GSimas/EEL7801/site/images/paloma1.jpg

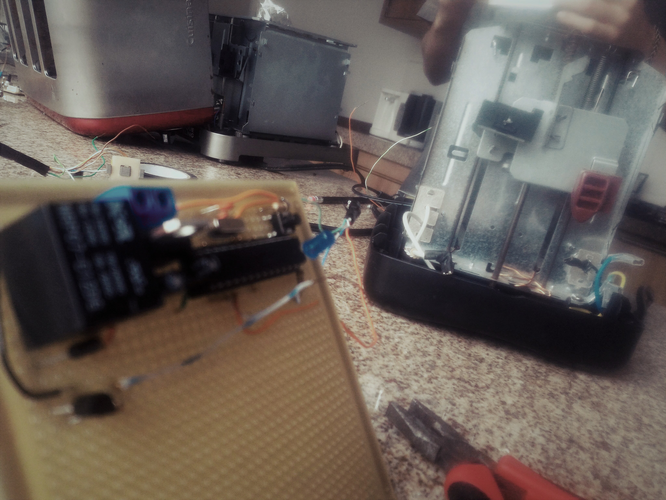
site/images/paloma1.jpg
