GSimas/EEL7801/site/images/code-min.jpg

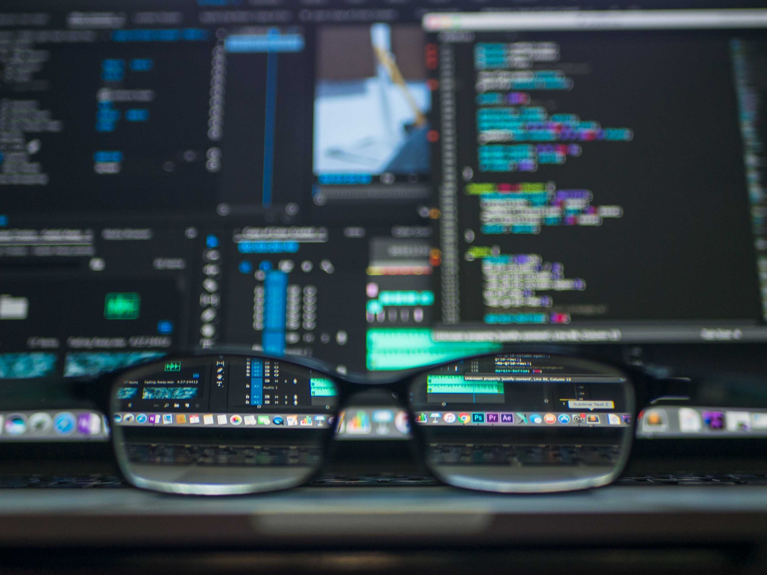
site/images/code-min.jpg
