GSimas/EEL7801/README.md

## ***EEL7801 - Projeto em Eletrônica Nível I***

> “The first thing you have to look at is **why**
you want to design something. Without
that you cannot have success. Then
you work out the **how** and then the
**what**...” - **Camille Kokozaki**

**Website do Repositório:** [EEL7801](https://gsimas.github.io/EEL7801/)

**Curso**: [Engenharia Eletrônica](http://cagr.sistemas.ufsc.br/relatorios/curriculoCurso?curso=235) - Universidade Federal de Santa Catarina ([UFSC](ufsc.br)), Florianópolis, SC, Brasil

**Ementa**: Desenvolver habilidades de trabalho em equipe e de auto-aprendizagem a partir da solução de
problemas encontrados na sociedade, cujas soluções passem pela aplicação de métodos e técnicas da engenharia
eletrônica.

**Horas-Aula:** 54

**Nome do Projeto**: P.A.L.O.M.A. (Projeto de Aquecedor Local Operado por Microcontrolador ATMEGA)

**Integrantes do Grupo**:

- [André Martins Pio de Mattos](https://github.com/andrempmattos)
- [Gustavo Simas da Silva](https://github.com/GSimas)
- Ygor Gaspar Pereira

**Dependências**

- Python (3 ou superior)
- Jupyter Notebook
- Arduino (arquivos .ino)

**Lista de Tarefas**

- [x] Bibliotecas e código de apresentação
- [x] Componentes básicos (Arduino, relé, switch de contato, placa fenolite, ...)
- [x] Decidir/Construir/Adaptar estrutura
- [x] Verificar e testar resistência (desmontar e consertar torradeira)
- [x] Componentes adicionais (resistores, transistores, capacitores, ...)
- [x] Arrumar emenda de resistência
- [x] Verificar e consertar problema de contato com malha de terra
- [x] Analisar sistema para controle (~~desligamento de transformador~~, relé)
- [x] Ajustes em código (sistema de controle, segurança)
- [x] **Primeiro Protótipo (05/10)**
- [x] Aquisição de materiais adicionais (fita kapton, placa de mica, jumpers, dobradiça)
- [x] Confecção em PCB / Placa padrão com ilhas
- [x] Troca de placa de mica danificada
- [x] Troca de componentes danificados (ATMEGA, 7805, LED)
- [x] Ajustes na placa da torradeira (relé, botão cancela bobina, separação controle/aquecimento)
- [x] Integração fonte celular (9V / 12V) + PCB desenvolvida + placa torradeira
- [x] Pintar Tampa, posicionar switch
- [x] Inserção do Display LCD na estrutura da torradeira
- [x] Posicionamento do 1º sensor de temperatura
- [x] Consertar Formulário de Contato do site
- [x] **Segundo Protótipo (09/11)**
- [ ] Posicionamento do 2º sensor de temperatura
- [ ] Reunião Conaq/Professor sobre Pasteurização
- [ ] Fixar alavanca para não atingir placa frontal
- [x] Ajustar resistores para contraste do Display
- [x] Aplicar fita Kapton em partes restantes para isolamento
- [x] Modificações código (funções não-recursivas, timer, calibração, escada invertida)
- [x] Elaborar Curvas de Aquecimento
- [x] Adaptações e testes finais (validação)
- [x] **Terceiro Protótipo/Versão Definitiva (23/11)**
- [x] Documentação (Tutorial - usuário e desenvolvedor)
- [x] Finalização do site
- [x] **Apresentação Final (23/11 ou 30/11)**
- [ ] Aperfeiçoamentos pós-semestre

Referências:

- [Prof. Fernando Rangel de Sousa](http://rangel.paginas.ufsc.br/)
- [Empresa Júnior CONAQ](http://conaq.com.br/)
- [Minhas Engenhocas](https://minhasengenhocas.wordpress.com/)
- [Prof. Aldo von Wangenheim](http://www.inf.ufsc.br/~aldo.vw/)

UFSC CTC
