GSimas/EEL7801/Apresentacoes/Cronograma Projeto Eletronica I.png

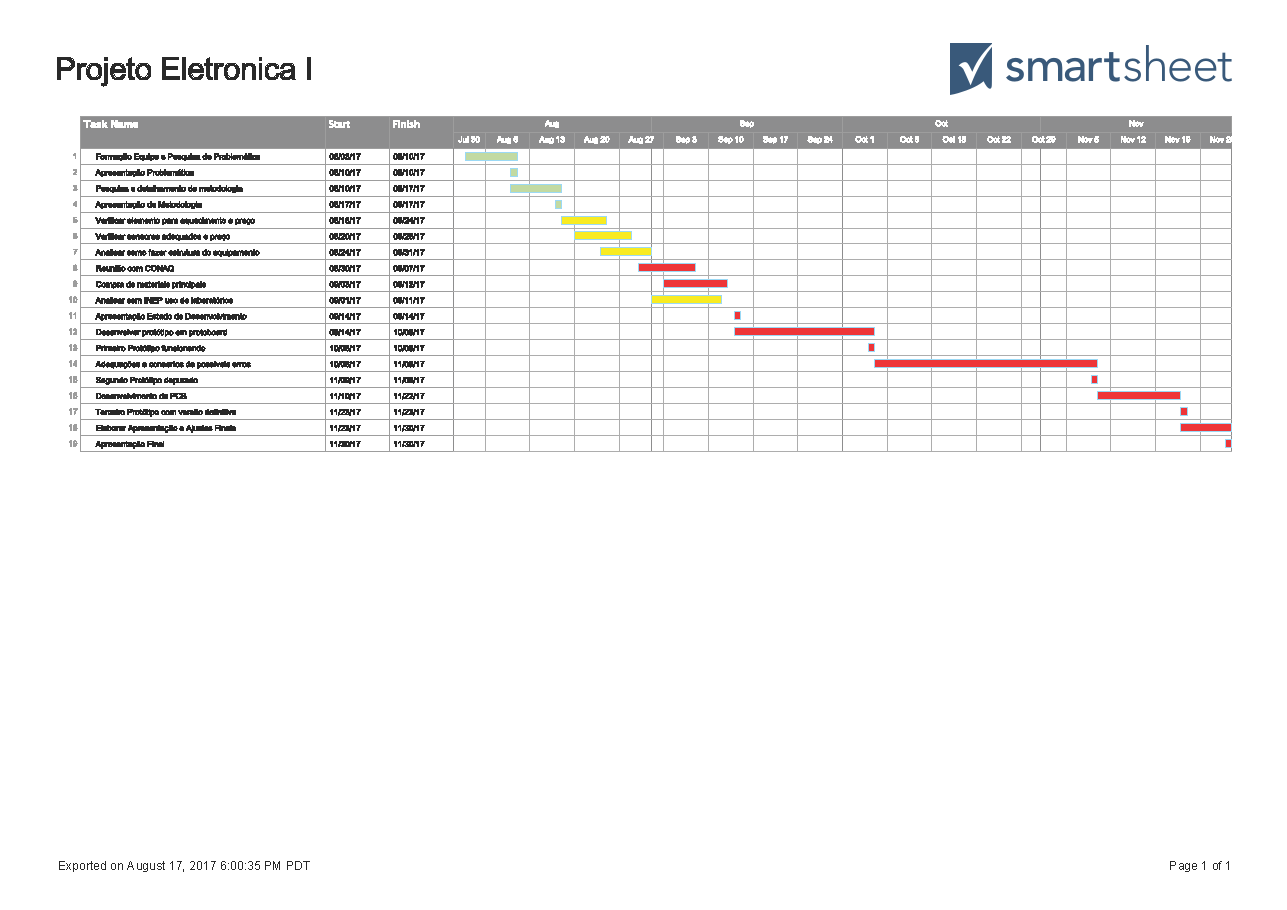
Apresentacoes/Cronograma Projeto Eletronica I.png
