GSimas/EEL7801/Imagens/IMG-20171001-WA0016.jpg

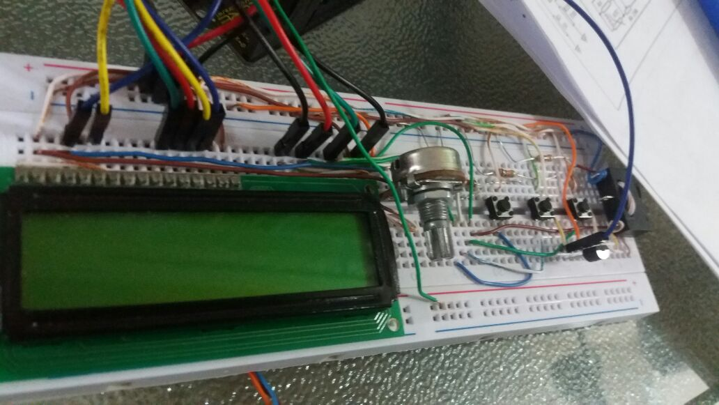
Imagens/IMG-20171001-WA0016.jpg
