GSimas/EEL7801/Imagens/IMG-20171001-WA0017.jpg

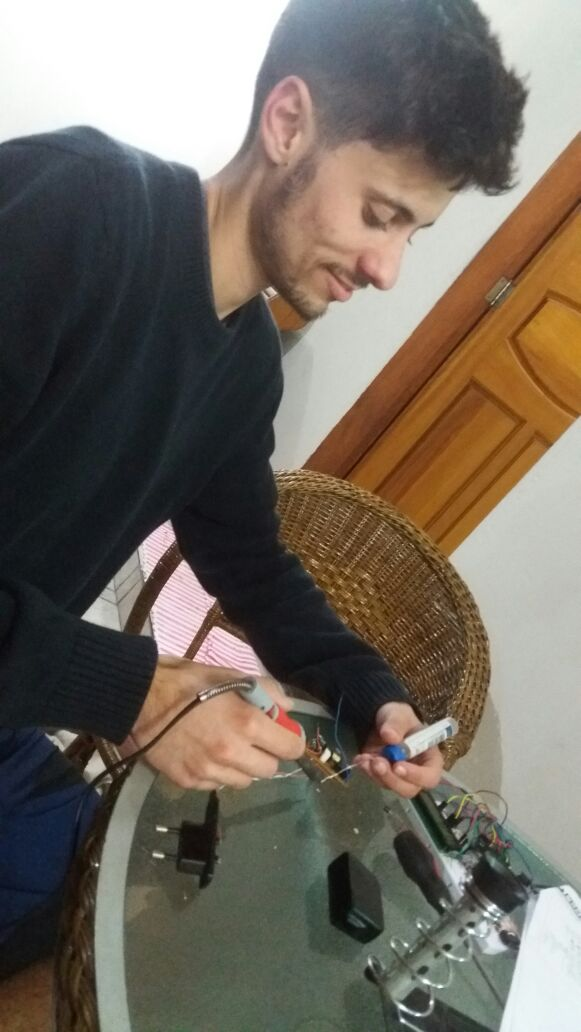
Imagens/IMG-20171001-WA0017.jpg
