GSimas/EEL7801/Imagens/IMG-20171001-WA0020.jpg

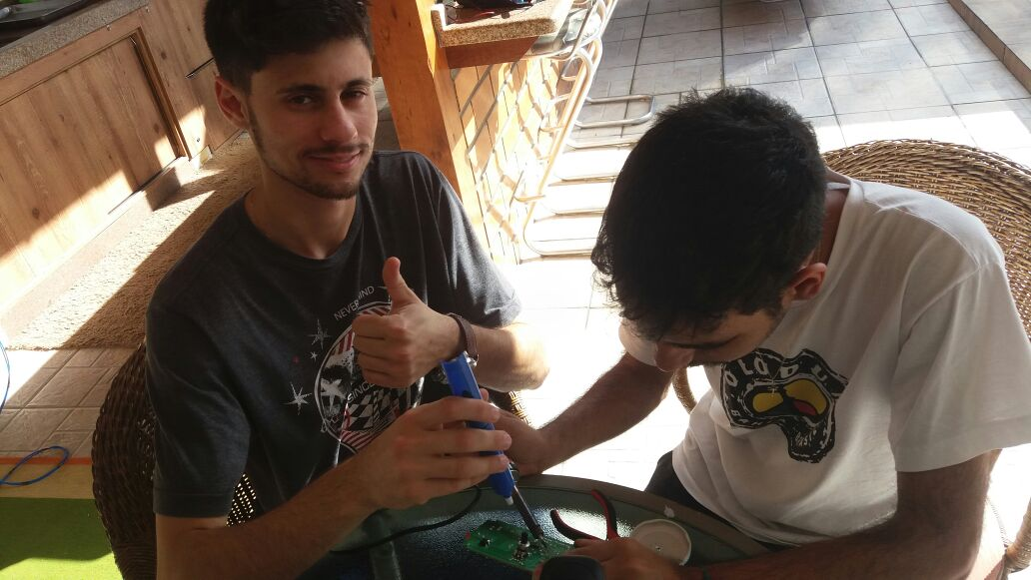
Imagens/IMG-20171001-WA0020.jpg
