GSimas/EEL7801/Imagens/IMG-20171001-WA0021.jpg

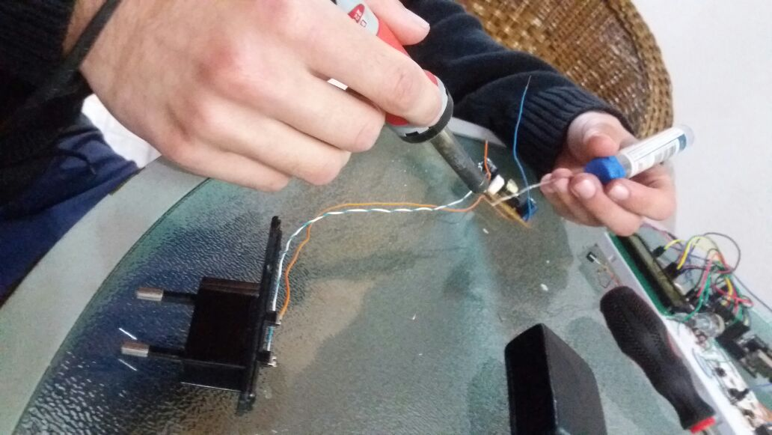
Imagens/IMG-20171001-WA0021.jpg
