GSimas/EEL7801/Imagens/IMG-20171001-WA0023.jpg

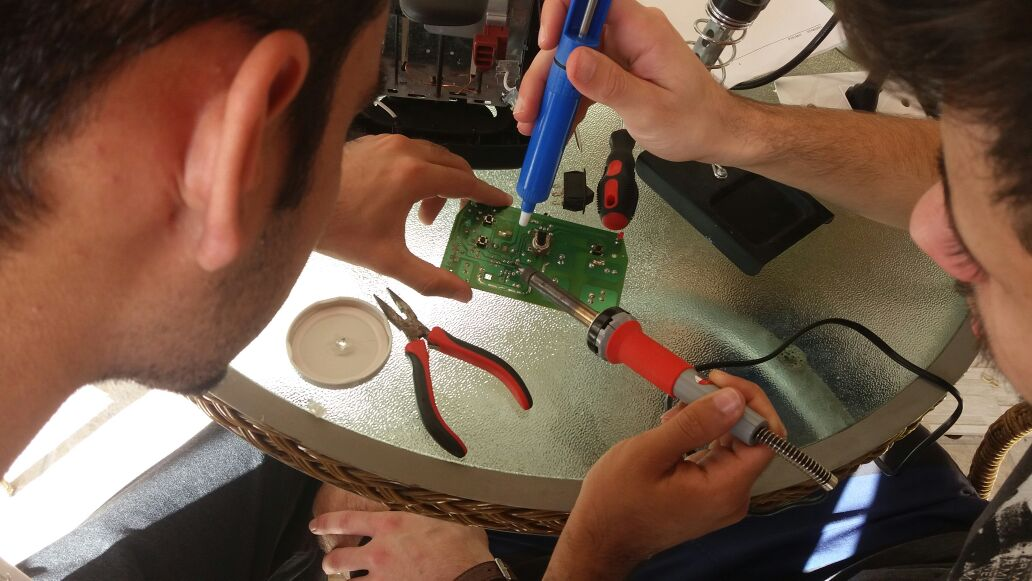
Imagens/IMG-20171001-WA0023.jpg
