GSimas/EEL7801/Imagens/IMG-20171105-WA0004.jpg

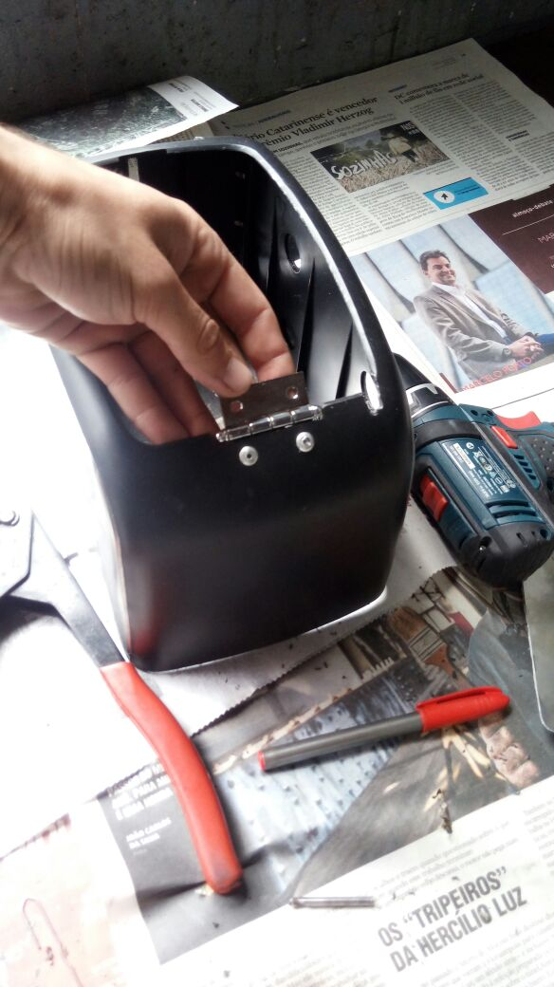
Imagens/IMG-20171105-WA0004.jpg
