GSimas/EEL7801/Imagens/IMG-20171105-WA0009.jpg

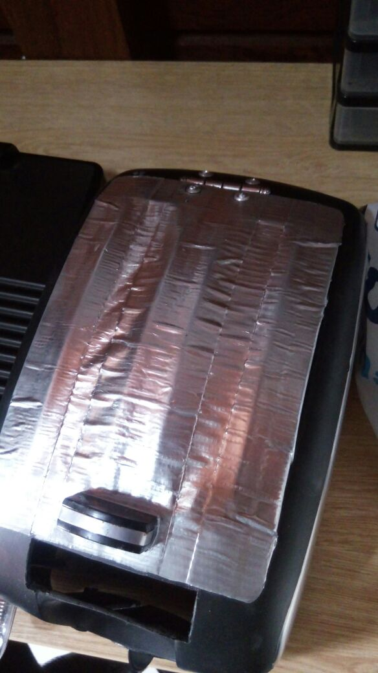
Imagens/IMG-20171105-WA0009.jpg
