GSimas/EEL7801/Imagens/P_20170908_141743.jpg

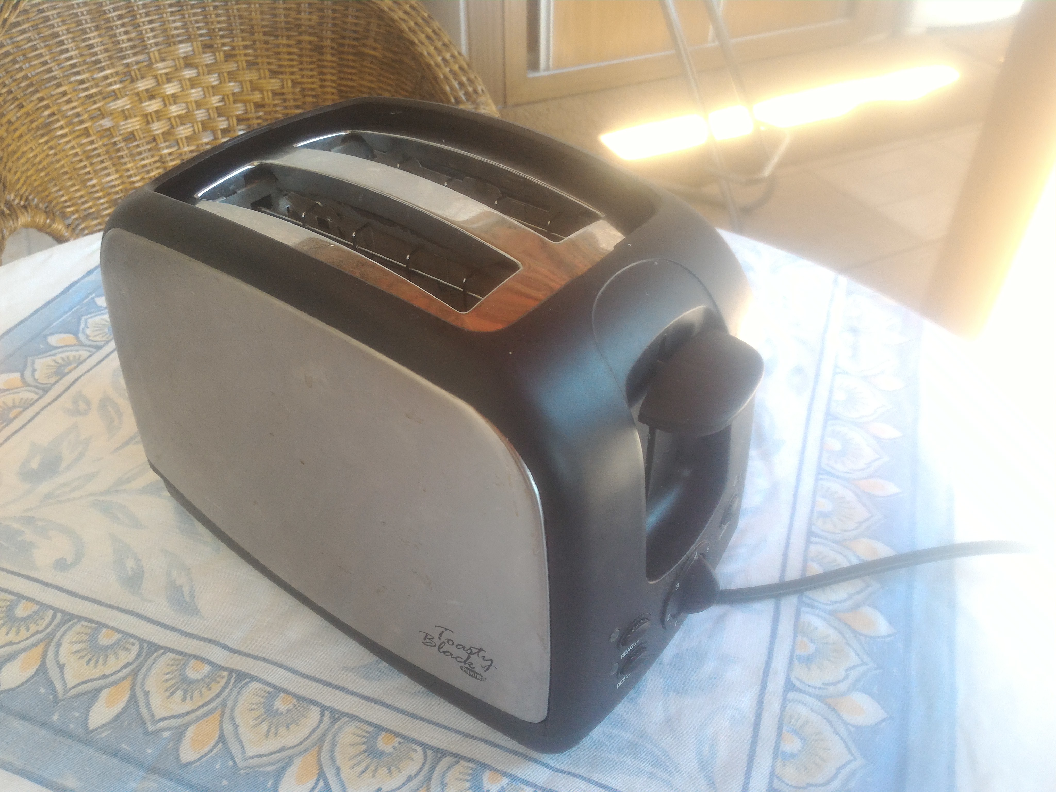
Imagens/P_20170908_141743.jpg
