GSimas/EEL7801/Imagens/P_20170908_141812.jpg

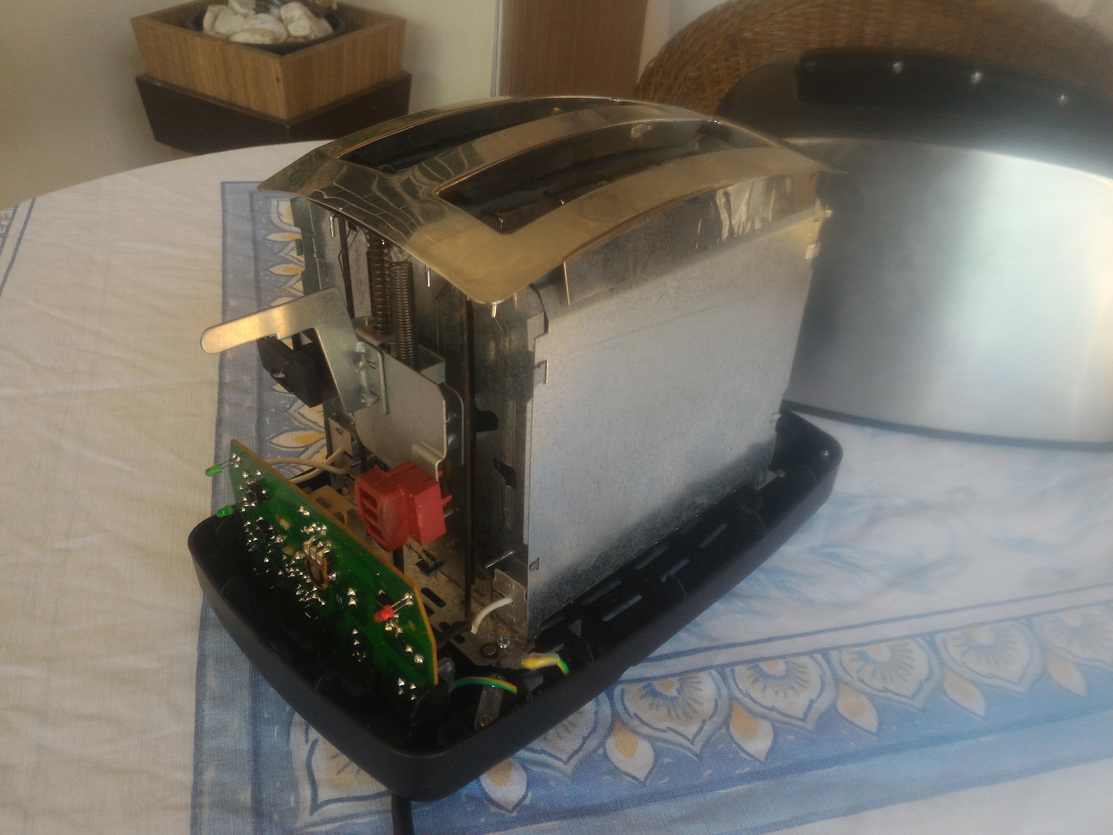
Imagens/P_20170908_141812.jpg
