GSimas/EEL7801/Imagens/P_20170908_174322.jpg

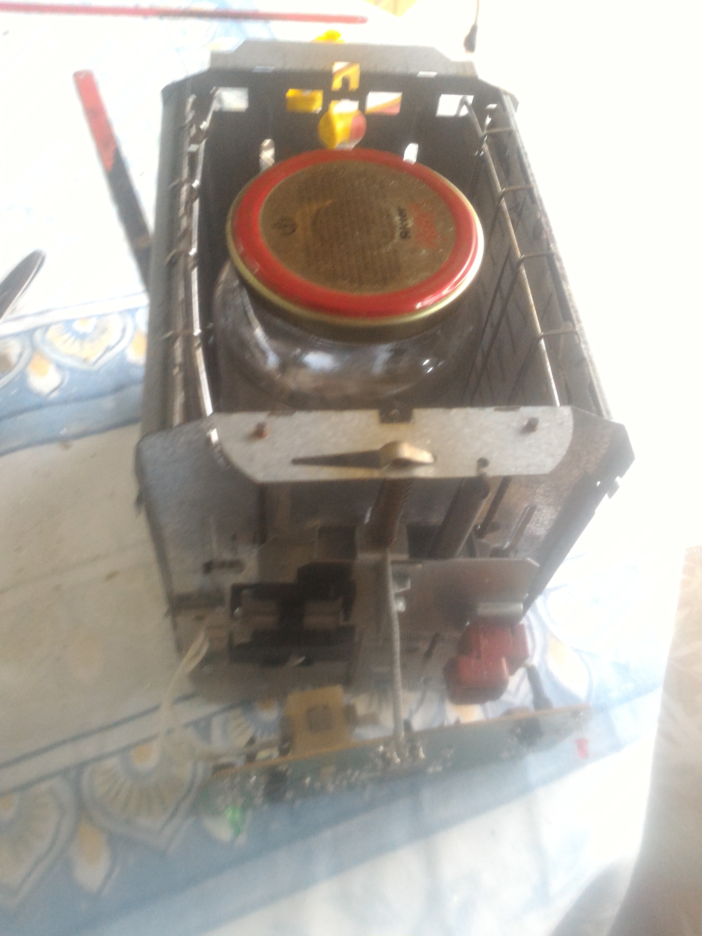
Imagens/P_20170908_174322.jpg
