GSimas/EEL7801/Imagens/P_20170908_174330.jpg

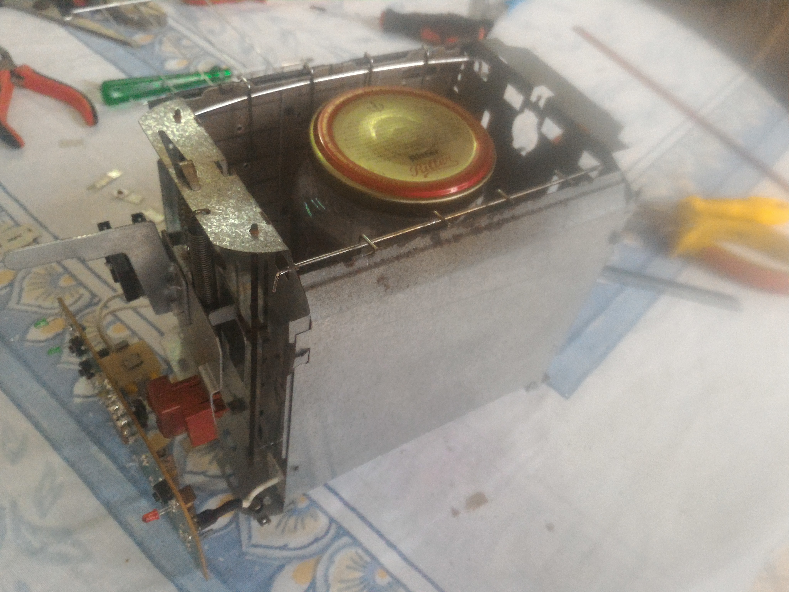
Imagens/P_20170908_174330.jpg
