GSimas/EEL7801/Imagens/P_20170908_184352.jpg

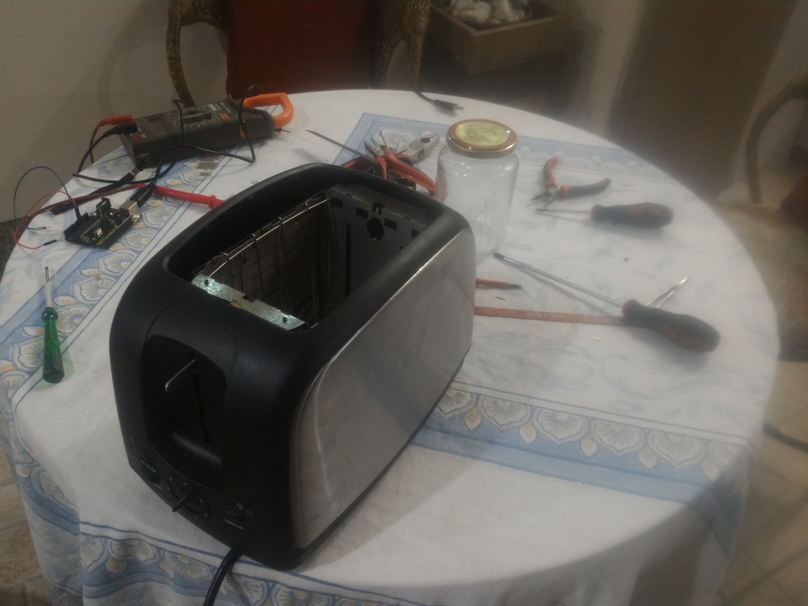
Imagens/P_20170908_184352.jpg
