GSimas/EEL7801/Imagens/P_20170908_184403.jpg

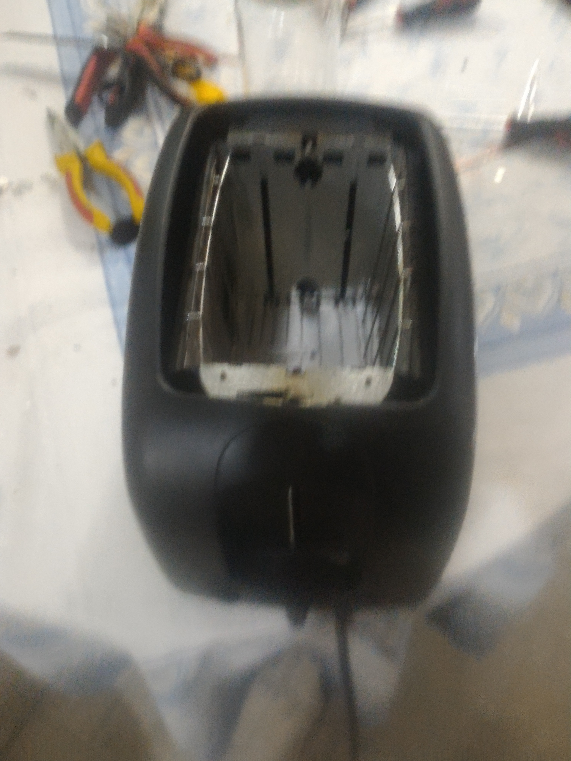
Imagens/P_20170908_184403.jpg
