GSimas/EEL7801/Imagens/P_20170908_184408.jpg

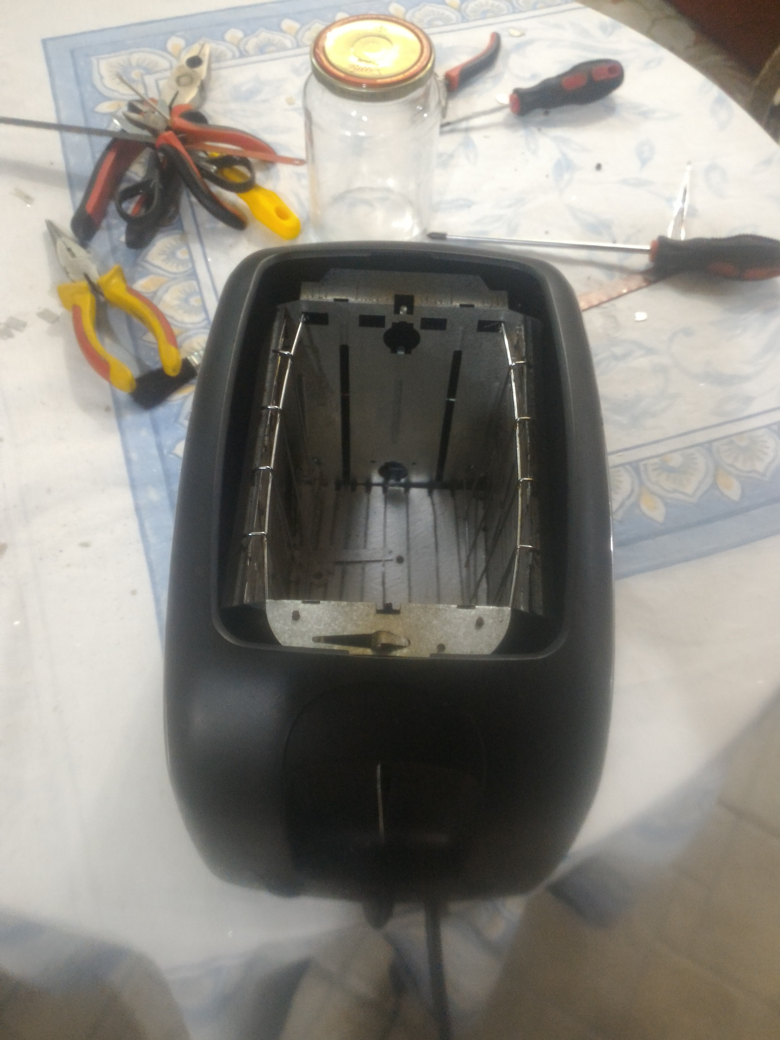
Imagens/P_20170908_184408.jpg
