GSimas/EEL7801/Imagens/P_20170908_184419.jpg

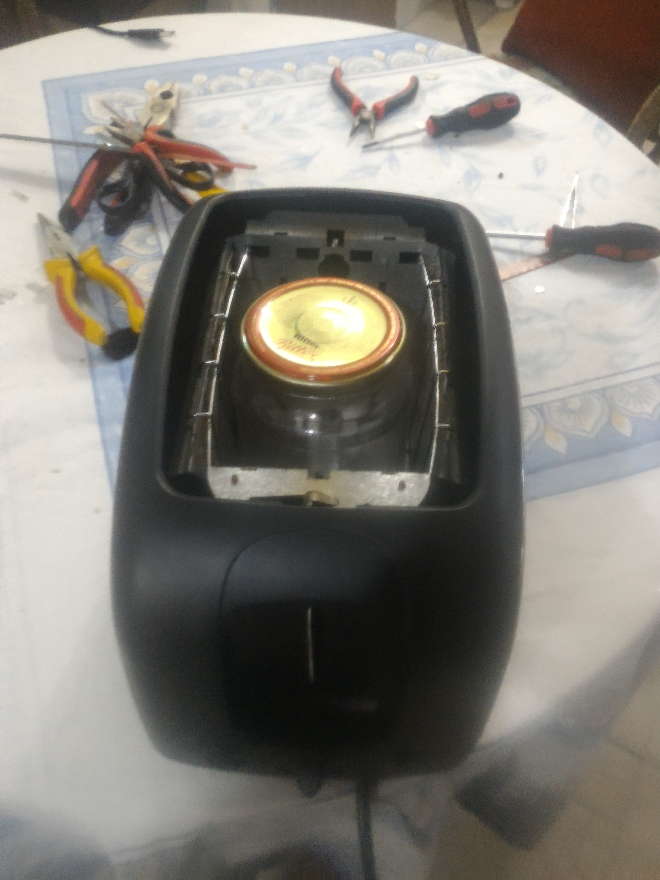
Imagens/P_20170908_184419.jpg
