GSimas/EEL7801/Imagens/P_20170914_170200.jpg

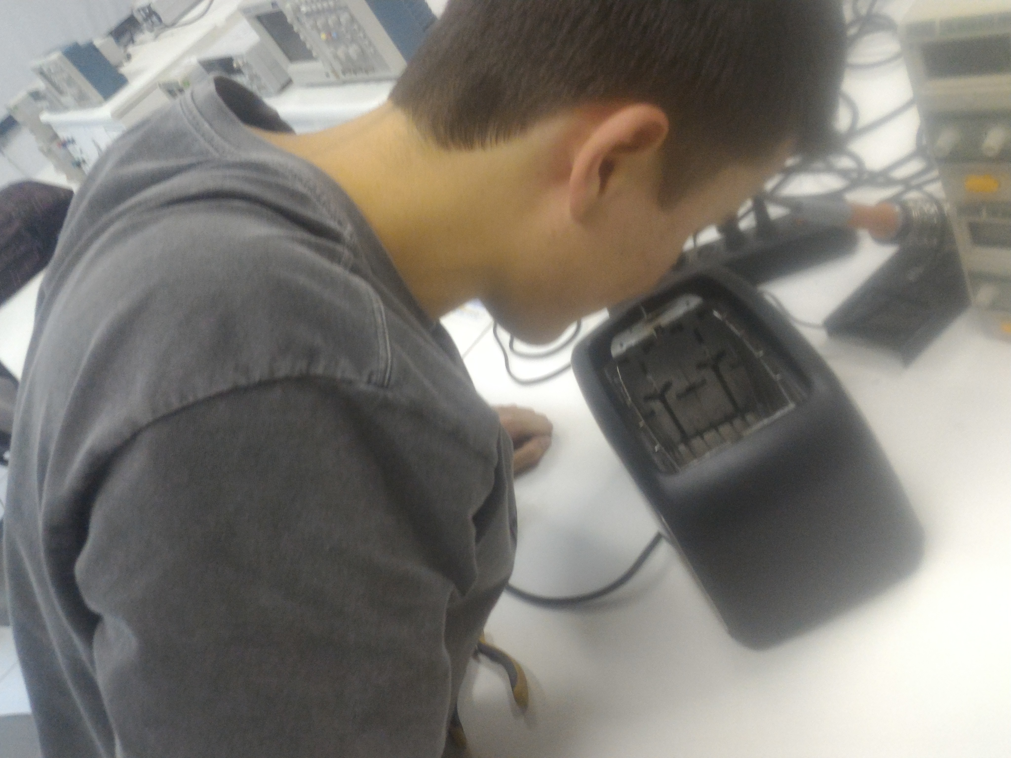
Imagens/P_20170914_170200.jpg
