GSimas/EEL7801/Imagens/P_20170914_170221.jpg

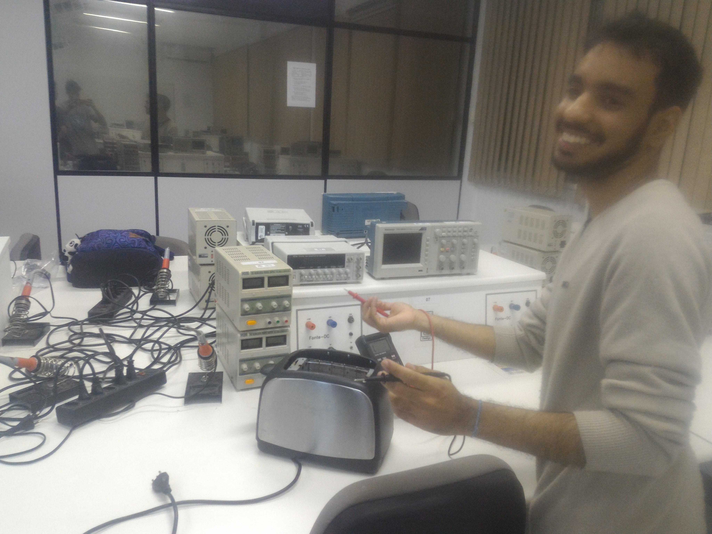
Imagens/P_20170914_170221.jpg
