GSimas/EEL7801/Imagens/P_20170914_170230.jpg

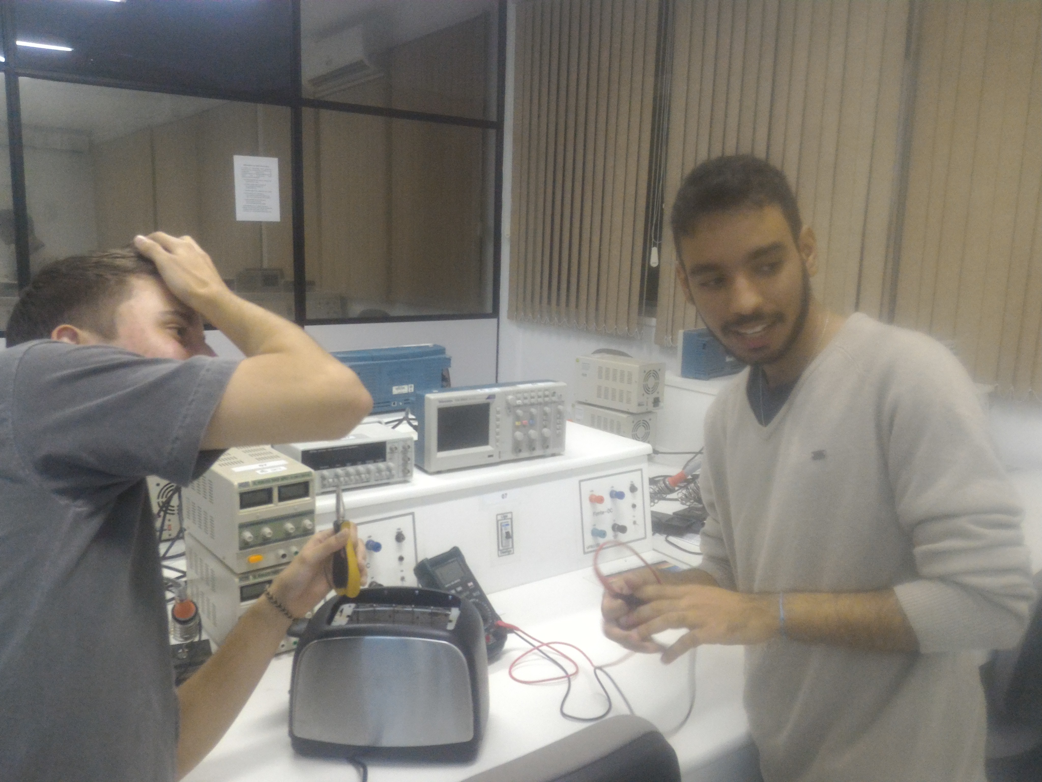
Imagens/P_20170914_170230.jpg
