GSimas/EEL7801/Imagens/P_20170914_170234.jpg

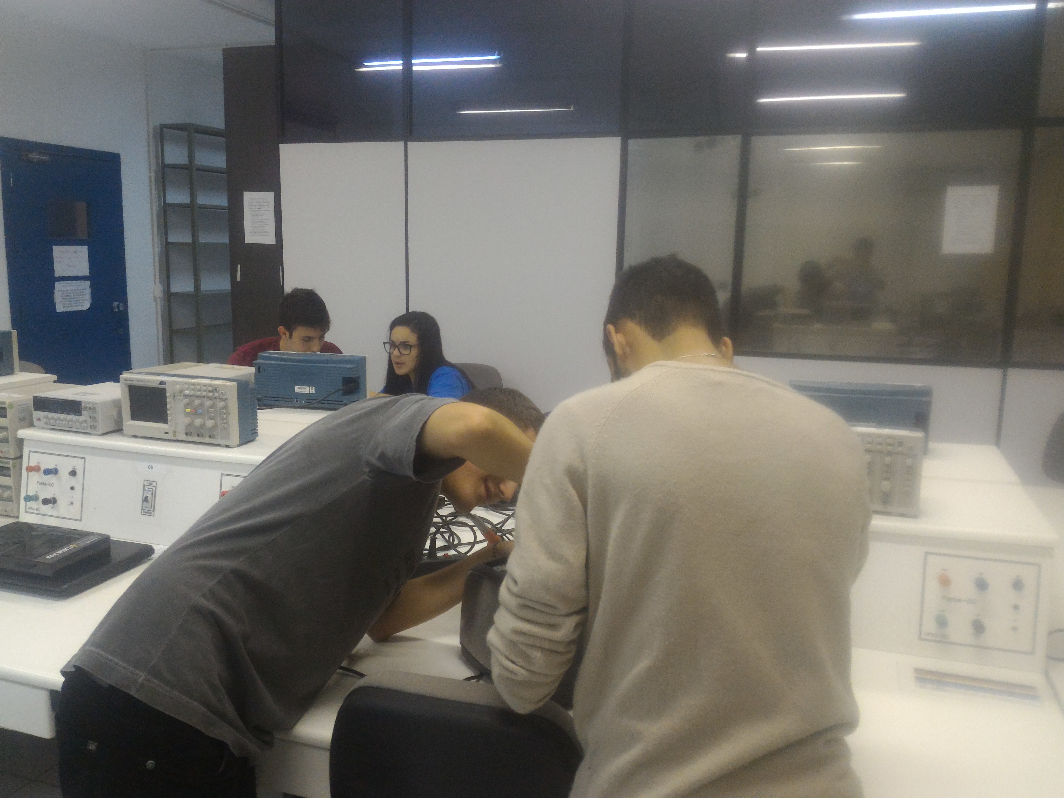
Imagens/P_20170914_170234.jpg
