GSimas/EEL7801/Imagens/P_20170914_170241.jpg

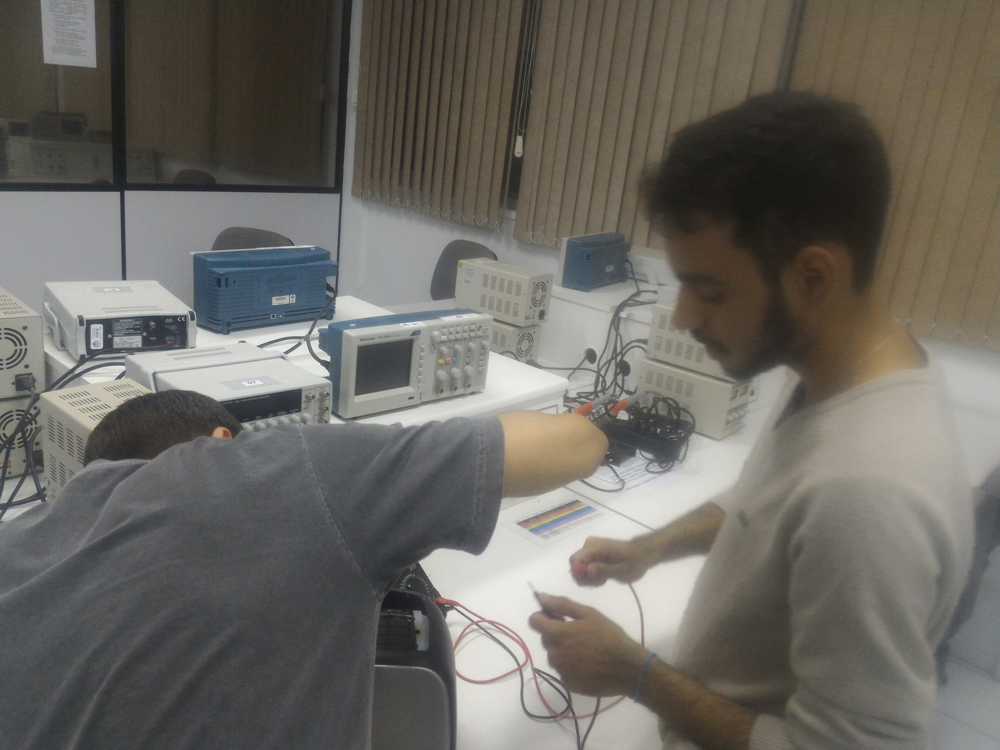
Imagens/P_20170914_170241.jpg
