GSimas/EEL7801/Imagens/P_20170914_170302.jpg

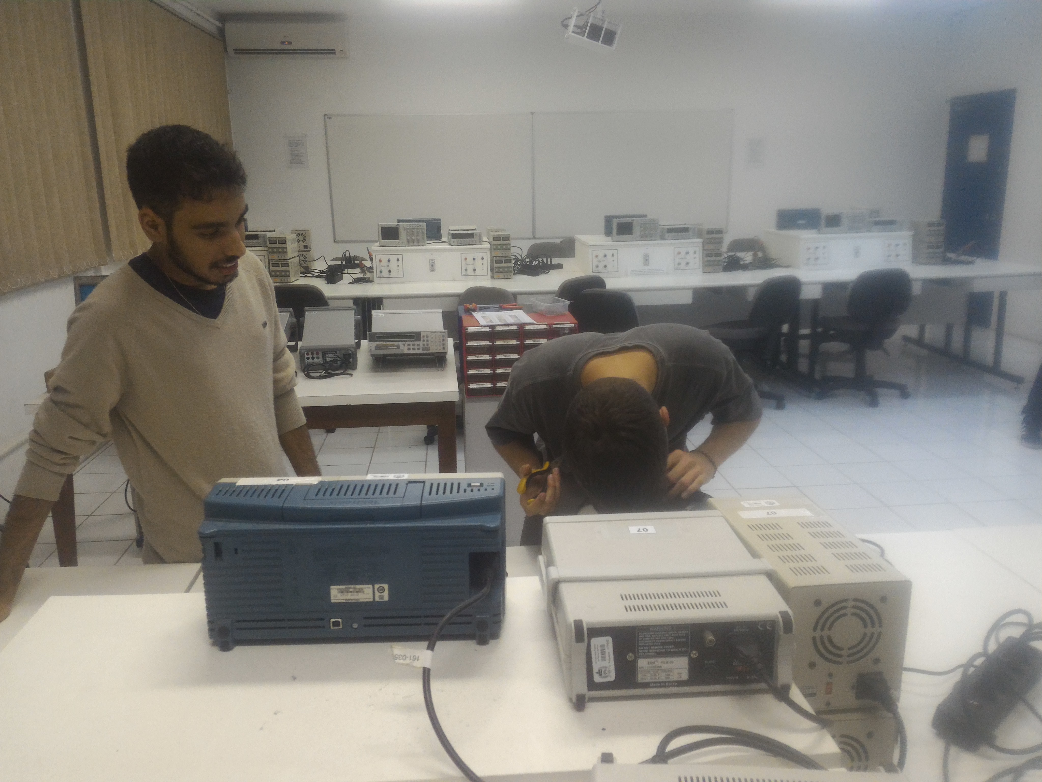
Imagens/P_20170914_170302.jpg
