GSimas/EEL7801/Imagens/P_20171103_164319.jpg

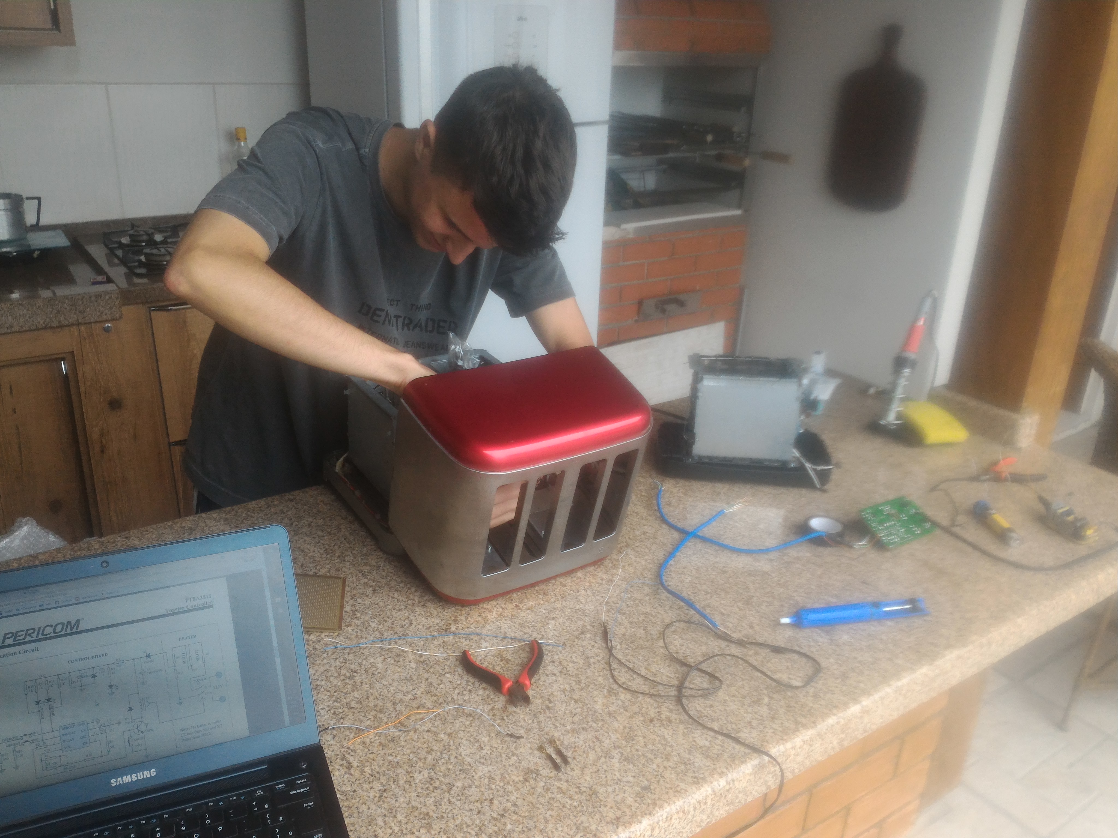
Imagens/P_20171103_164319.jpg
