GSimas/EEL7801/Imagens/P_20171103_164329.jpg

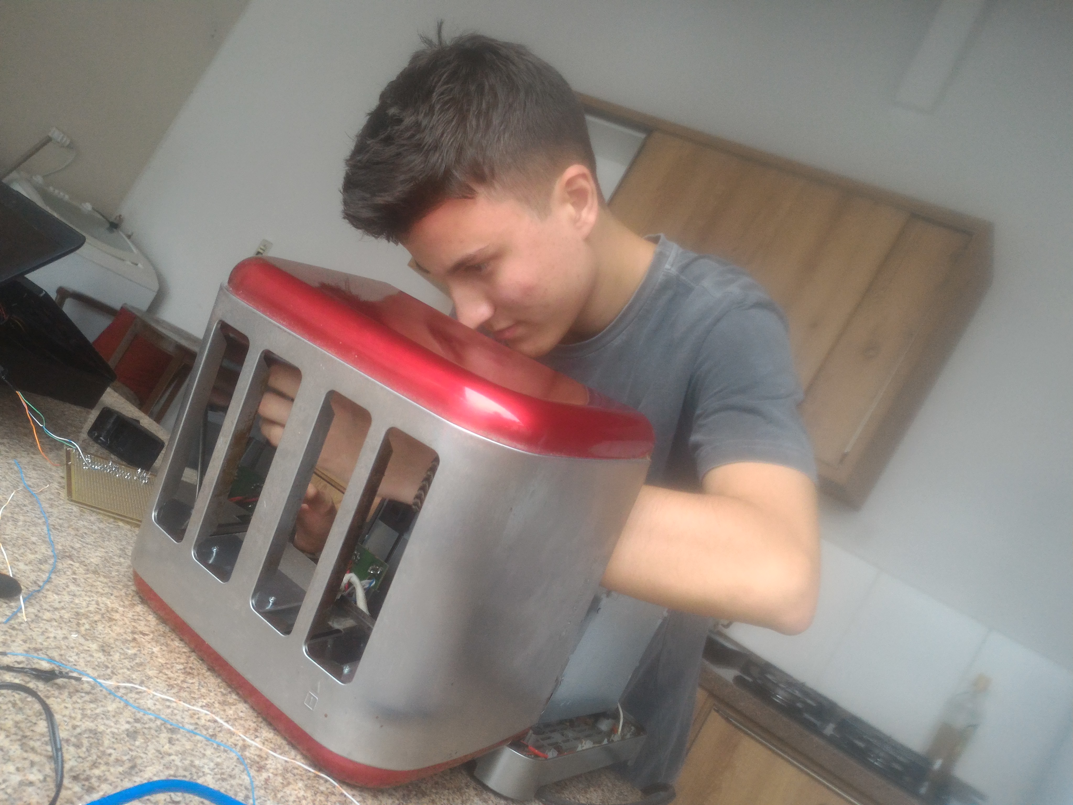
Imagens/P_20171103_164329.jpg
