GSimas/EEL7801/Imagens/P_20171103_164346.jpg

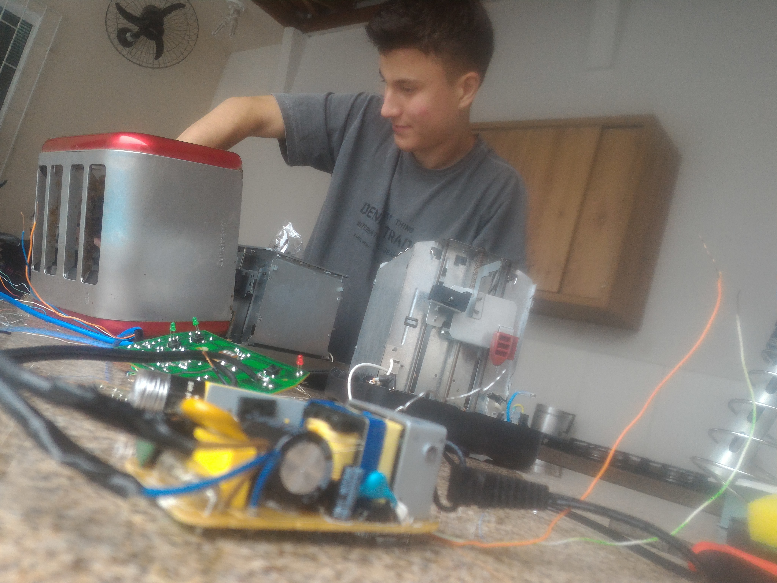
Imagens/P_20171103_164346.jpg
