GSimas/EEL7801/Imagens/P_20171103_175909.jpg

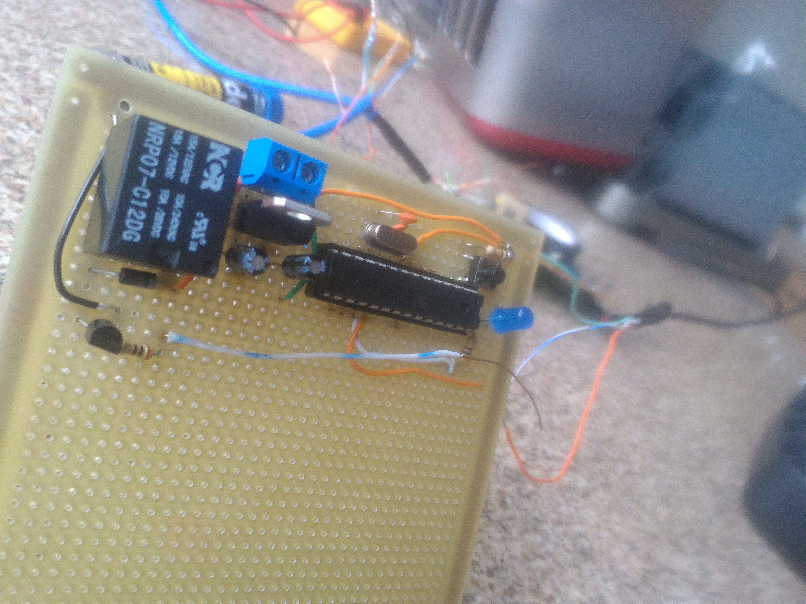
Imagens/P_20171103_175909.jpg
