GSimas/EEL7801/Imagens/P_20171103_175920.jpg

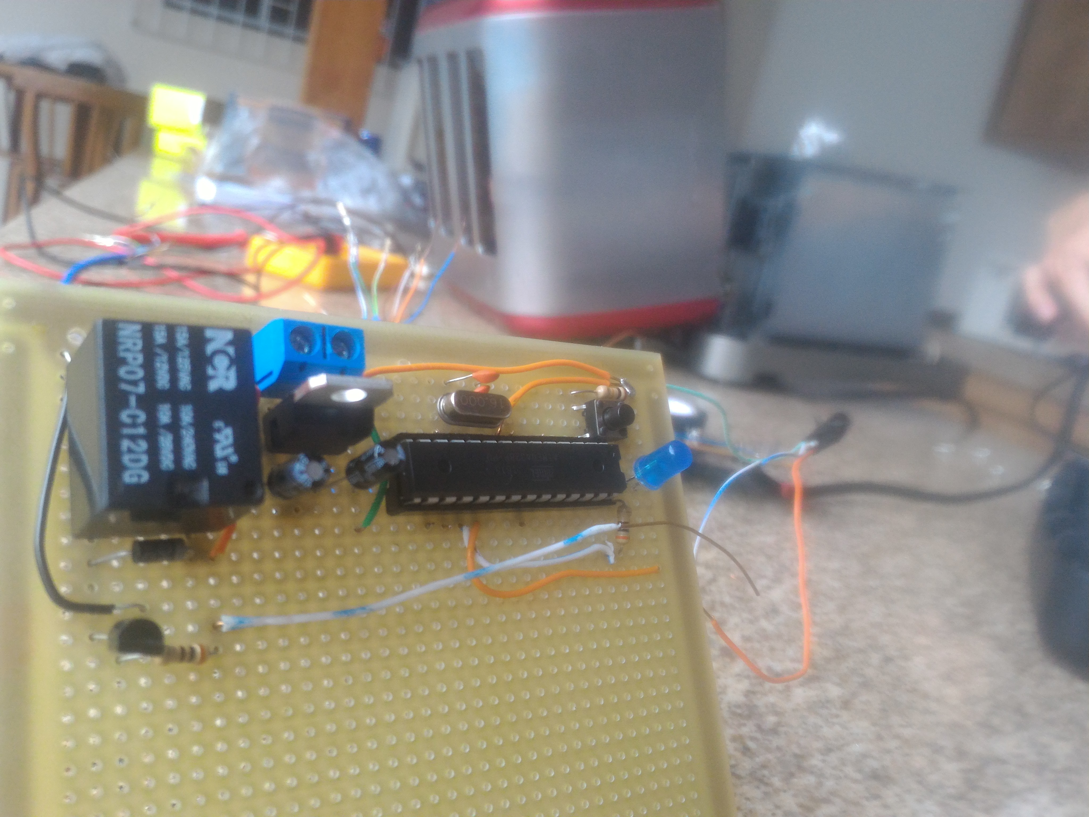
Imagens/P_20171103_175920.jpg
