GSimas/EEL7801/Imagens/P_20171103_175936.jpg

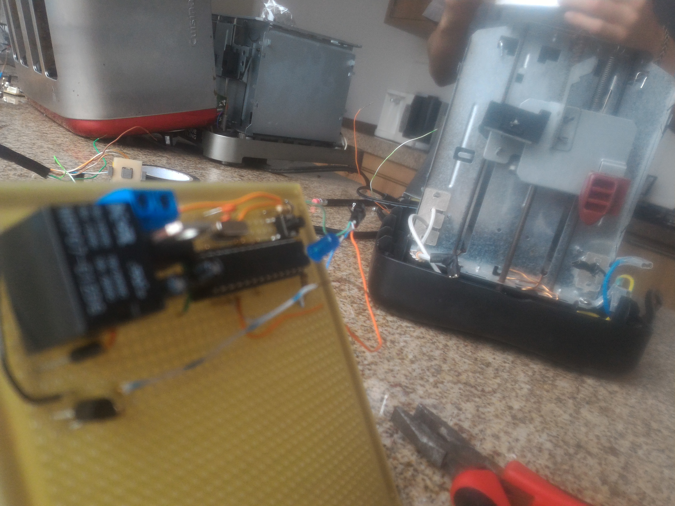
Imagens/P_20171103_175936.jpg
