GSimas/EEL7801/Imagens/P_20171103_182304.jpg

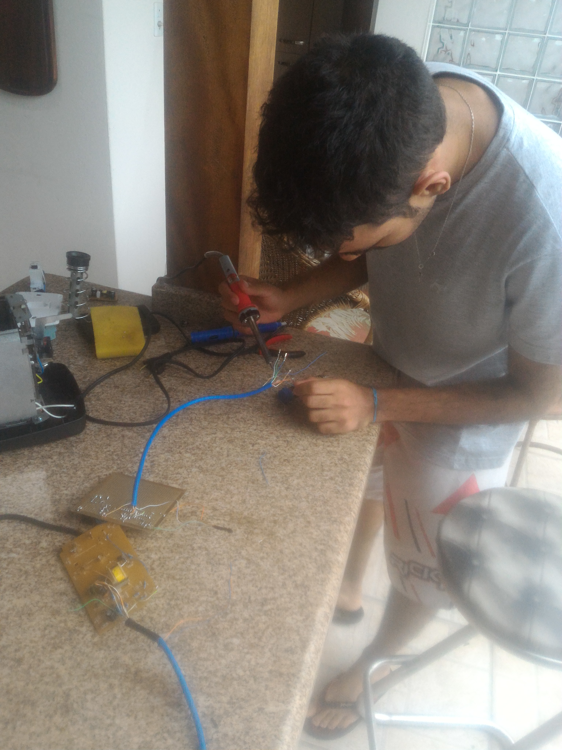
Imagens/P_20171103_182304.jpg
