GSimas/EEL7801/Imagens/P_20171103_204802.jpg

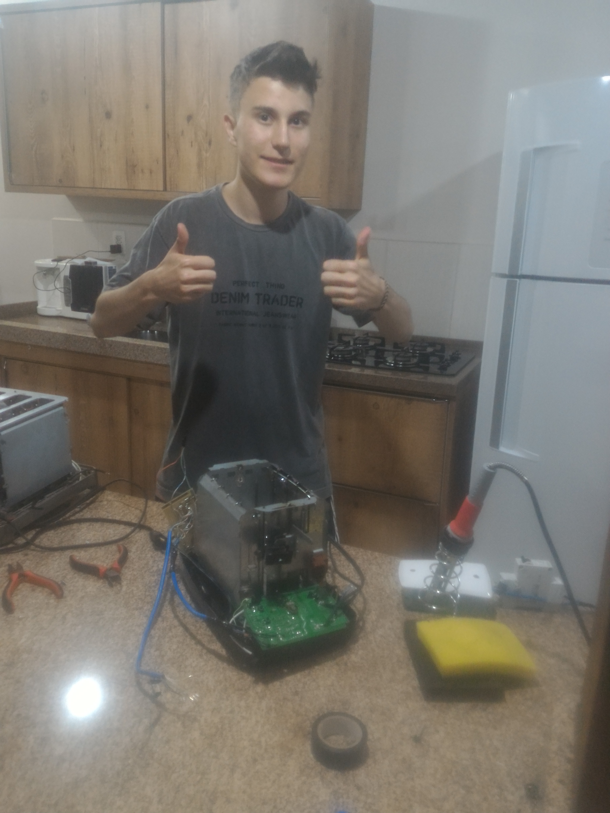
Imagens/P_20171103_204802.jpg
