GSimas/EEL7801/Imagens/P_20171103_232533.jpg

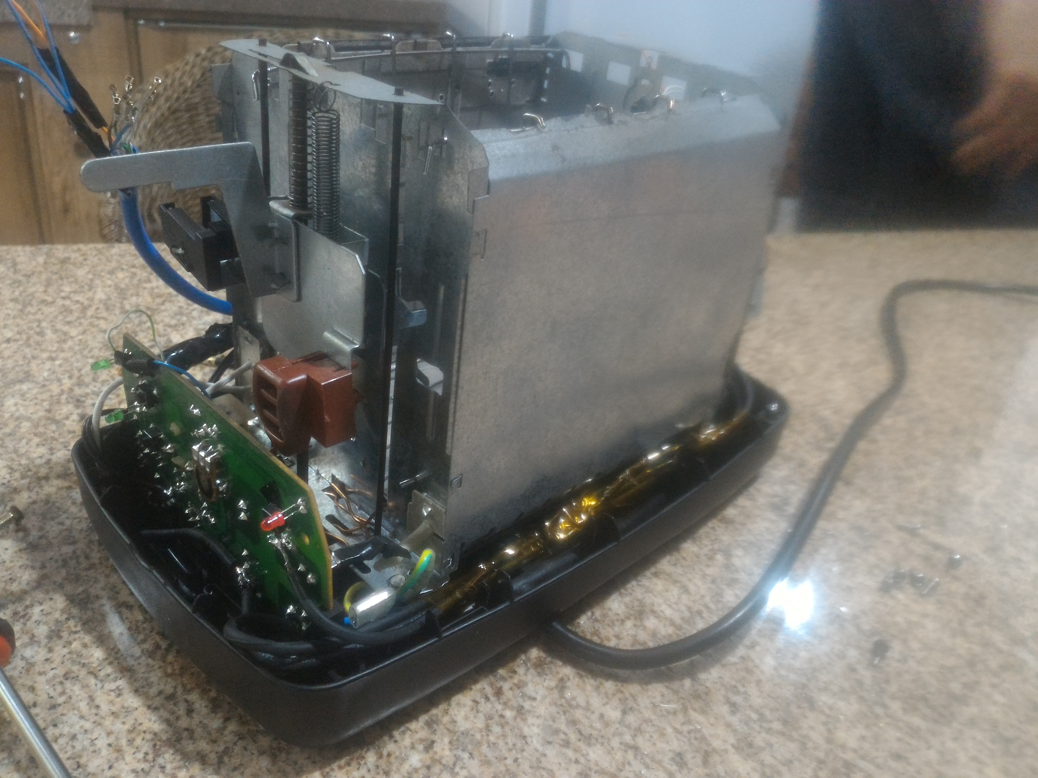
Imagens/P_20171103_232533.jpg
