GSimas/EEL7801/Imagens/P_20171103_232605.jpg

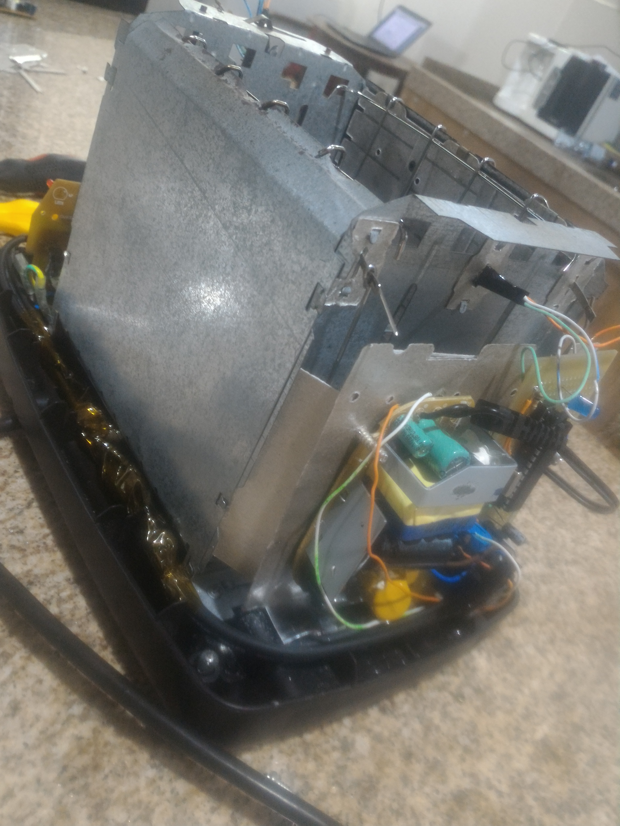
Imagens/P_20171103_232605.jpg
