GSimas/EEL7801/Imagens/P_20171104_140212.jpg

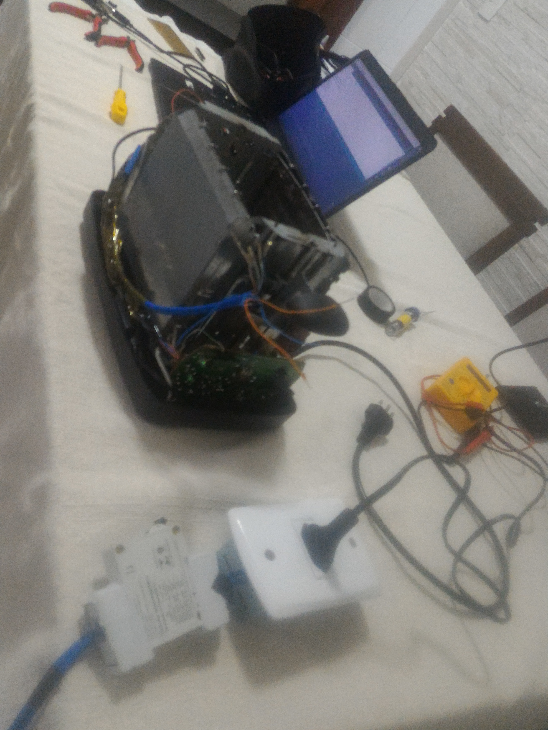
Imagens/P_20171104_140212.jpg
