GSimas/EEL7801/Imagens/P_20171119_194525.jpg

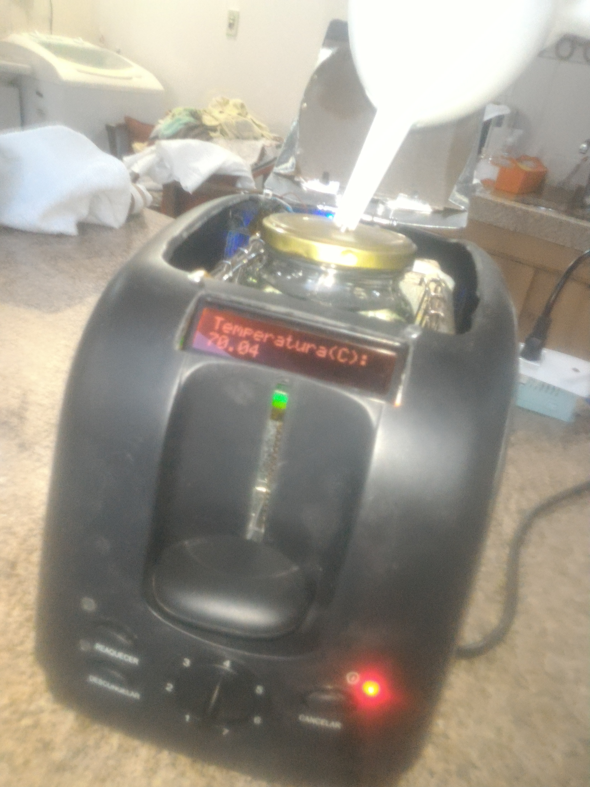
Imagens/P_20171119_194525.jpg
