GSimas/EEL7801/Imagens/P_20171119_194555.jpg

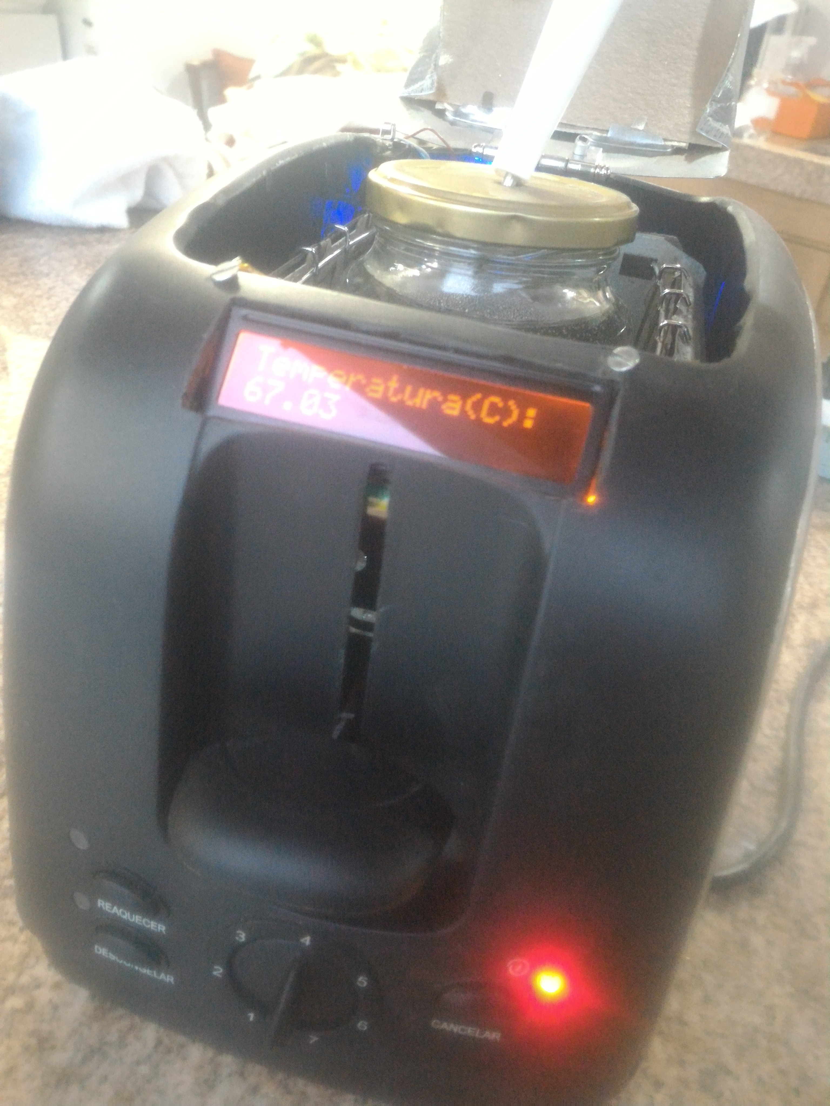
Imagens/P_20171119_194555.jpg
