GSimas/EEL7801/Imagens/P_20171119_202229.jpg

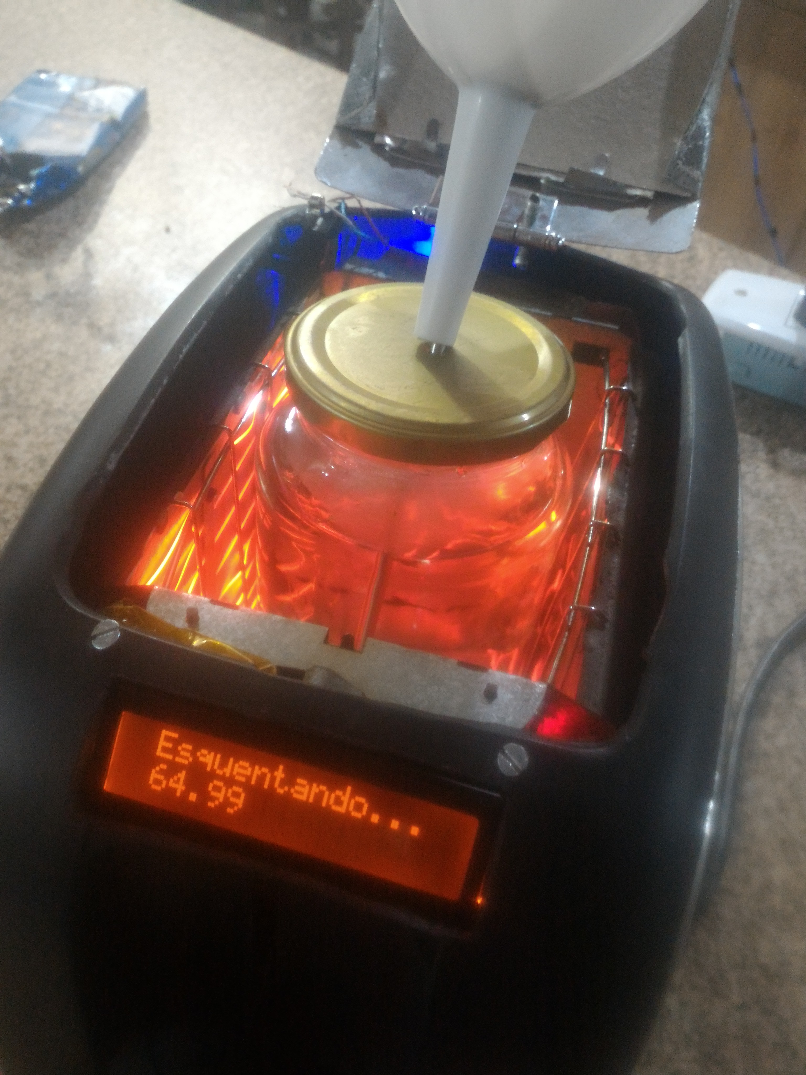
Imagens/P_20171119_202229.jpg
