GSimas/EEL7801/Imagens/P_20171119_211805.jpg

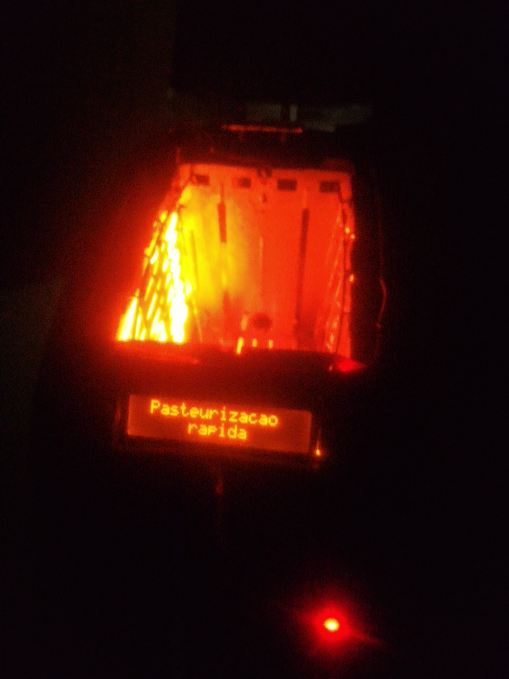
Imagens/P_20171119_211805.jpg
