GSimas/EEL7801/Imagens/P_20171119_211856_LL.jpg

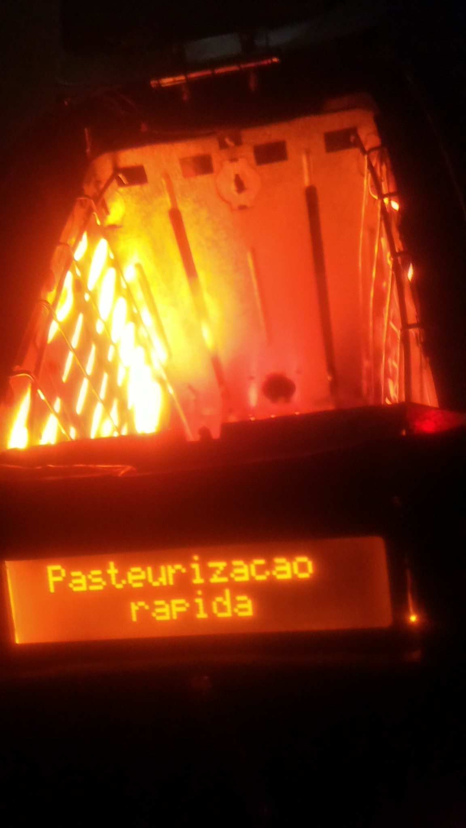
Imagens/P_20171119_211856_LL.jpg
