GSimas/EEL7801/Imagens/P_20171122_194645_1.jpg

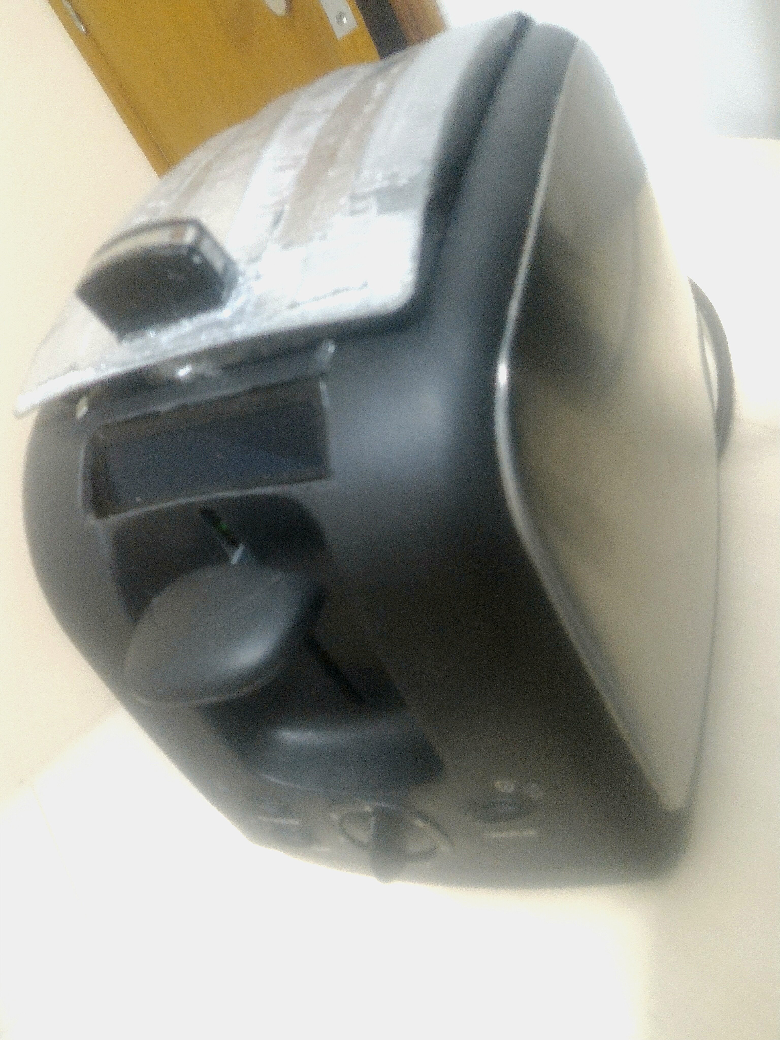
Imagens/P_20171122_194645_1.jpg
