GSimas/EEL7801/site/images/canvas_v2-min.jpg

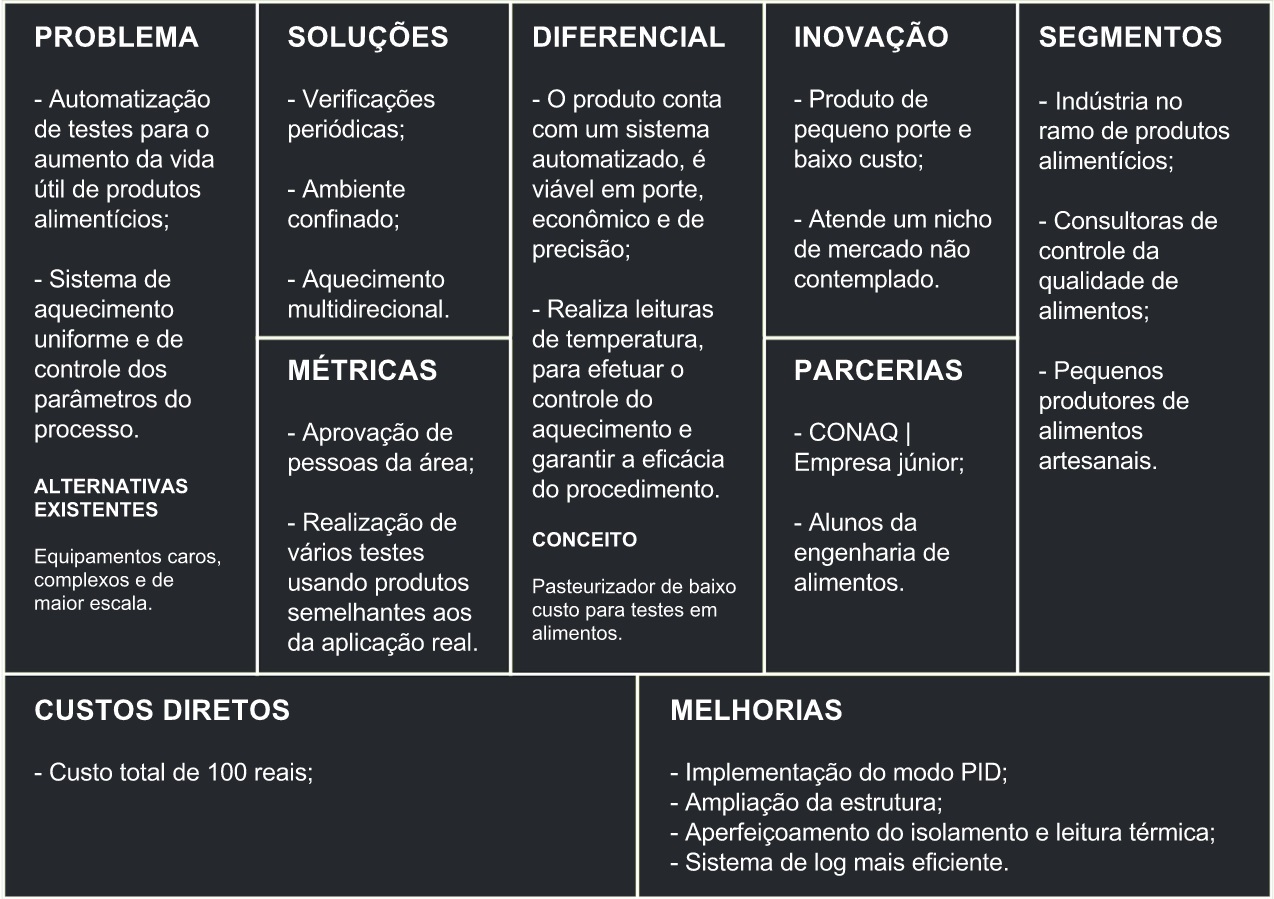
site/images/canvas_v2-min.jpg
