GSimas/EEL7801/site/images/paloma2.jpg

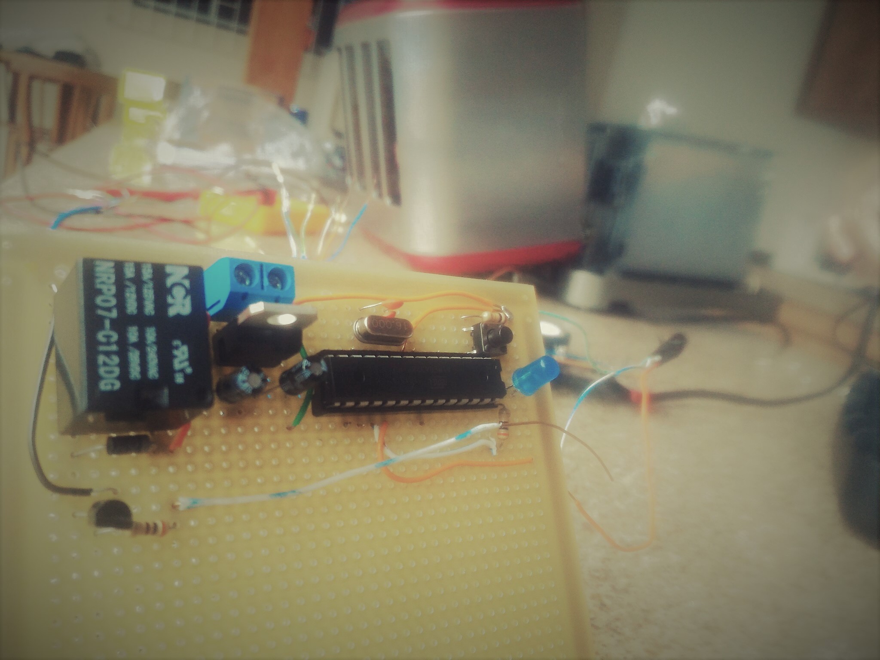
site/images/paloma2.jpg
