GSimas/EEL7801/site/images/paloma3.jpg

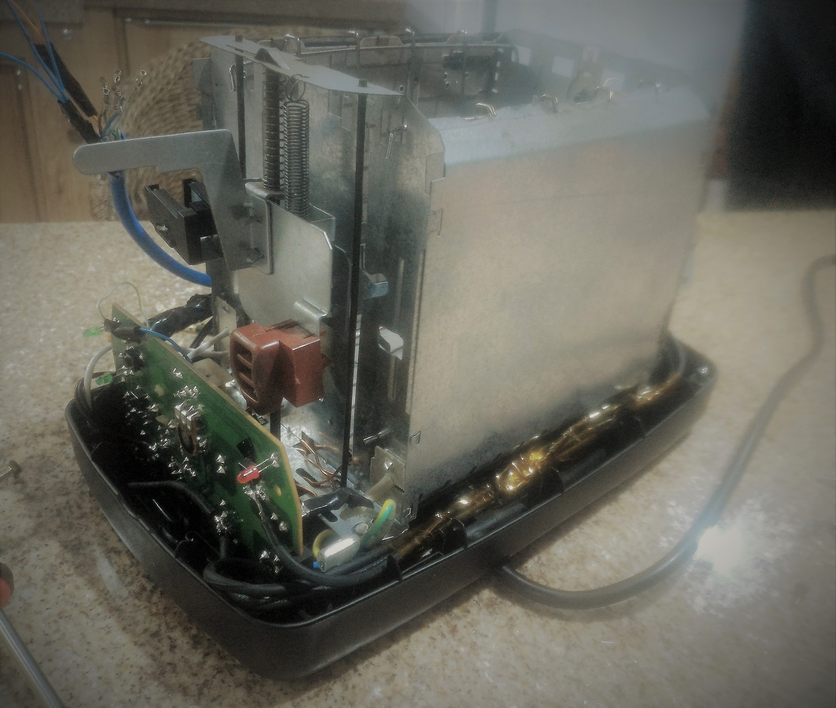
site/images/paloma3.jpg
