GSimas/EEL7801/site/images/paloma4.jpg

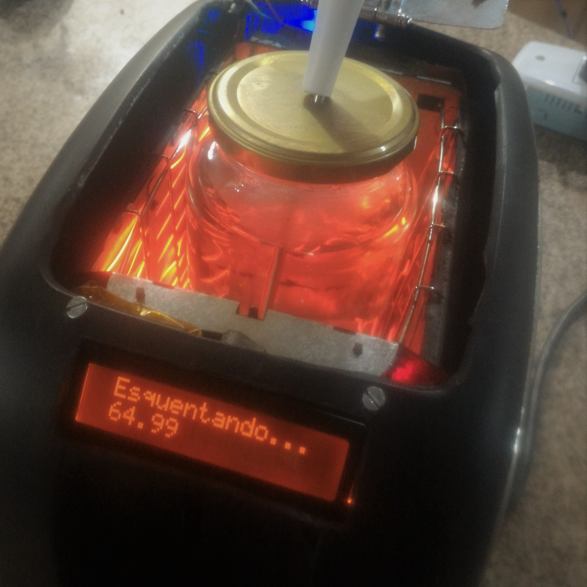
site/images/paloma4.jpg
