GSimas/EEL7801/site/images/pcb-min.jpg

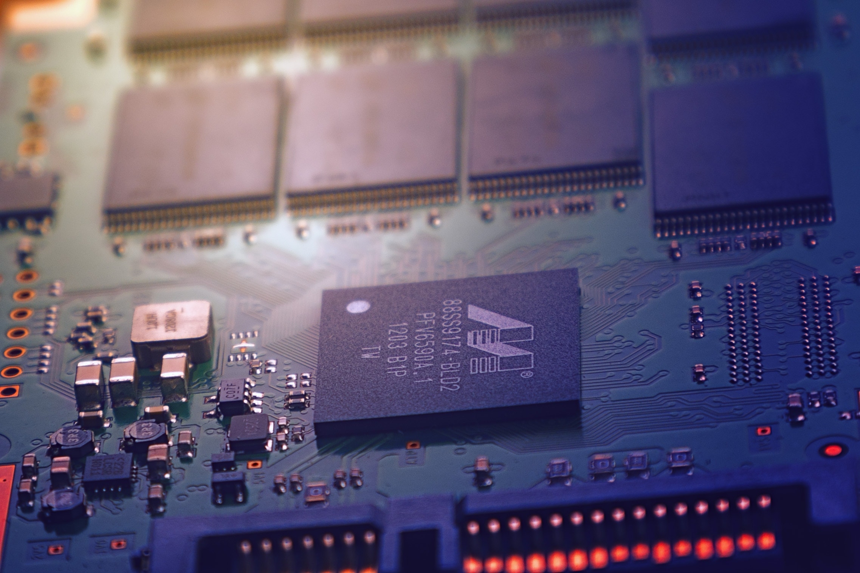
site/images/pcb-min.jpg
