GSimas/EEL7801/Apresentacoes/Problemática-ProjetoEletronica1.pptx

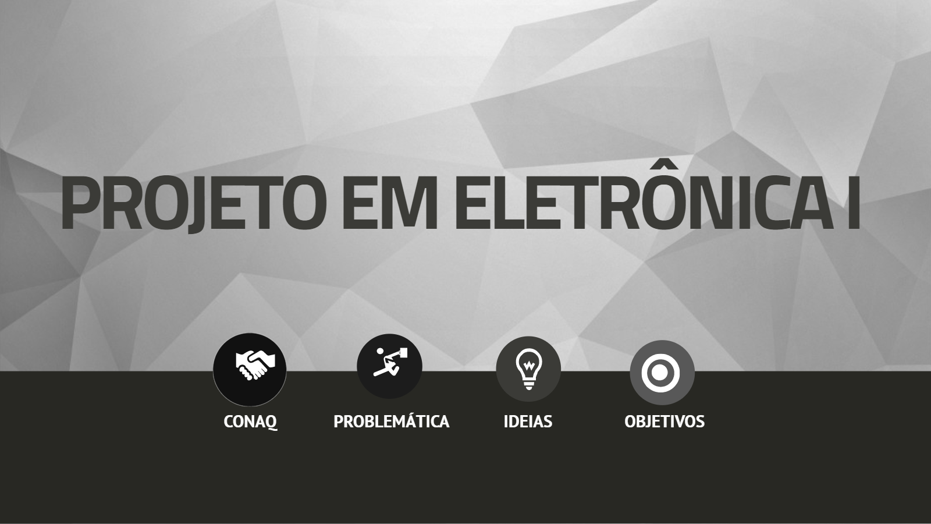
[picture p84: figure]

## Slide 2

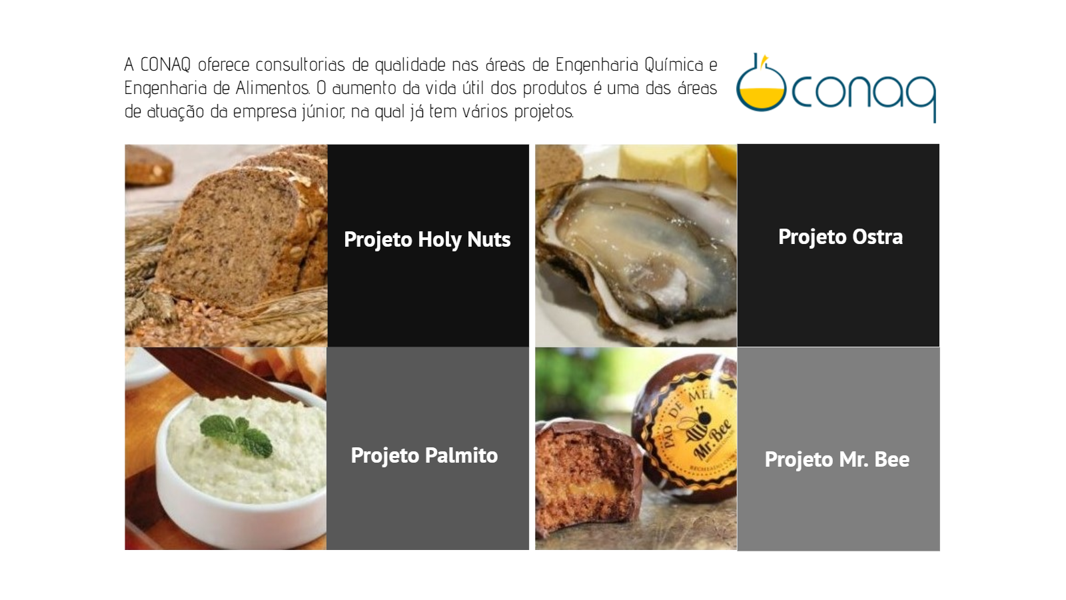
[picture p85: figure]

## Slide 3

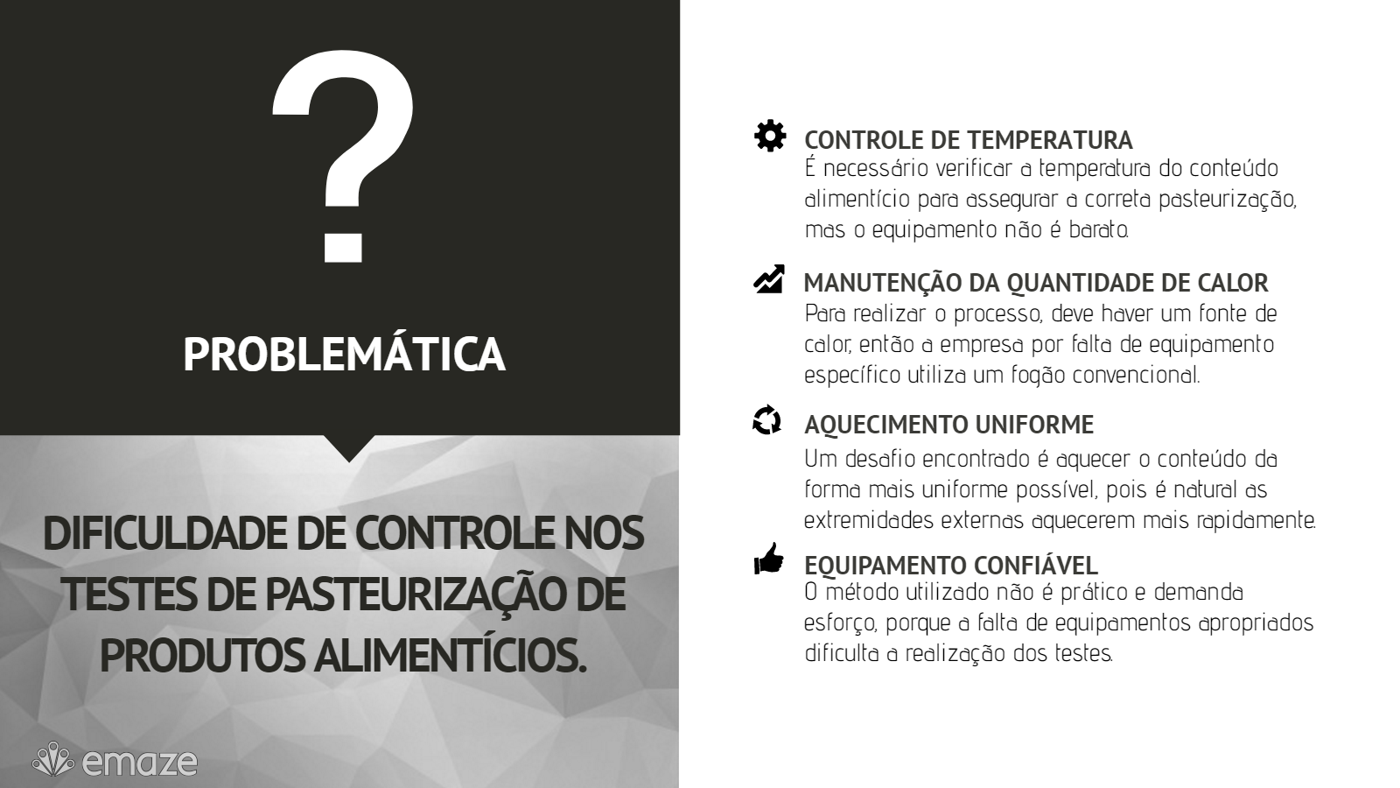
[picture p86: figure]

## Slide 4

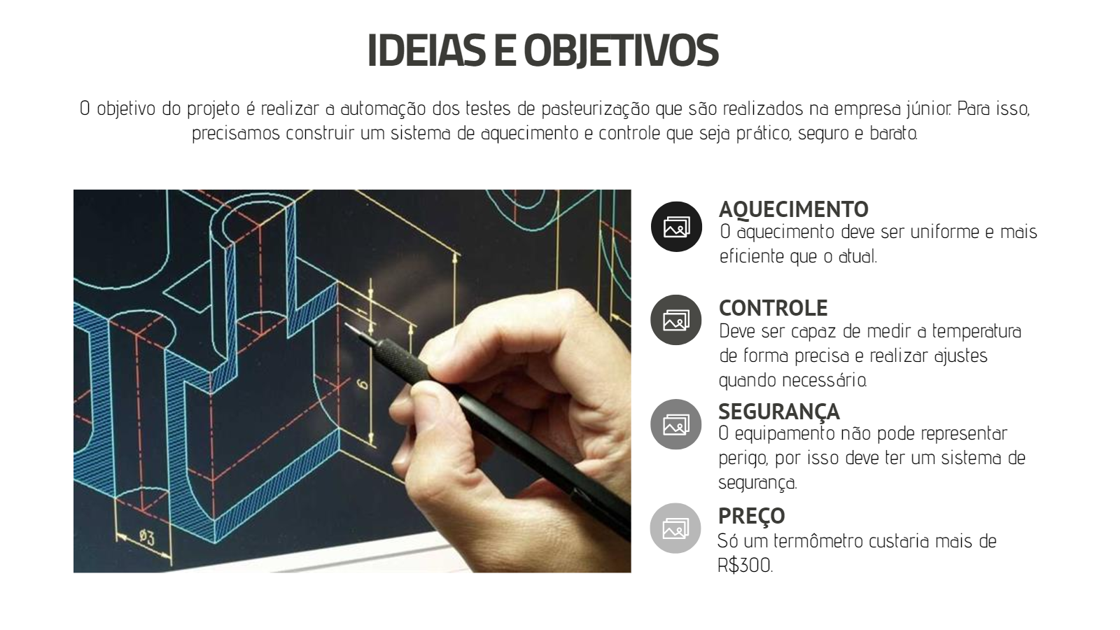
[picture p87: figure]
