GSimas/EEL7801/(threads)

Thread 1 (2017-08-22):

Implementar software para os componentes

andrempmattos, 2017-08-22:
Adicionar os códigos dos componentes e lógicas usadas no projeto, sendo que estes devem ser genéricos e modulares.

andrempmattos, 2017-08-26:
Os periféricos base já foram implementados.

Closed 2017-08-26.

Thread 7 (2017-09-17):

Desenvolvimento de Site

GSimas, 2017-09-17:
Desenvolvimento de site para apresentação do Projeto e disciplina.
Informações sobre disciplina, projeto e CONAQ. Metodologia, passos de construção do equipamento, conclusões.

**Não substitui relatório final**

Versão preliminar alfa 0.1
Verificar possibilidade de implementação de formulário de contato (asp, cgi, etc.)

GSimas, 2017-11-26:
Site finalizado com inserção de Canvas.
Passível de alterações pós-3º protótipo e manutenção contínua

Closed 2017-11-26.

Thread 8 (2017-09-26):

Documentação

GSimas, 2017-09-26:
Elaborar documentação sobre projeto, metodologia, passo a passo, ilustrações/gráficos, tabelas, fotos.
Considerações e resultados do equipamento. Jupyter Notebook, wiki do github, ou plataforma de fácil acesso.
Integrar com o site.

GSimas, 2017-11-04:
Trabalho atribuído ao Ygor. Elaboração possível no Google Docs, porém possíveis limitações e adaptações ao transpor para o site

GSimas, 2017-11-15:
**Acrescentar:**
- Detalhes sobre Pasteurização (Lenta e Rápida)
- Aprimoramento (Microcontrolador melhor)
- Descrição de código (Diagrama de Blocos/Subparte Placa ATMEGA)
- Descrição Funcionamento (adaptar do Manual do Usuário)

GSimas, 2017-11-26:
Site finalizado com inserção de Canvas.
Passível de modificações e manutenção contínua

Closed 2017-11-26.

Thread 10 (2017-11-04):

Utilizar Funções Não-Recursivas

GSimas, 2017-11-04:
Aprimorar código para o 3º protótipo, utilizando funções não-recursivas (como a MenuConfirm).
Usar alguma variável/argumento para verificar e retornar aos menus de seleção.

GSimas, 2017-11-10:
Testar código compilado para o ATMEGA, de acordo com o commit [Aprimoramento do código (#10 e #11)](https://github.com/GSimas/EEL7801/commit/1b13209eb34c783bad1690a8d941d4b29feb4d10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)

andrempmattos, 2017-11-10:
Código validado após testes.

Closed 2017-11-10.

Thread 12 (2017-11-10):

Adicionar um sistema de log no fim do processo

andrempmattos, 2017-11-10:
O log deve conter:
- Número de interrupções e tempo total de interrupções;
- Temperatura média e tempo total;
- Picos de temperatura (máximo e mínimo);
- Tempo de aquecimento e esfriamento;
- Capturar a cada 10 segundos o valor de temperatura (para gerar uma curva de aquecimento). *

Caso seja razoável de se fazer! *

Closed 2017-11-12.

Thread 14 (2017-11-12):

Arrumar sistema de log

andrempmattos, 2017-11-12:
Devido a instabilidades no sistema, o log das temperaturas ao decorrer do tempo e a temperatura média estão fora da v3.0. O problema é a limitação de processamento do microcontrolador e, assim, depois de certo tempo de funcionamento este se perde e faz um comportamento imprevisível e errado.

Por isso, deve-se pensar em outra maneira de implementar a aquisição de dados.

Thread 15 (2017-11-13):

Problema com o protótipo_v3.1

andrempmattos, 2017-11-13:
Como o ControlStart() está associado a leitura do sensor, a seleção de temperatura não pode passar dos 80 graus

andrempmattos, 2017-11-15:
Problema corrigido na v3.2

Closed 2017-11-15.

Thread 16 (2017-11-15):

Problemas com a v3.2

andrempmattos, 2017-11-15:
Adicionar interrupção pelo switch durante o aquecimento para segurança do operador

Closed 2017-11-16.

Thread 17 (2017-11-15):

Soldar fio que soltou

andrempmattos, 2017-11-15:
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

GSimas, 2017-11-16:
O fio foi bem soldado? @andrempmattos
É bom deixar ele de um modo que não tenha problemas depois

Closed 2017-11-16.
