GSimas/EEL7801/Apresentacoes/PrimeiroPrototipo-ProjetoEletronica1.pdf

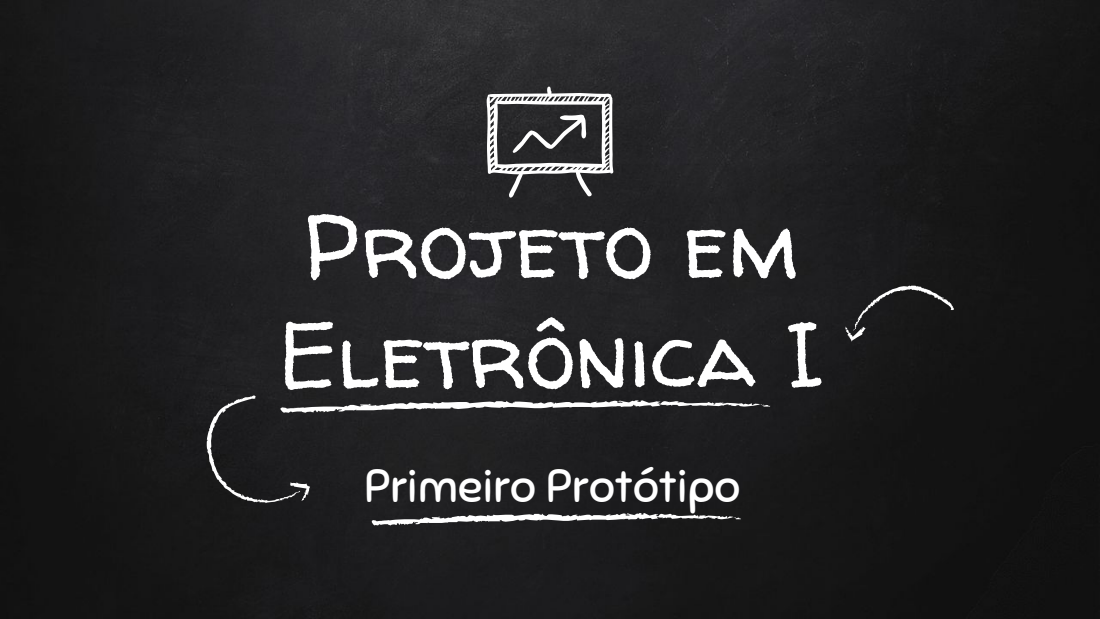
[picture p88: page 1]
Projeto em; Eletrônica I; Primeiro Protótipo

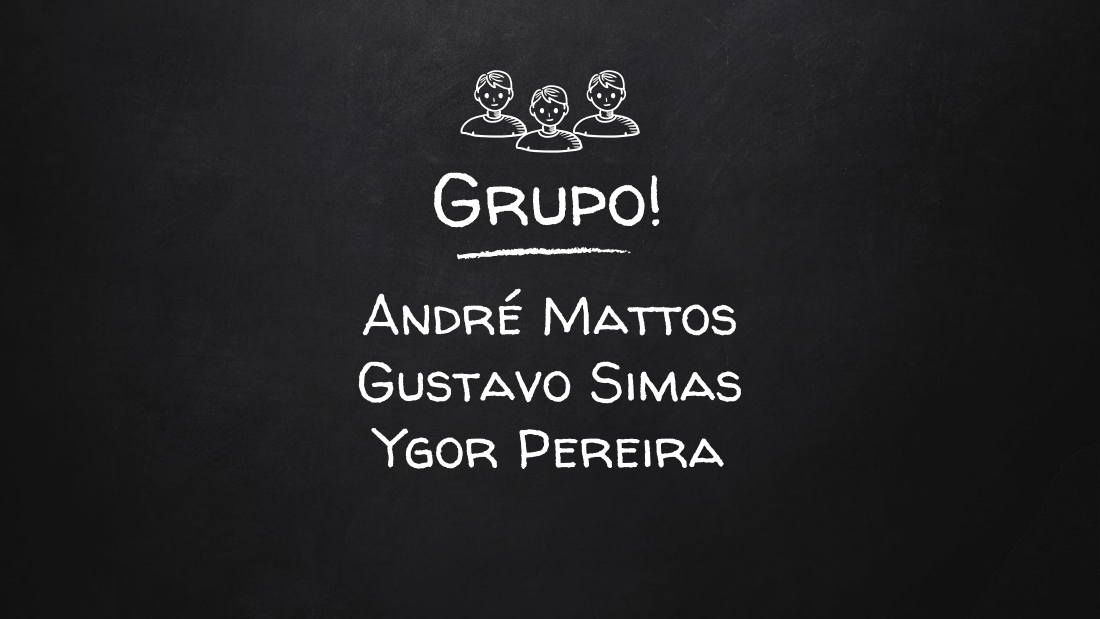
[picture p89: page 2]
Grupo!; André Mattos; Gustavo Simas; Ygor Pereira

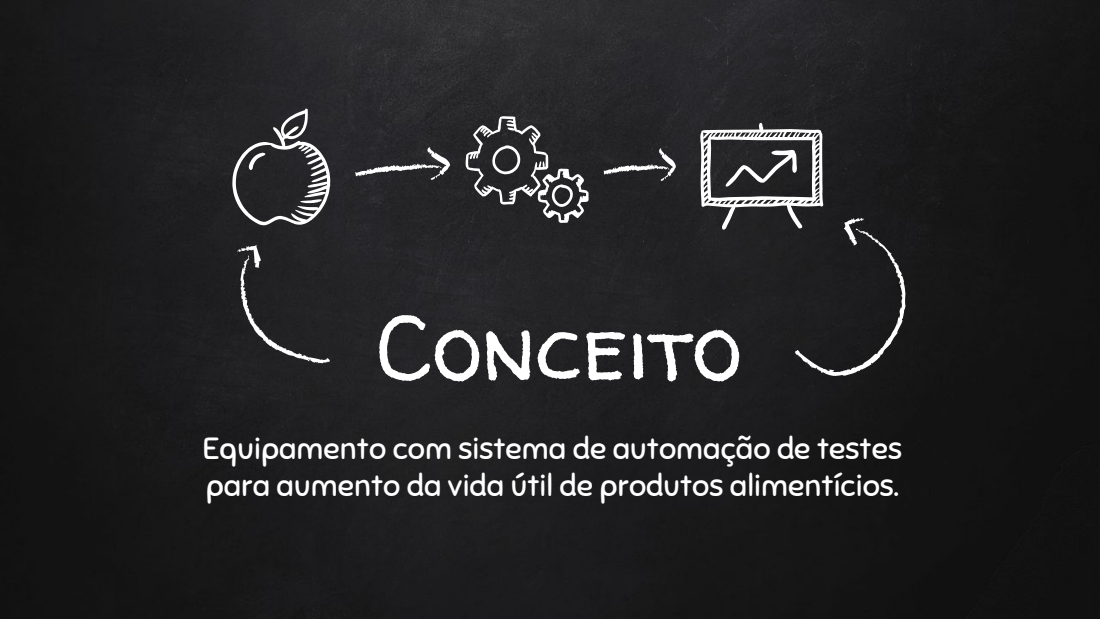
[picture p90: page 3]
Conceito

Equipamento com sistema de automação de testes
para aumento da vida útil de produtos alimentícios.

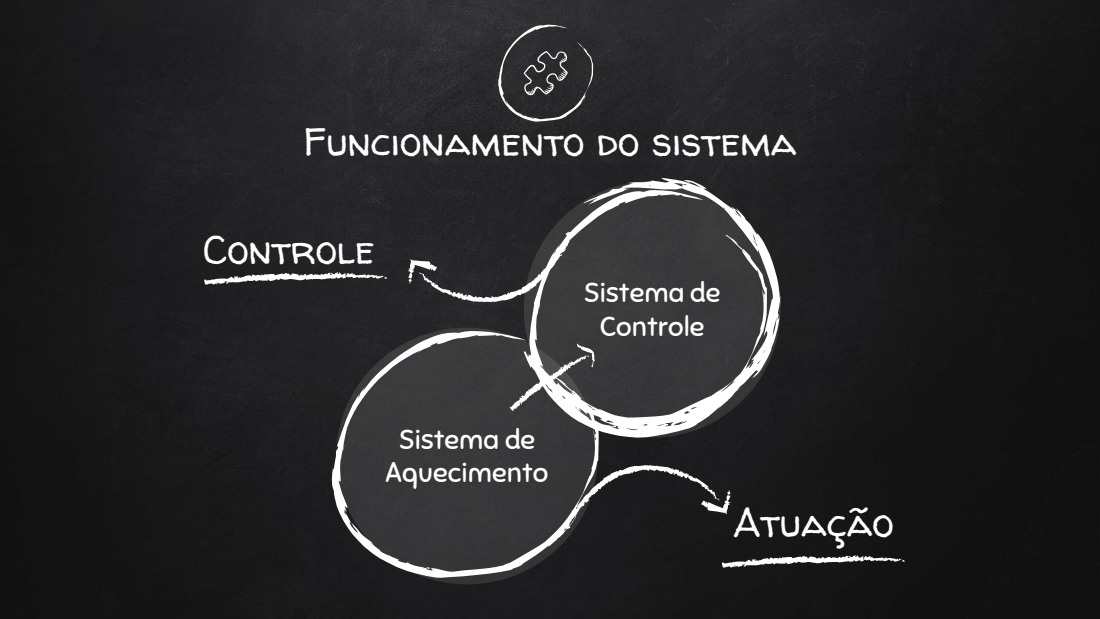
[picture p91: page 4]
Sistema de Controle; Sistema de Aquecimento; Controle; Atuação

Funcionamento do sistema

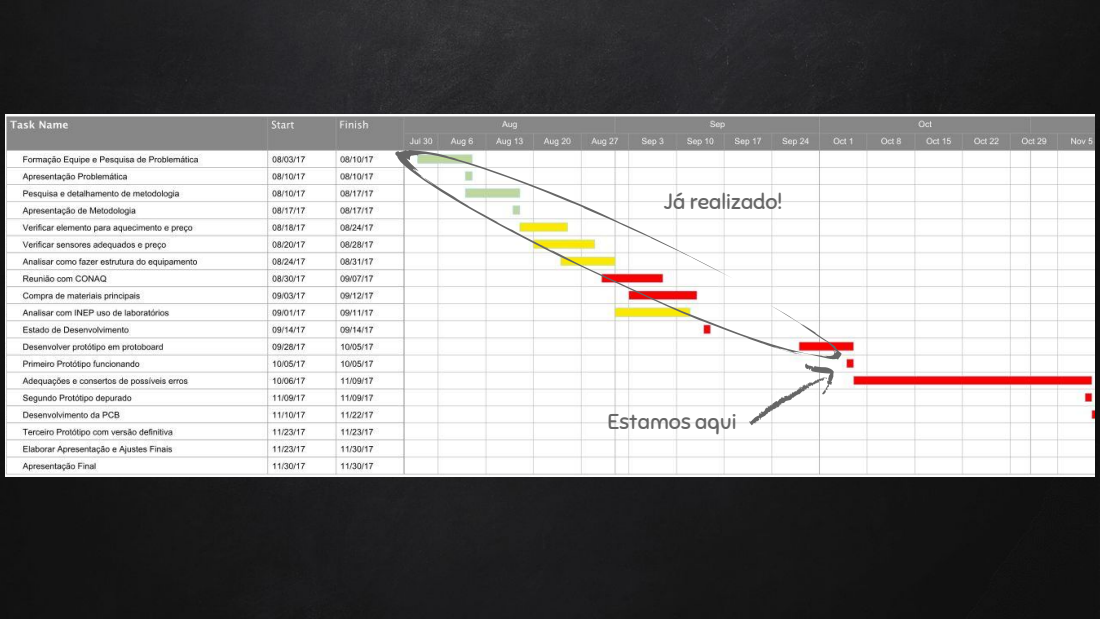
[picture p92: page 5]
Estamos aqui; Já realizado!

1.

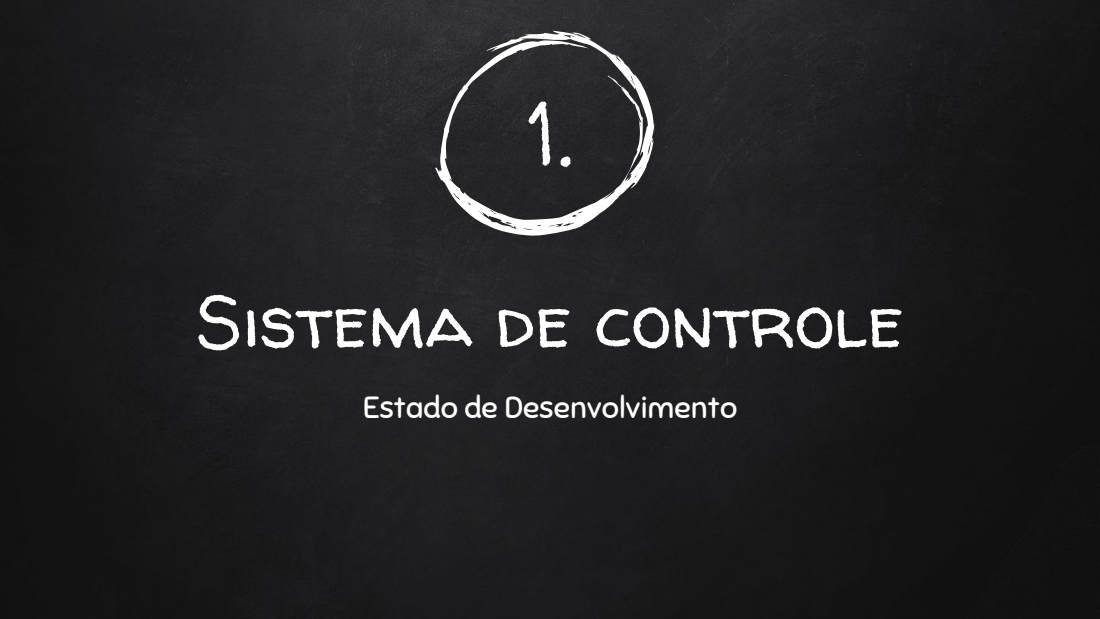
[picture p93: page 6]

Sistema de controle

Estado de Desenvolvimento

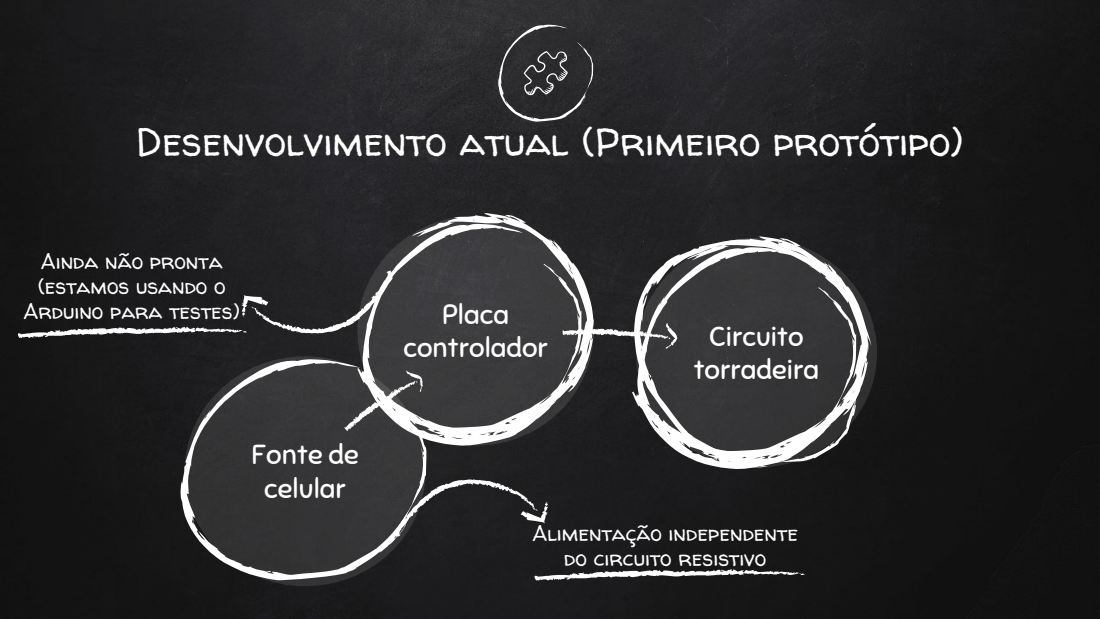
[picture p94: page 7]
Placa controlador; Fonte de celular; (estamos usando o; Alimentação independente; Circuito torradeira

Desenvolvimento atual (Primeiro protótipo)

Ainda não pronta

Arduino para testes)

do circuito resistivo

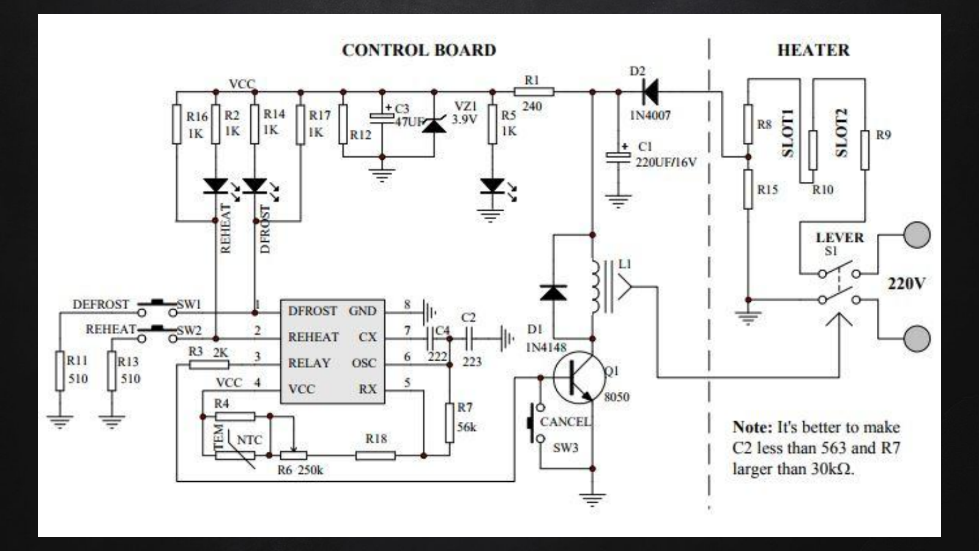
[picture p95: page 8]
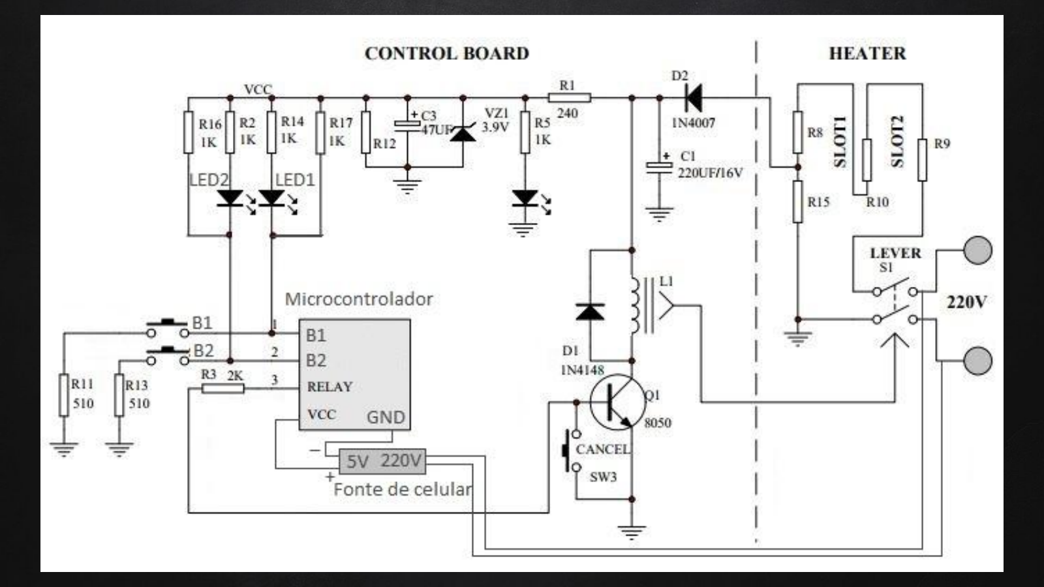
[picture p96: page 9]
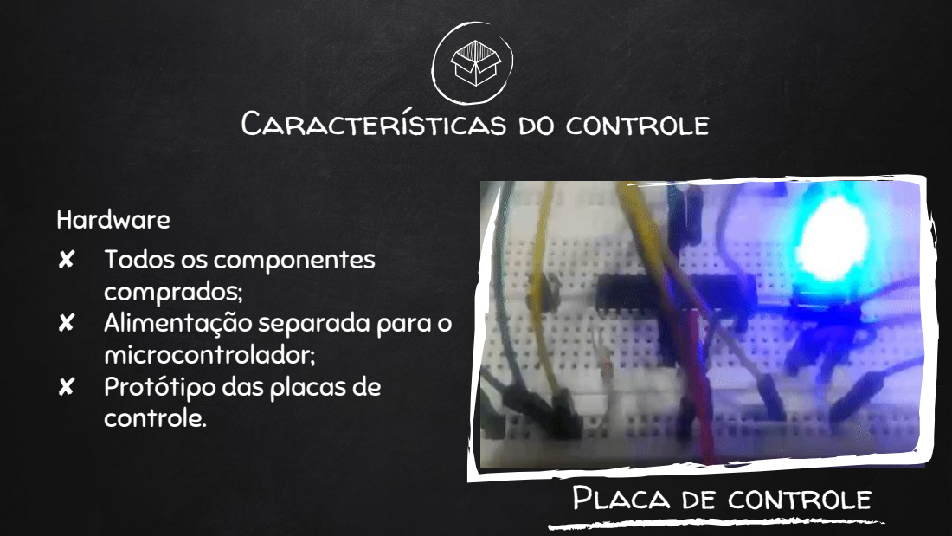
[picture p97: page 10]

Características do controle

Hardware
✘ Todos os componentes
comprados;
✘ Alimentação separada para o
microcontrolador;
✘ Protótipo das placas de
controle.

Placa de controle

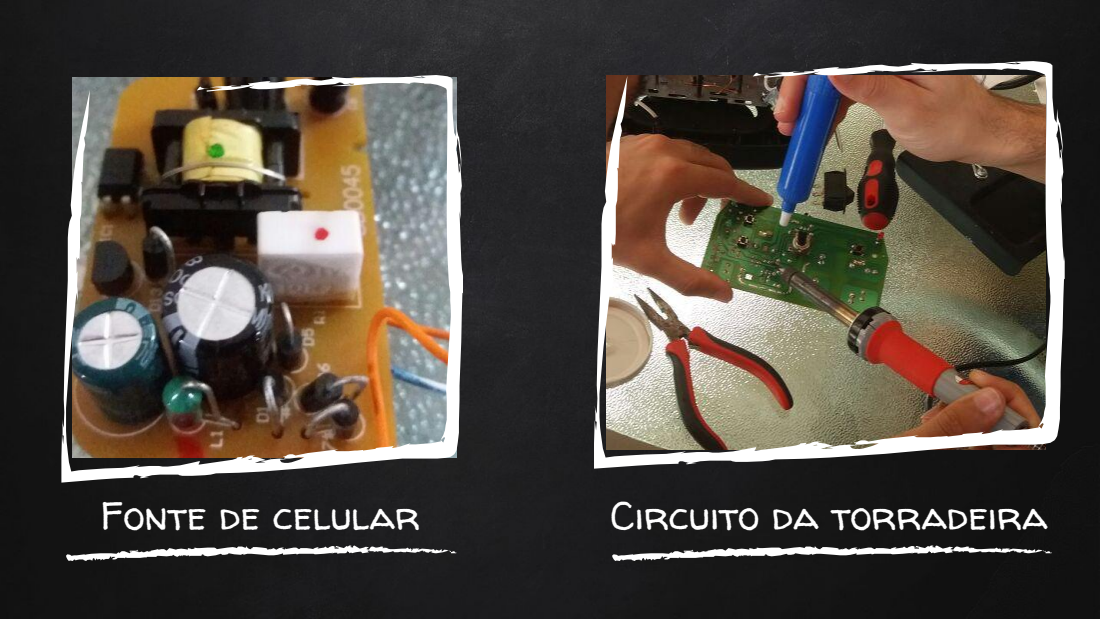
[picture p98: page 11]
Fonte de celular; Circuito da torradeira

2.

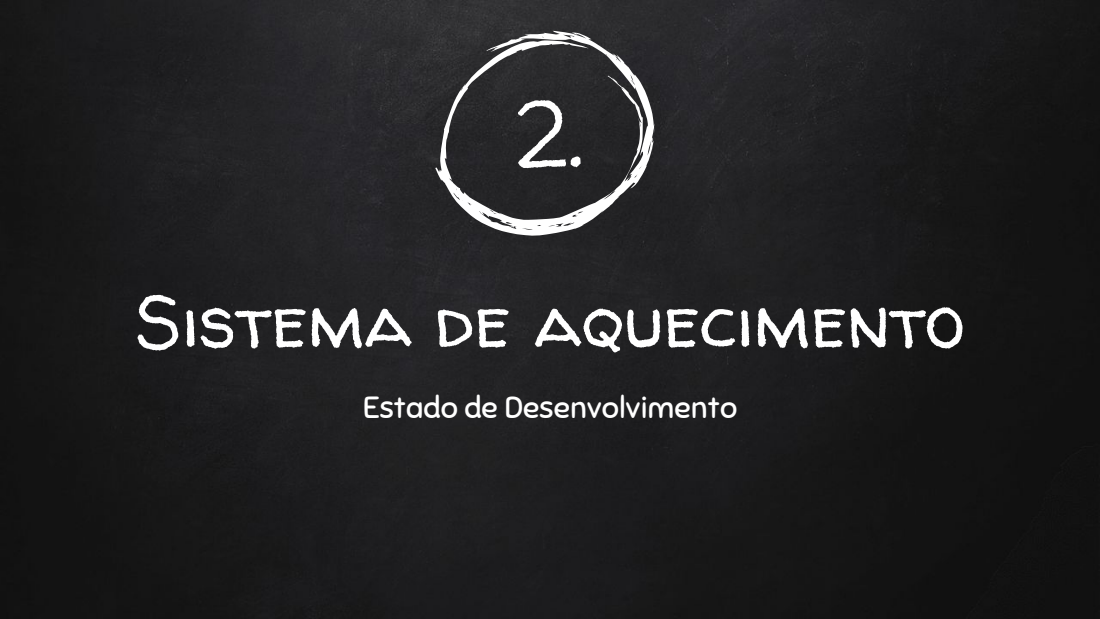
[picture p99: page 12]

Sistema de aquecimento

Estado de Desenvolvimento

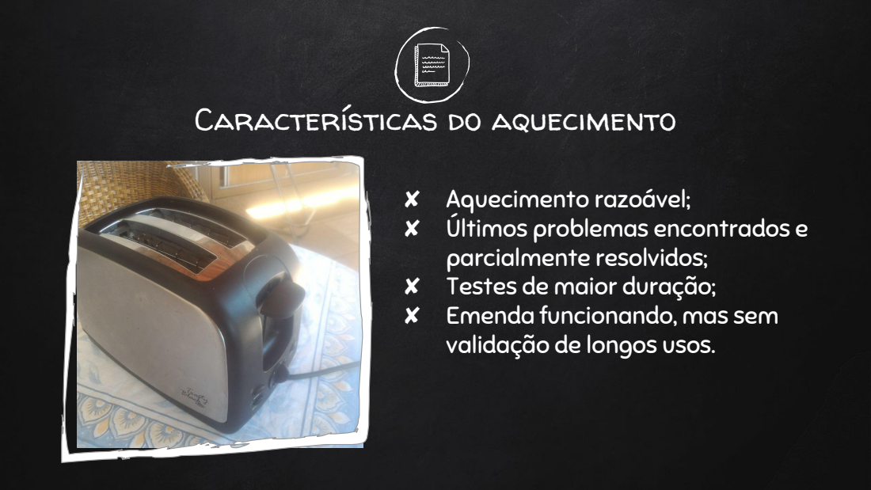
[picture p100: page 13]

Características do aquecimento

✘ Aquecimento razoável;
✘ Últimos problemas encontrados e
parcialmente resolvidos;
✘ Testes de maior duração;
✘ Emenda funcionando, mas sem
validação de longos usos.

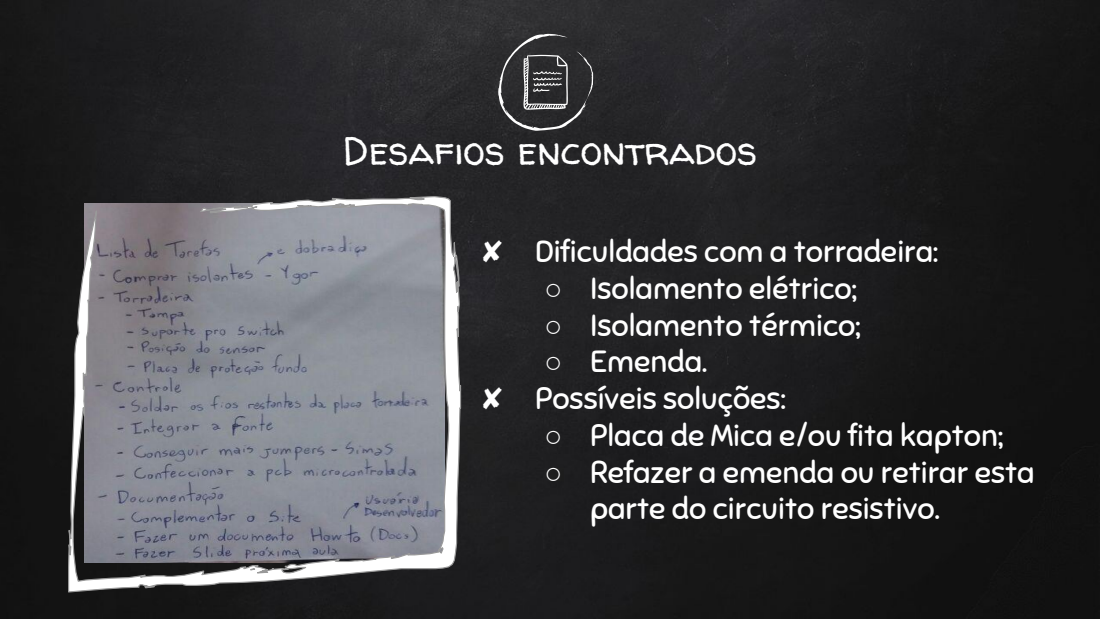
[picture p101: page 14]
Desafios encontrados

✘ Dificuldades com a torradeira:
○ Isolamento elétrico;
○ Isolamento térmico;
○ Emenda.
✘ Possíveis soluções:
○ Placa de Mica e/ou fita kapton;
○ Refazer a emenda ou retirar esta
parte do circuito resistivo.

r$ ~40

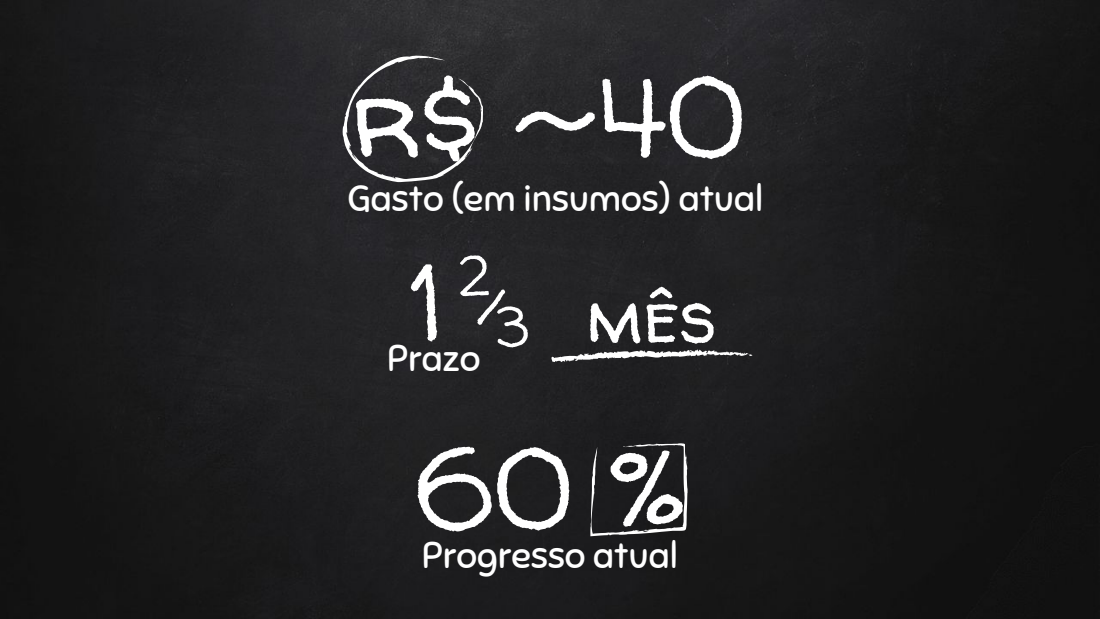
[picture p102: page 15]
Gasto (em insumos) atual; Progresso atual; mês; Prazo

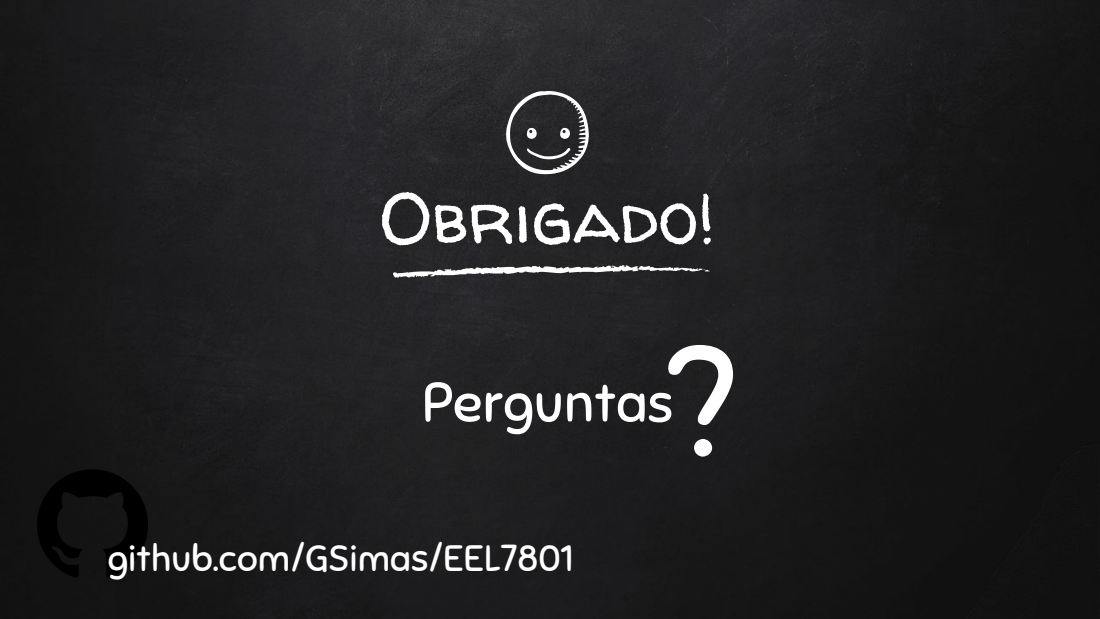
[picture p103: page 16]
Obrigado!; Perguntas?

github.com/GSimas/EEL7801
