GSimas/EEL7801/Apresentacoes/EstadoDesenvolvimento-ProjetoEletrônica1.pdf

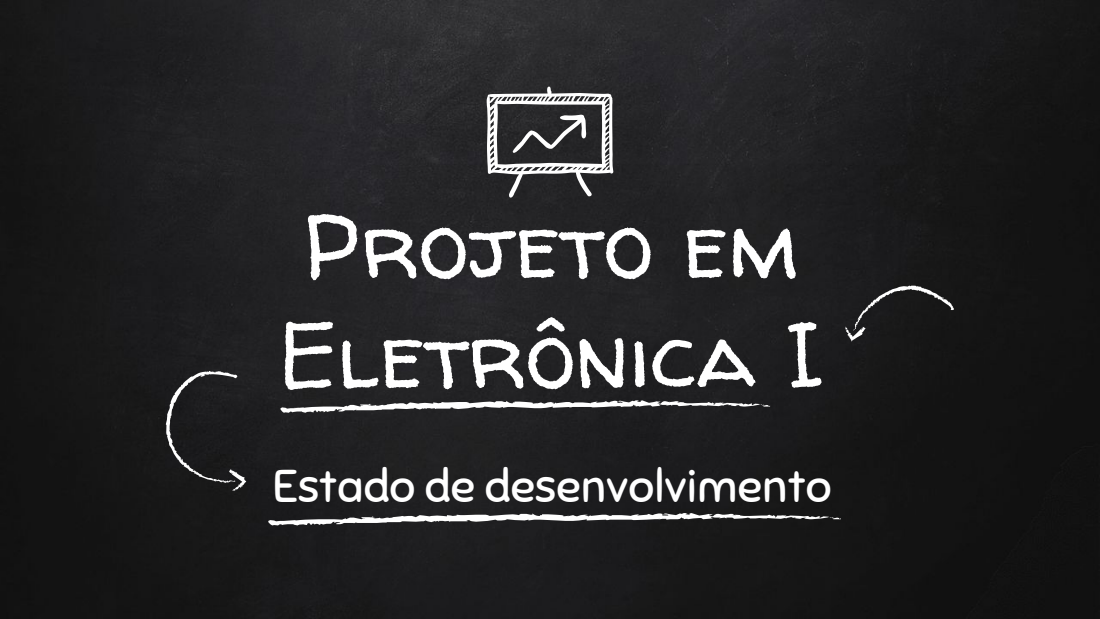
[picture p104: page 1]
Projeto em; Eletrônica I

Estado de desenvolvimento

Grupo!; André Mattos; Gustavo Simas; Ygor Pereira

Conceito

Equipamento com sistema de automação de testes
para aumento da vida útil de produtos alimentícios.

Sistema de Controle; Sistema de Aquecimento; Controle; Atuação

Funcionamento do sistema

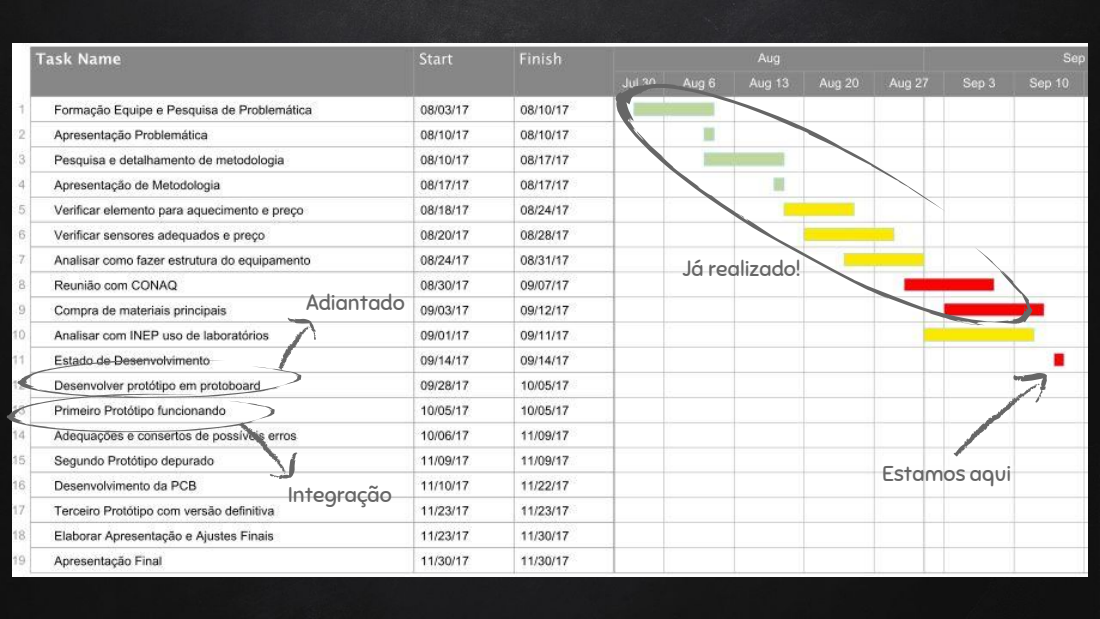
[picture p105: page 5]
Estamos aqui; Já realizado!; Integração; Adiantado

1.


Sistema de controle

Estado de Desenvolvimento

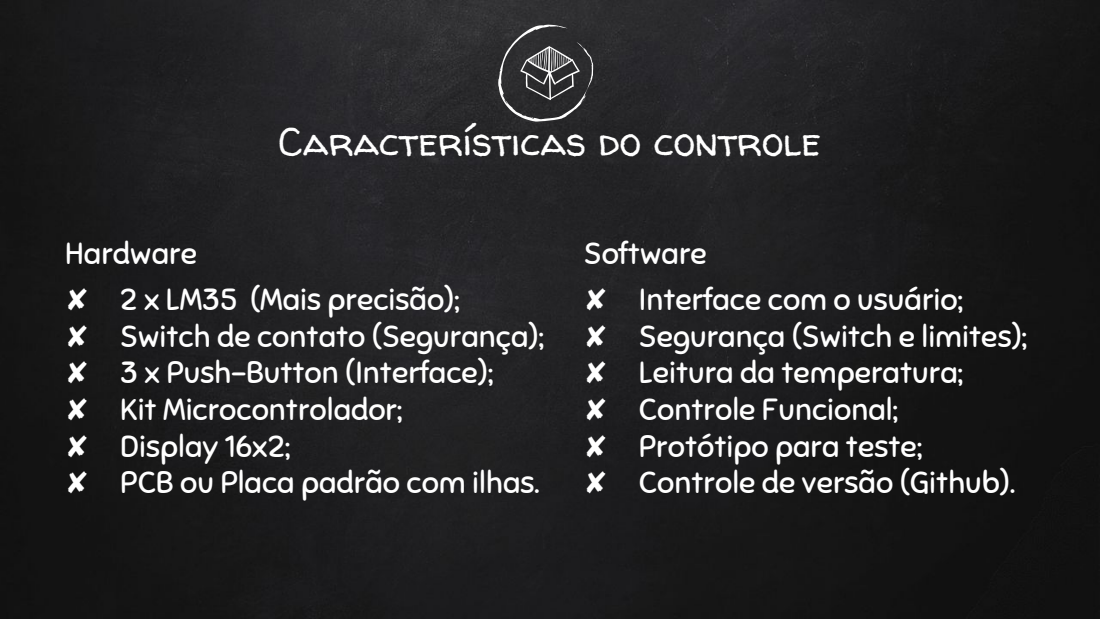
[picture p106: page 7]

Características do controle

Hardware
✘ 2 x LM35 (Mais precisão);
✘ Switch de contato (Segurança);
✘ 3 x Push-Button (Interface);
✘ Kit Microcontrolador;
✘ Display 16x2;
✘ PCB ou Placa padrão com ilhas.

Software
✘ Interface com o usuário;
✘ Segurança (Switch e limites);
✘ Leitura da temperatura;
✘ Controle Funcional;
✘ Protótipo para teste;
✘ Controle de versão (Github).

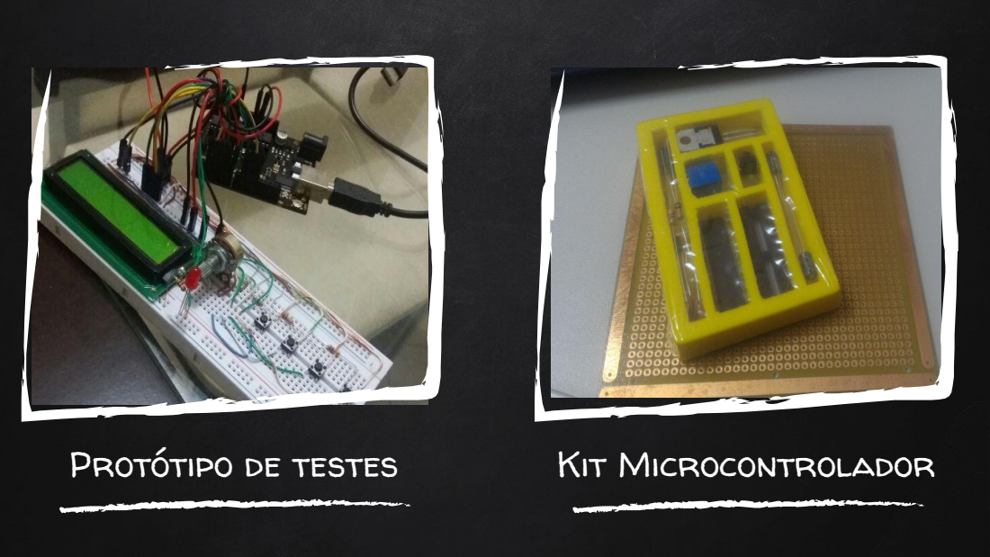
[picture p107: page 8]
Protótipo de testes; Kit Microcontrolador

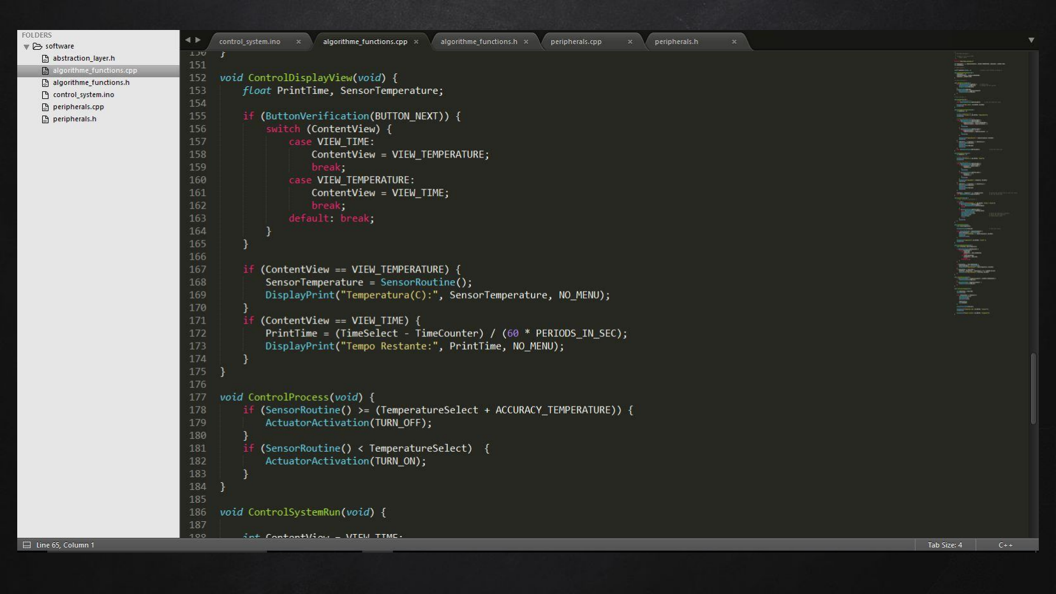
[picture p108: page 9]

2.


Sistema de aquecimento

Estado de Desenvolvimento

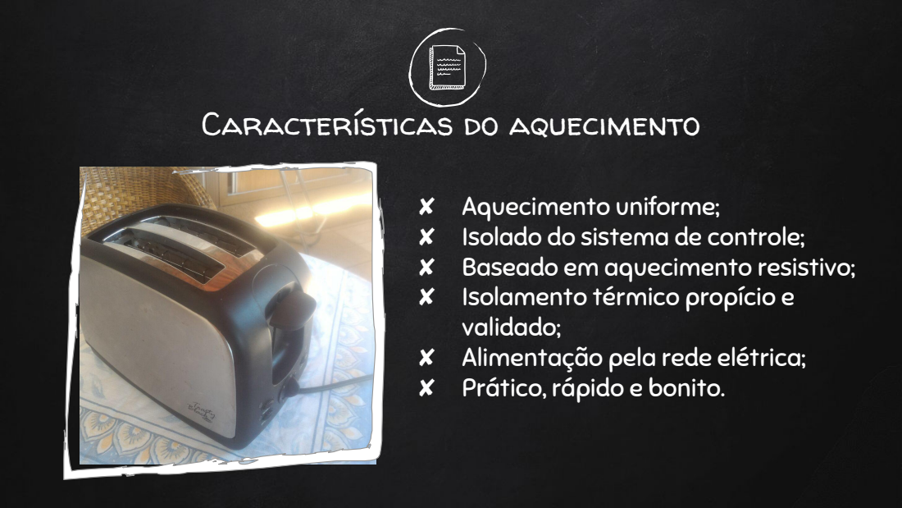
[picture p109: page 11]

Características do aquecimento

✘ Aquecimento uniforme;
✘ Isolado do sistema de controle;
✘ Baseado em aquecimento resistivo;
✘ Isolamento térmico propício e
validado;
✘ Alimentação pela rede elétrica;
✘ Prático, rápido e bonito.

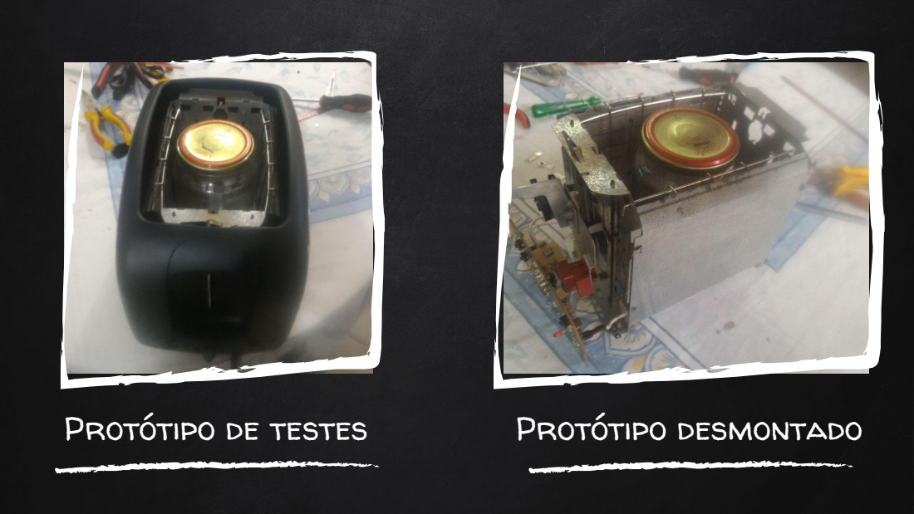
[picture p110: page 12]
Protótipo de testes; Protótipo desmontado

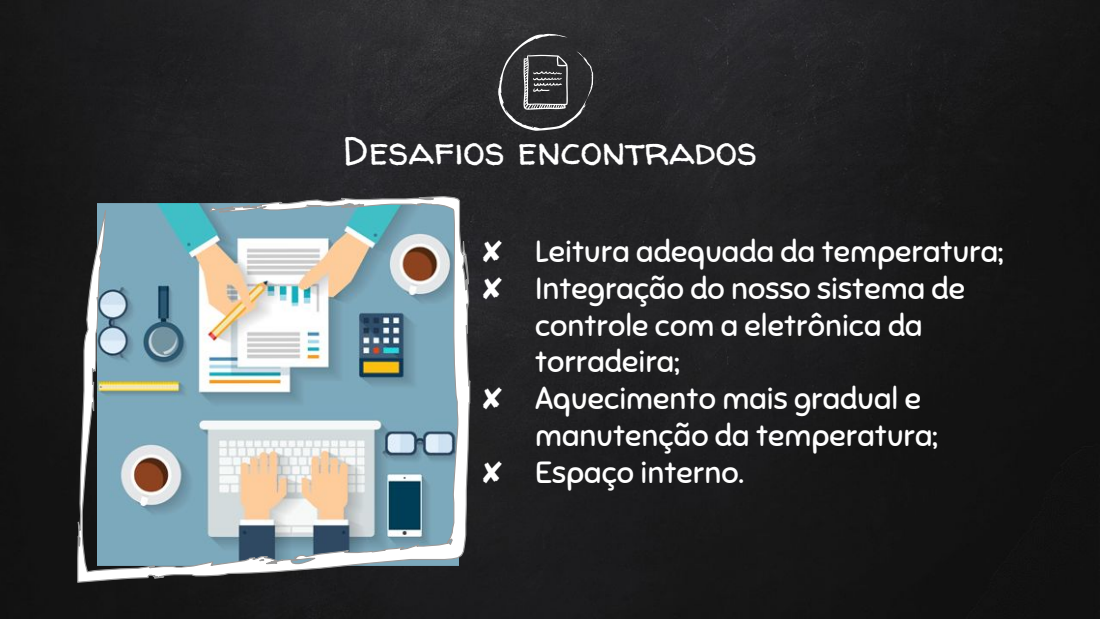
[picture p111: page 13]
Desafios encontrados

✘ Leitura adequada da temperatura;
✘ Integração do nosso sistema de
controle com a eletrônica da
torradeira;
✘ Aquecimento mais gradual e
manutenção da temperatura;
✘ Espaço interno.

r$ ~40

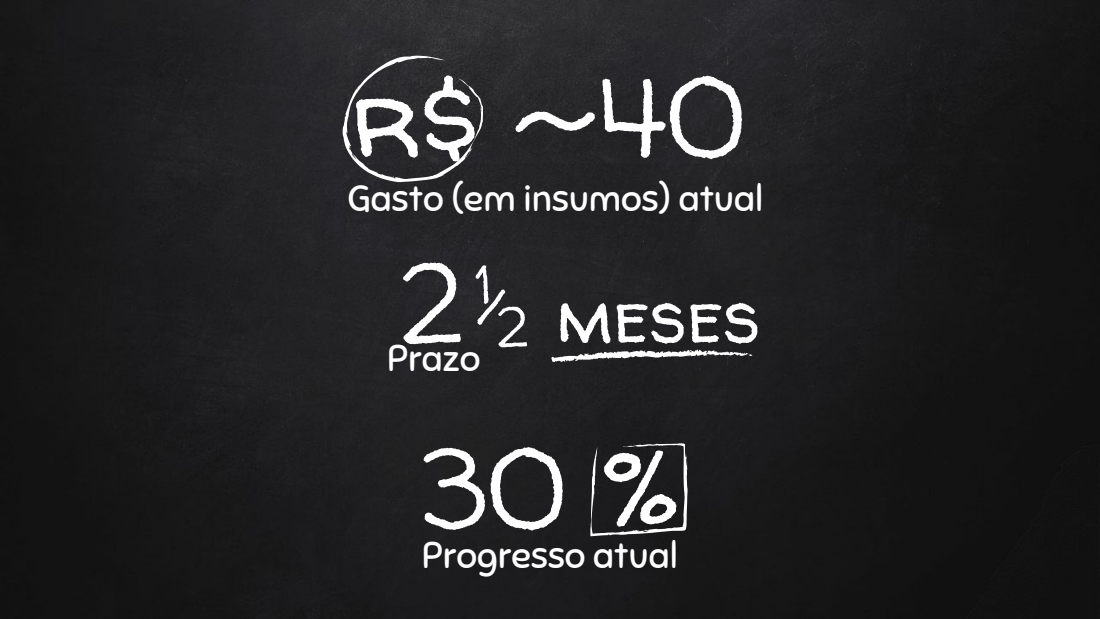
[picture p112: page 14]
Progresso atual; meses; Prazo

Gasto (em insumos) atual

Obrigado!; Perguntas?

github.com/GSimas/EEL7801
