GSimas/EEL7801/Apresentacoes/Metodologia-ProjetoEletronica1.pdf

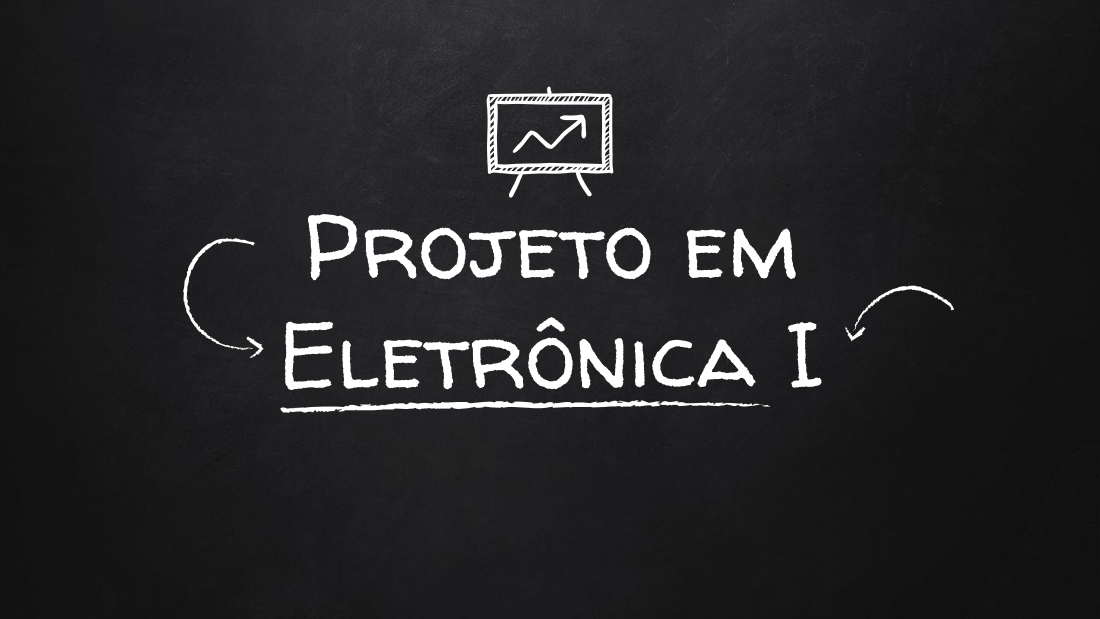
[picture p113: page 1]
Projeto em; Eletrônica I

Grupo!; André Mattos; Gustavo Simas; Ygor Pereira

Conceito

Equipamento com sistema de automação de testes
para aumento da vida útil de produtos alimentícios.

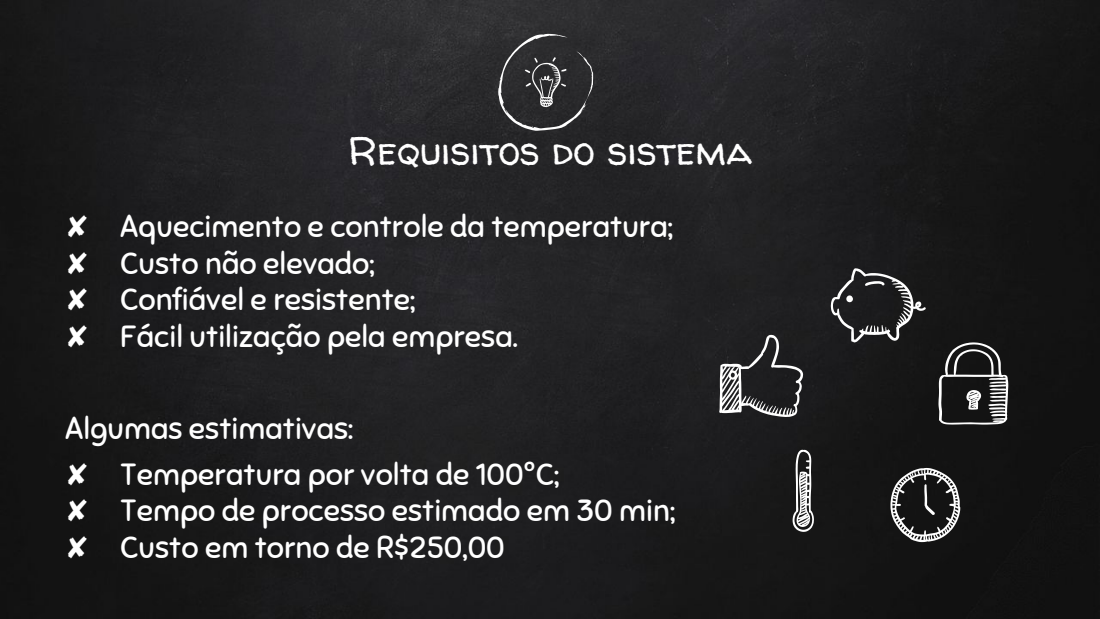
[picture p114: page 4]

Requisitos do sistema

✘ Aquecimento e controle da temperatura;
✘ Custo não elevado;
✘ Confiável e resistente;
✘ Fácil utilização pela empresa.

Algumas estimativas:
✘ Temperatura por volta de 100ºC;
✘ Tempo de processo estimado em 30 min;
✘ Custo em torno de R$250,00

Sistema de Controle; Sistema de Aquecimento; Controle; Atuação

Funcionamento do sistema

1.

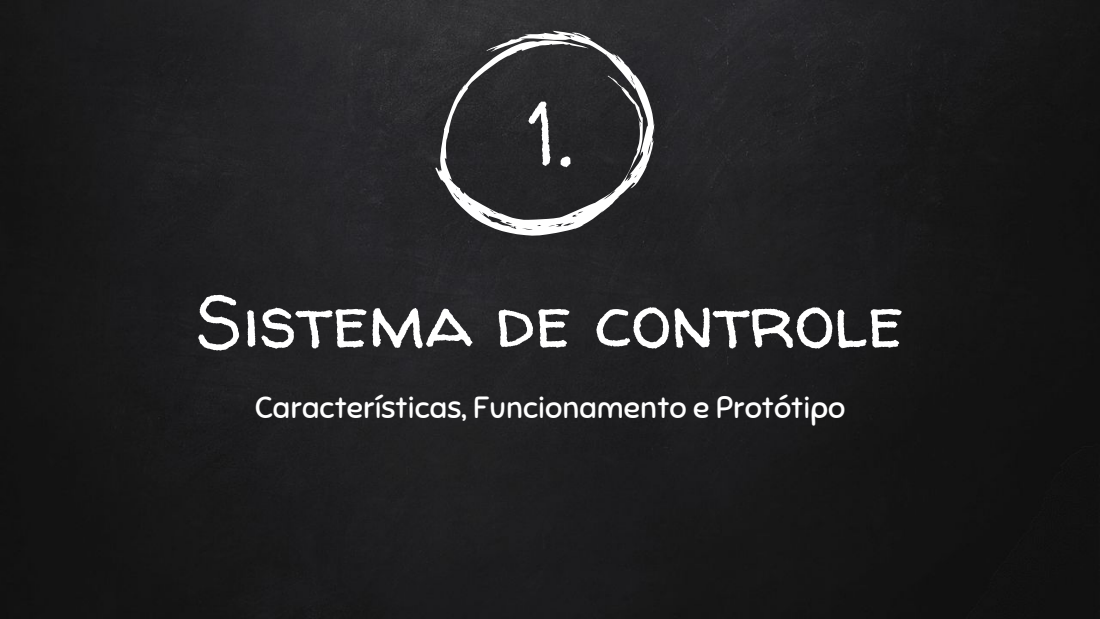
[picture p115: page 6]

Sistema de controle

Características, Funcionamento e Protótipo

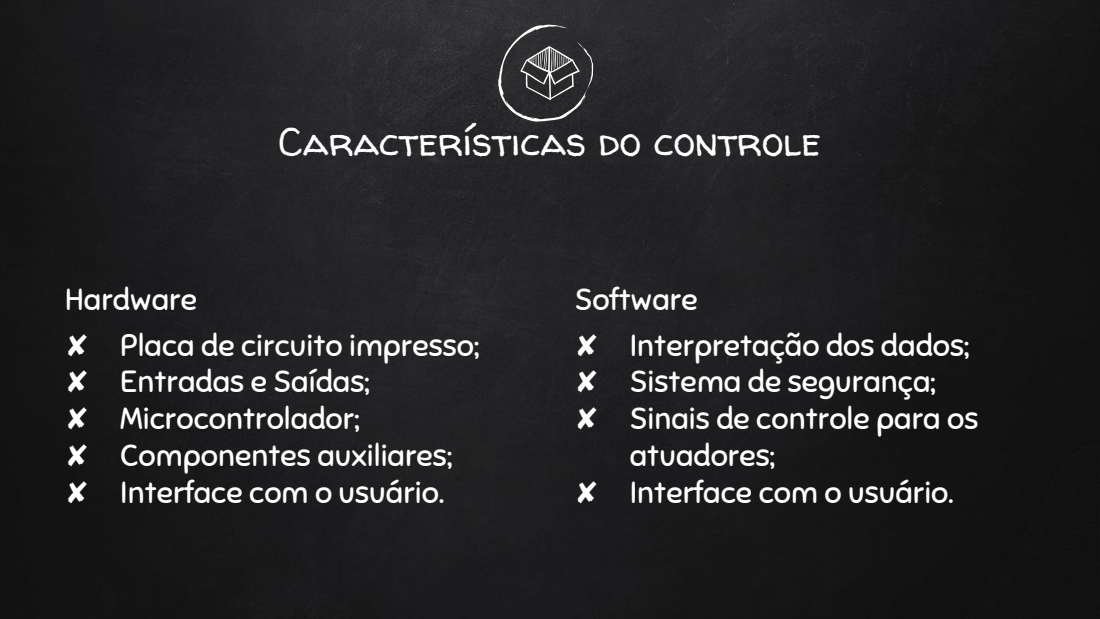
[picture p116: page 7]

Características do controle

Hardware
✘ Placa de circuito impresso;
✘ Entradas e Saídas;
✘ Microcontrolador;
✘ Componentes auxiliares;
✘ Interface com o usuário.

Software
✘ Interpretação dos dados;
✘ Sistema de segurança;
✘ Sinais de controle para os
atuadores;

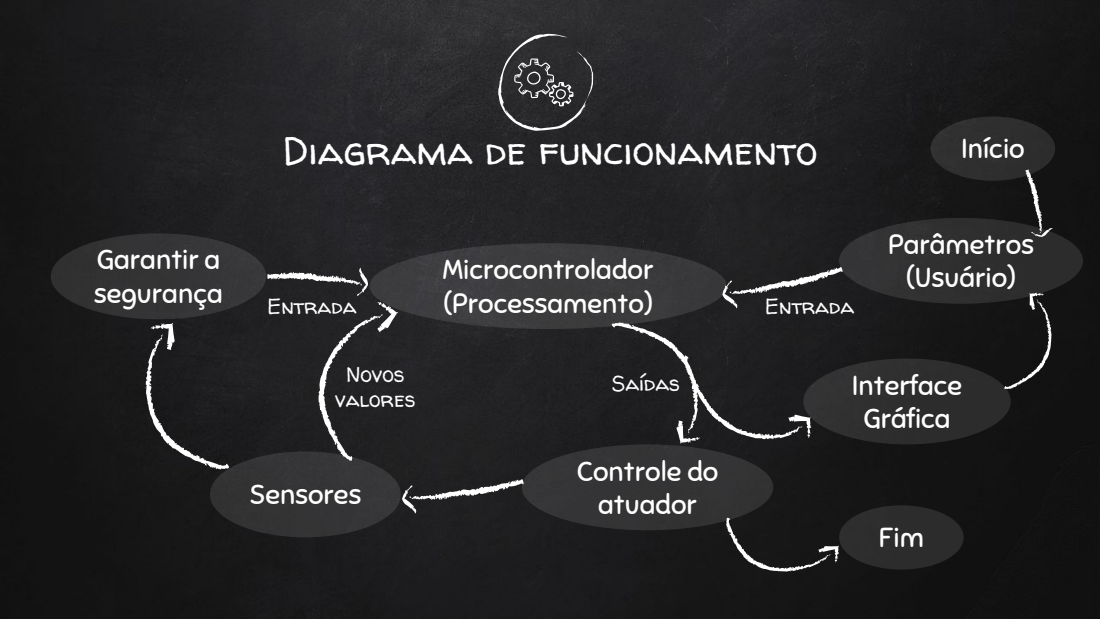
[picture p117: page 8]
Sensores; Microcontrolador (Processamento); Parâmetros (Usuário); Controle do atuador; Interface Gráfica; Garantir a; segurança; Entrada; Saídas Novos; valores; Início; Fim

Diagrama de funcionamento

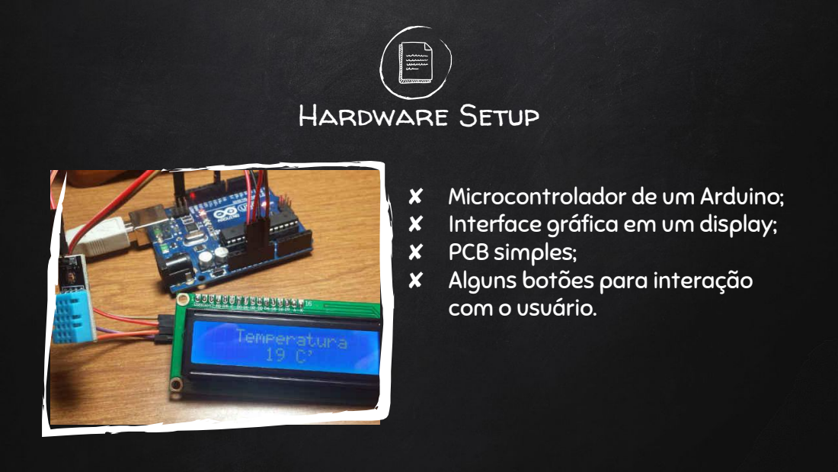
[picture p118: page 9]
Hardware Setup

✘ Microcontrolador de um Arduino;
✘ Interface gráfica em um display;
✘ PCB simples;
✘ Alguns botões para interação
com o usuário.

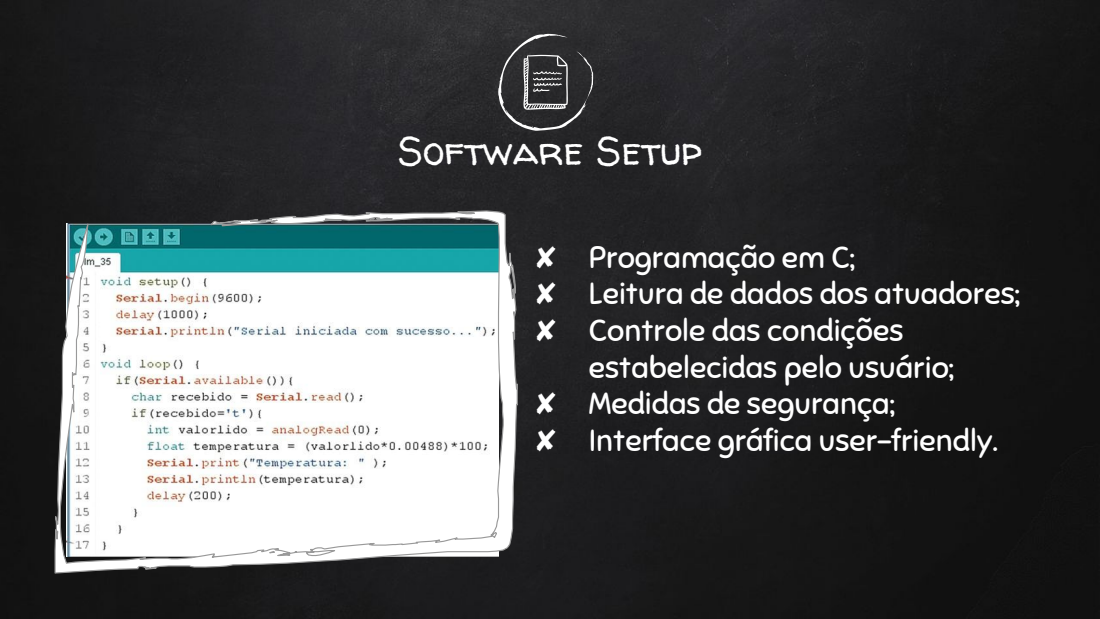
[picture p119: page 10]
Software Setup

✘ Programação em C;
✘ Leitura de dados dos atuadores;
✘ Controle das condições
estabelecidas pelo usuário;
✘ Medidas de segurança;
✘ Interface gráfica user-friendly.

2.

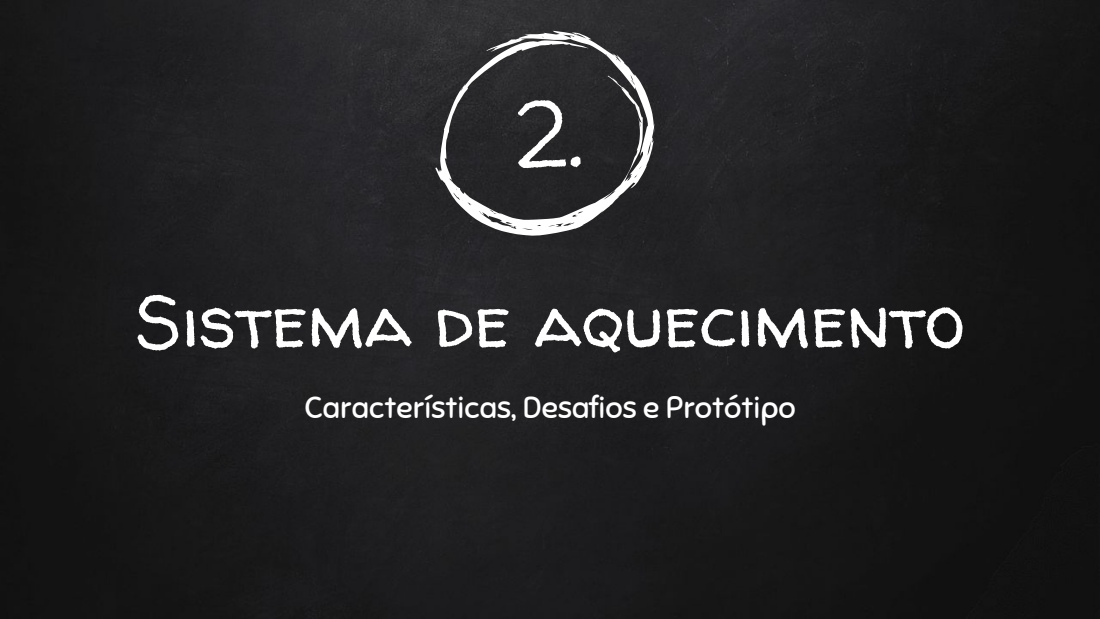
[picture p120: page 11]

Sistema de aquecimento

Características, Desafios e Protótipo

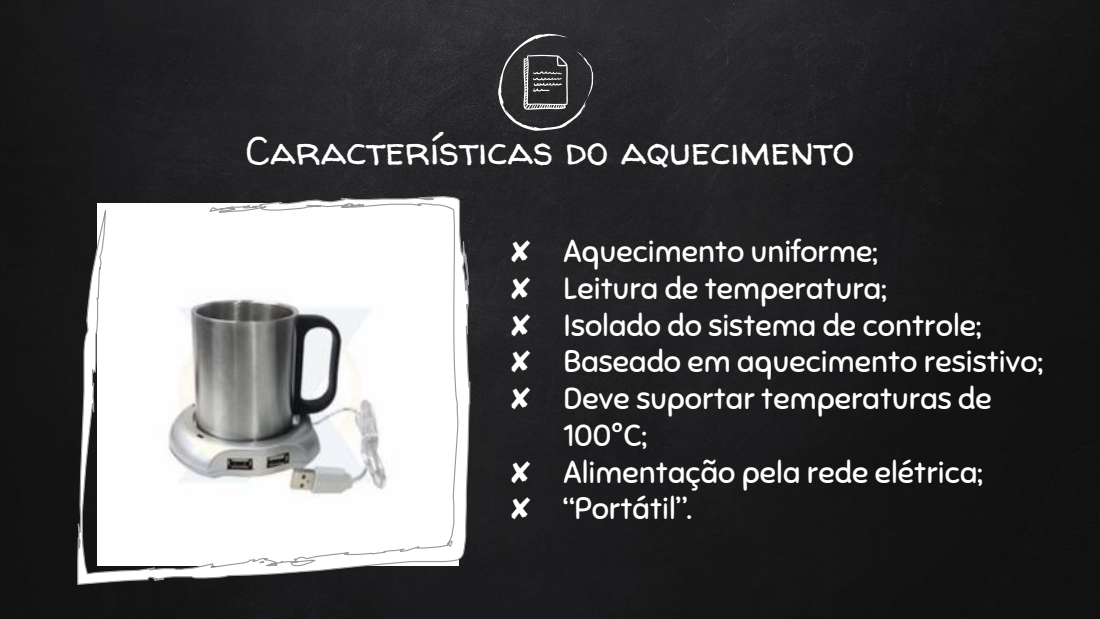
[picture p121: page 12]

Características do aquecimento

✘ Aquecimento uniforme;
✘ Leitura de temperatura;
✘ Isolado do sistema de controle;
✘ Baseado em aquecimento resistivo;
✘ Deve suportar temperaturas de
✘ Alimentação pela rede elétrica;
✘ “Portátil”.

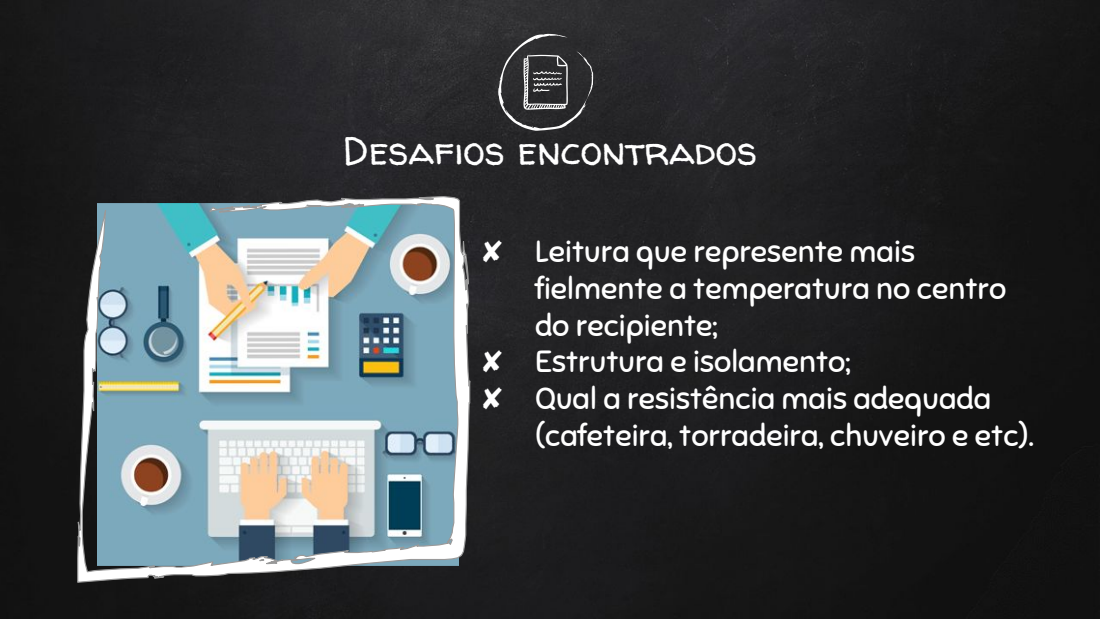
[picture p122: page 13]
Desafios encontrados

✘ Leitura que represente mais
fielmente a temperatura no centro
do recipiente;
✘ Estrutura e isolamento;
✘ Qual a resistência mais adequada
(cafeteira, torradeira, chuveiro e etc).

<250 $

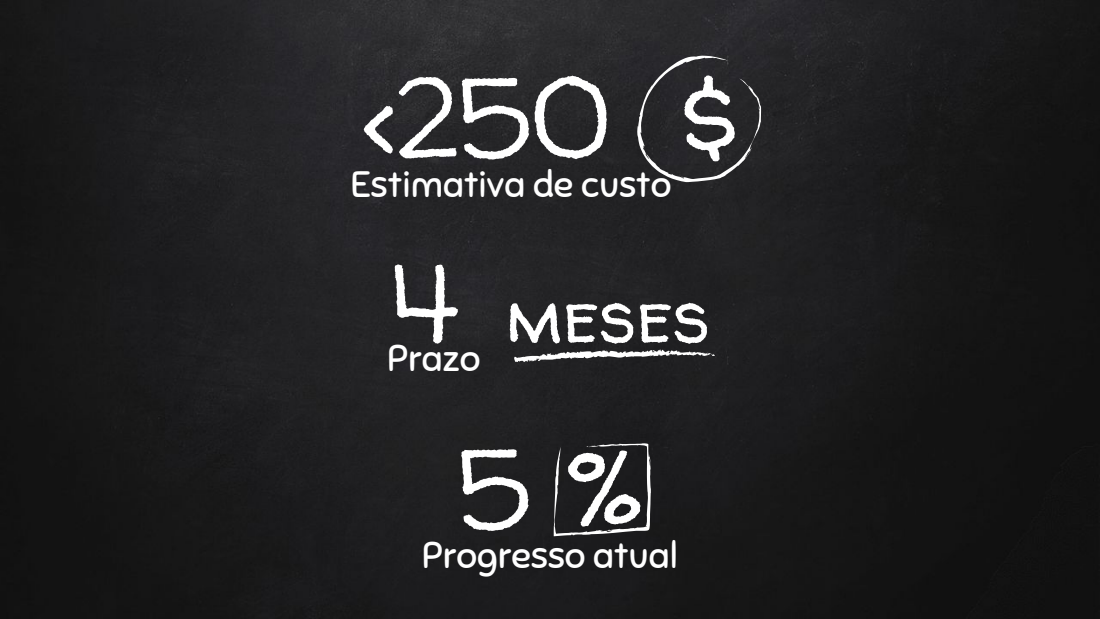
[picture p123: page 14]
Progresso atual; 4 meses; Prazo

Estimativa de custo

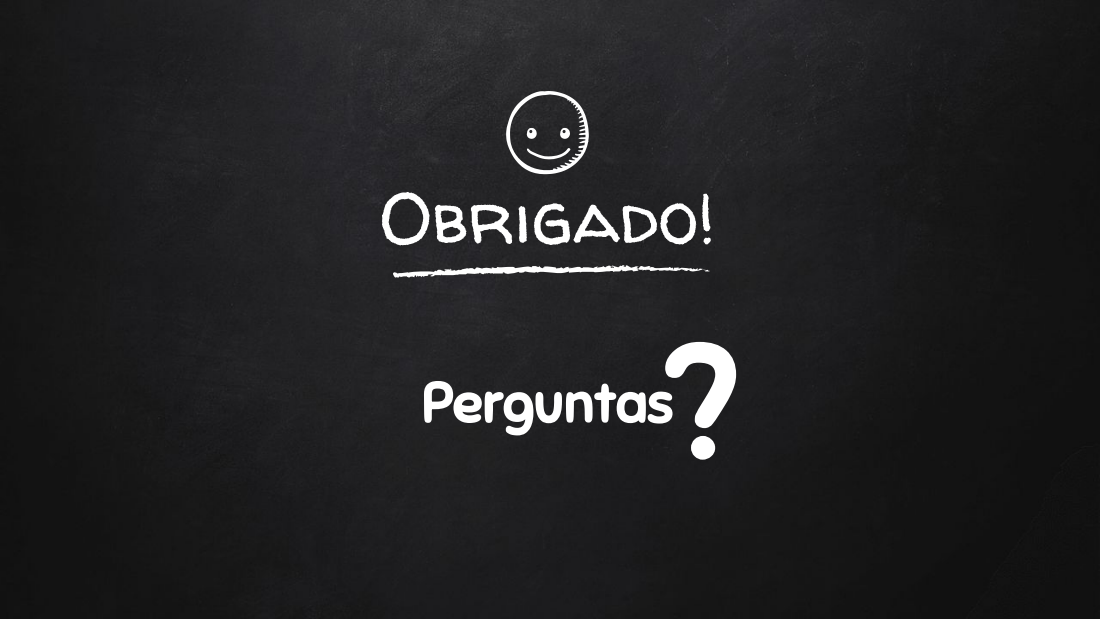
[picture p124: page 15]
Obrigado!; Perguntas?

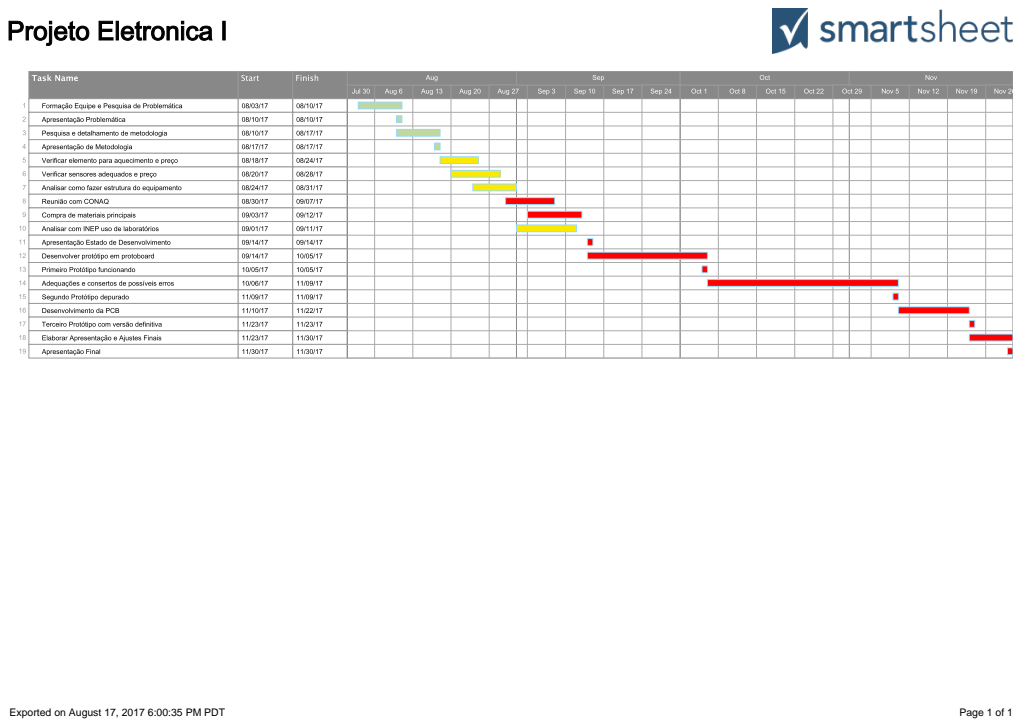
[picture p125: page 16]
Projeto Eletronica I; Exported on August 17, 2017 6:00:35 PM PDT; Page 1 of
