GSimas/EEL7801/apresentacoes/graficos/Curva de aquecimento I - P.A.L.O.M.A.pdf

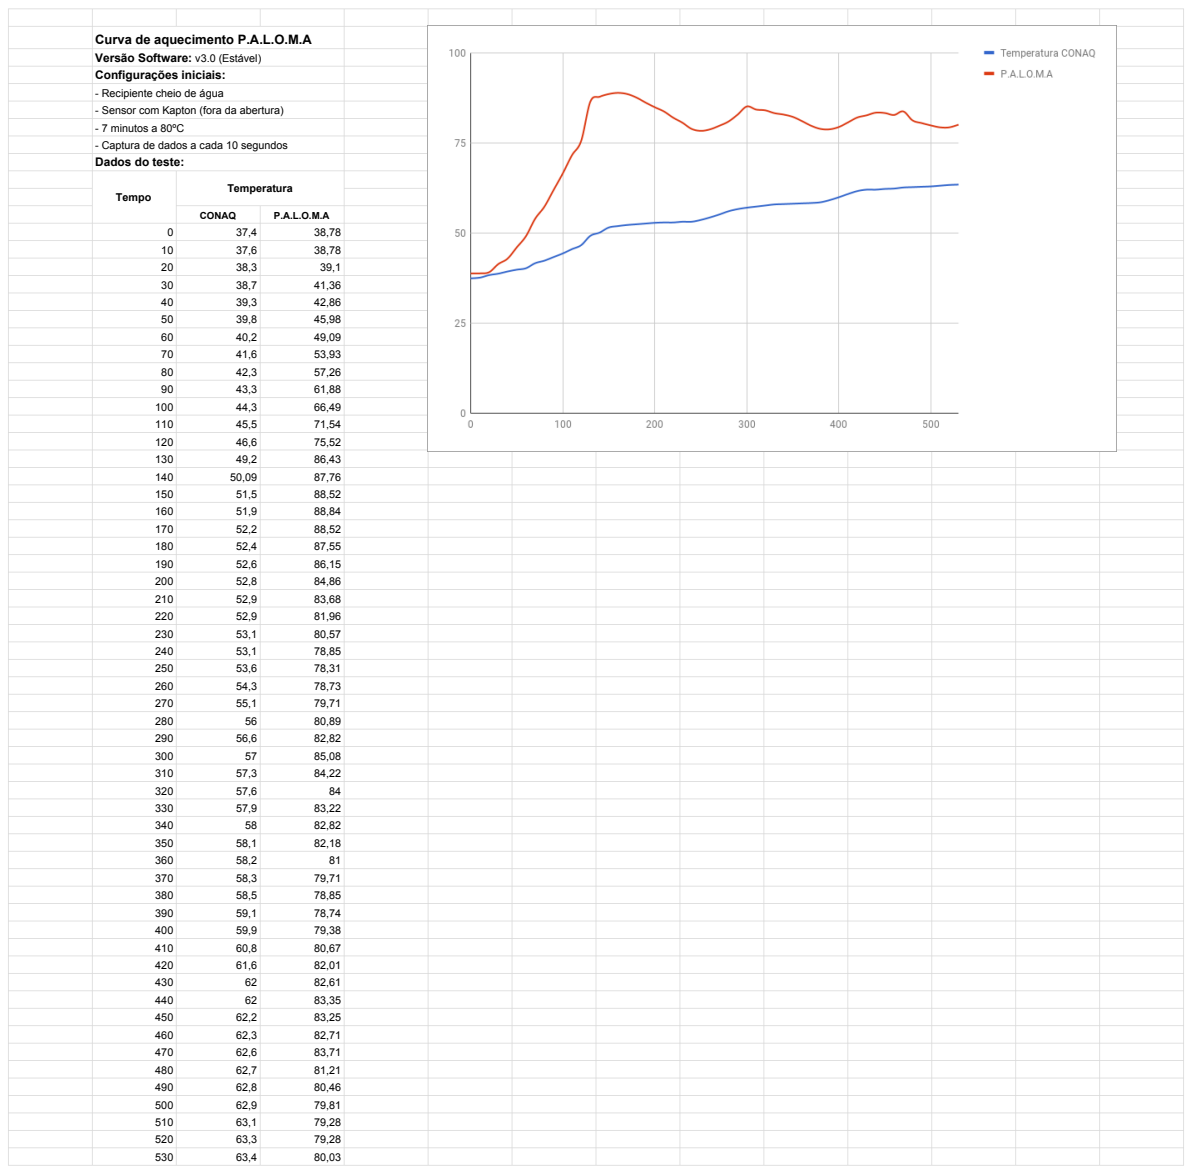
[picture p126: page 1]
Tempo; Temperatura; CONAQ

Curva de aquecimento P.A.L.O.M.A
Versão Software: v3.0 (Estável) Configurações iniciais:

- Recipiente cheio de água
- Sensor com Kapton (fora da abertura)
- 7 minutos a 80ºC
- Captura de dados a cada 10 segundos Dados do teste:
