GSimas/EEL7801/apresentacoes/graficos/Curva de aquecimento II - P.A.L.O.M.A.pdf

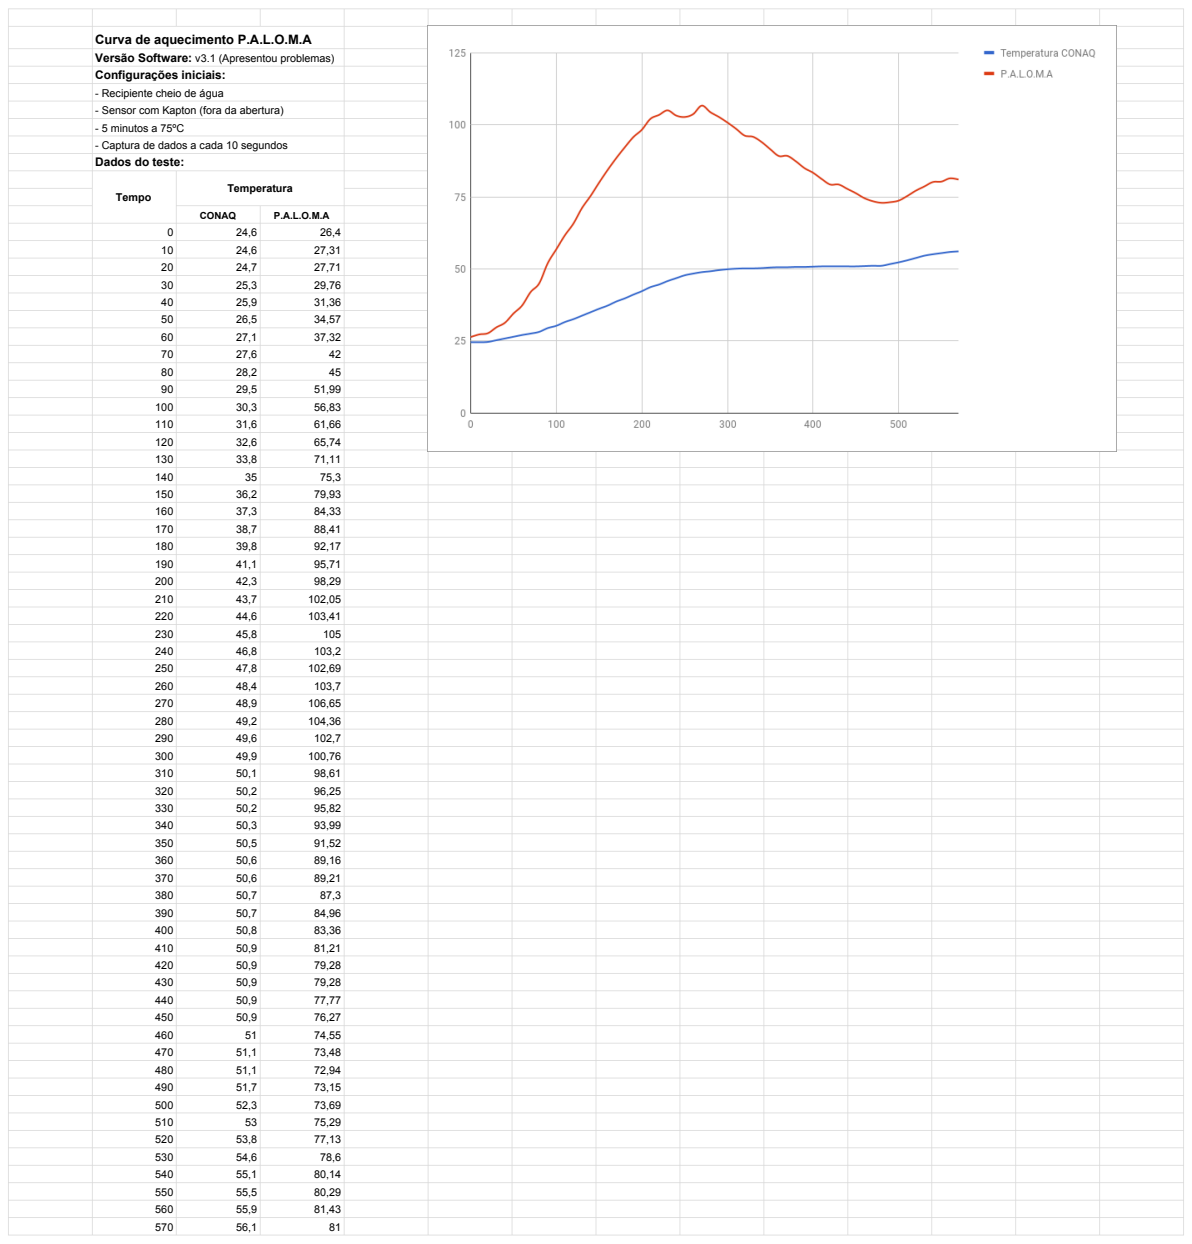
[picture p127: page 1]
Tempo; Temperatura; CONAQ

Curva de aquecimento P.A.L.O.M.A
Versão Software: v3.1 (Apresentou problemas) Configurações iniciais:

- Recipiente cheio de água
- Sensor com Kapton (fora da abertura)
- 5 minutos a 75ºC
- Captura de dados a cada 10 segundos Dados do teste:
