GSimas/EEL7801/apresentacoes/graficos/Curva de aquecimento III - P.A.L.O.M.A.pdf

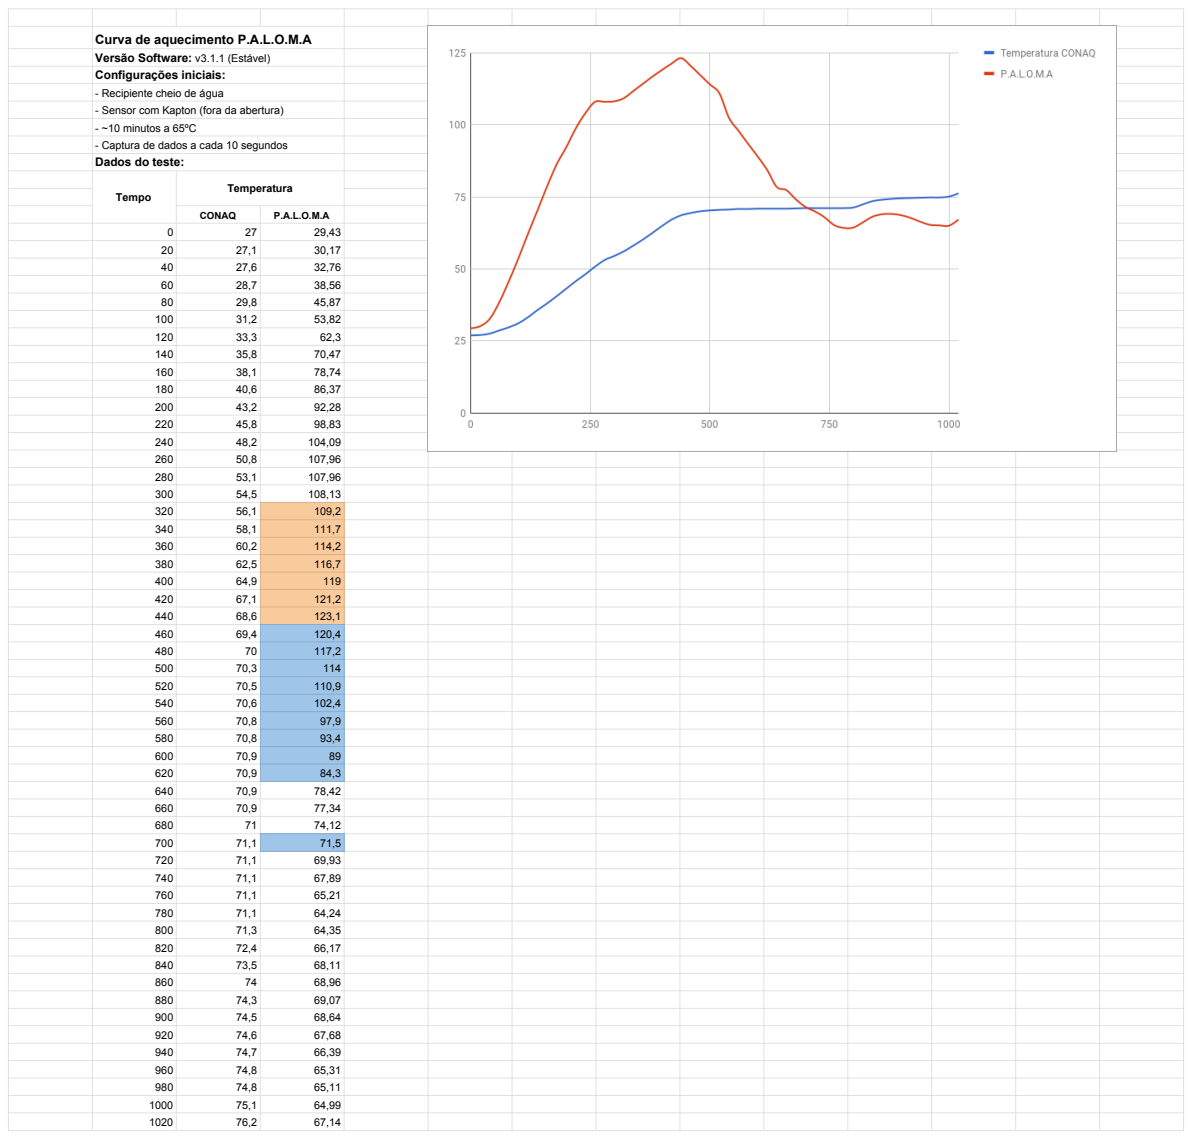
[picture p128: page 1]
Tempo; Temperatura; CONAQ

Curva de aquecimento P.A.L.O.M.A
Versão Software: v3.1.1 (Estável) Configurações iniciais:

- Recipiente cheio de água
- Sensor com Kapton (fora da abertura)
- ~10 minutos a 65ºC
- Captura de dados a cada 10 segundos Dados do teste:
