GSimas/EEL7801/apresentacoes/graficos/Curva de aquecimento V - P.A.L.O.M.A.pdf

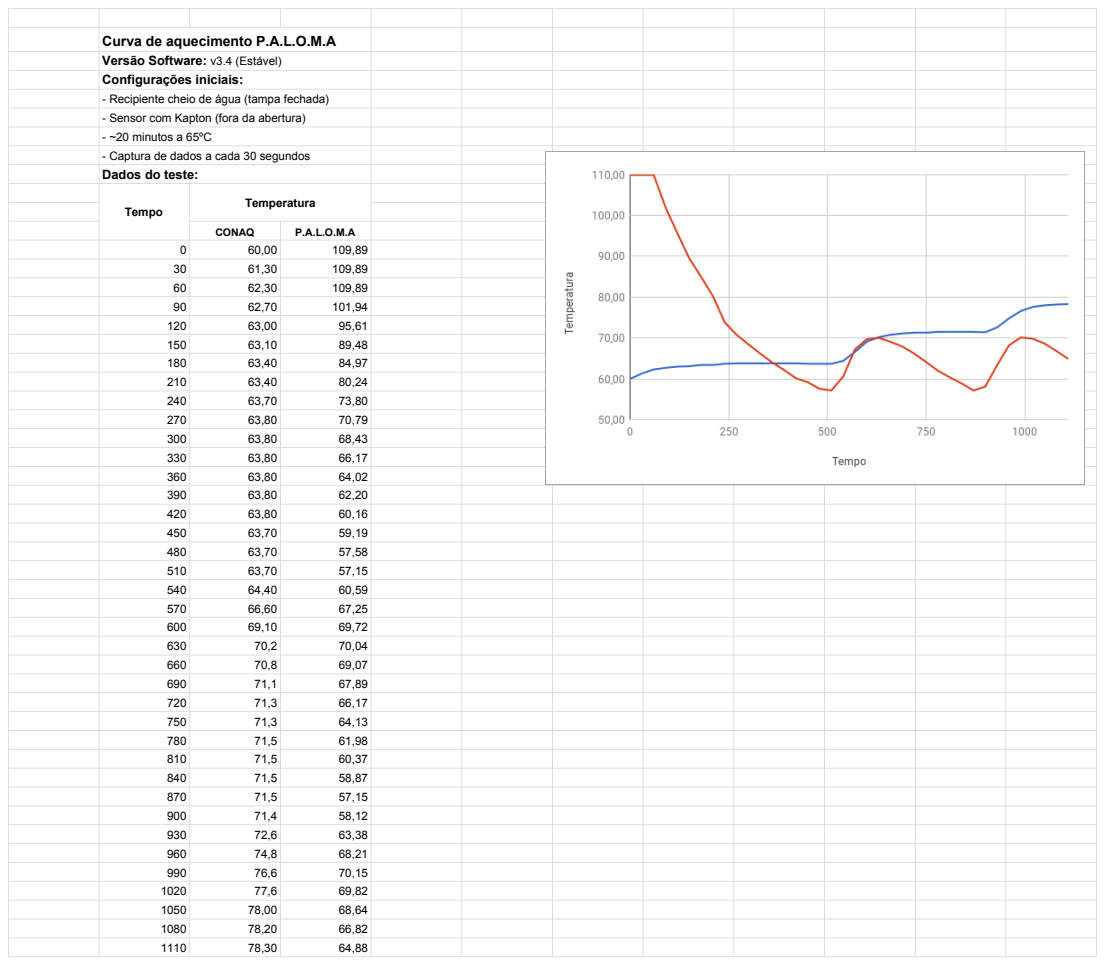
[picture p129: page 1]
Tempo; Temperatura; CONAQ

Curva de aquecimento P.A.L.O.M.A
Versão Software: v3.4 (Estável)
Configurações iniciais:
- Recipiente cheio de água (tampa fechada)
- Sensor com Kapton (fora da abertura)
- ~20 minutos a 65ºC
- Captura de dados a cada 30 segundos
Dados do teste:
