GSimas/EEL7801/apresentacoes/graficos/Curva de aquecimento VIII - P.A.L.O.M.A.pdf

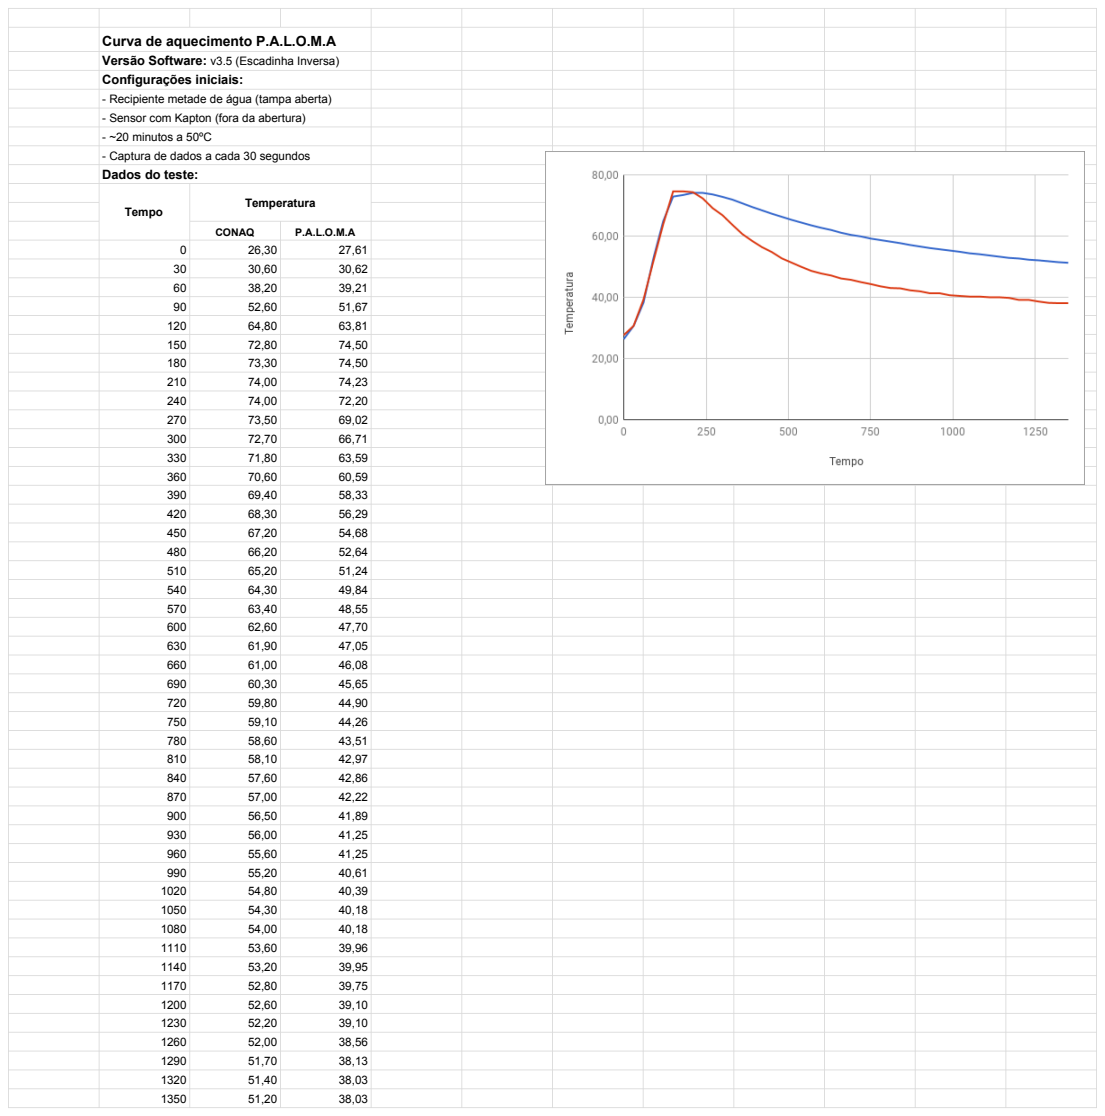
[picture p131: page 1]
Tempo; Temperatura; CONAQ

Curva de aquecimento P.A.L.O.M.A
Versão Software: v3.5 (Escadinha Inversa)
Configurações iniciais:
- Recipiente metade de água (tampa aberta)
- Sensor com Kapton (fora da abertura)
- ~20 minutos a 50ºC
- Captura de dados a cada 30 segundos
Dados do teste:
