GSimas/EEL7801/Apresentacoes/Cronograma Projeto Eletronica I.pdf

# Projeto Eletronica I

Exported on August 17, 2017 6:00:35 PM PDT; Page 1 of
