GSimas/EEL7801/software/HardwareAbstractionLayer.h

/*
 * HardwareAbstractionLayer.h
 *
 *  Created on: 21 de ago de 2017
 *      Author: André
 */

#ifndef HARDWARE_ABSTRACTION_LAYER_H_
#define HARDWARE_ABSTRACTION_LAYER_H_

/* Pins abstraction */

// Use 2 temperature sensors to get more accuracy values.
#define SENSOR_PIN_UP		A0
#define SENSOR_PIN_DOWN		A1

// Interface display pins.
#define DISPLAY_RST			12
#define DISPLAY_EN			11
#define DISPLAY_D4			5
#define DISPLAY_D5			4
#define DISPLAY_D6			3
#define DISPLAY_D7			2

// Buttons for user interation.
#define BUTTON_PLUS			7
#define BUTTON_MINUS		6
#define BUTTON_NEXT			9

// Switch for safety purposes (turn off the system when the equipment is open). 
#define SWITCH				10

// Actuators control pins.
#define ACTUATOR_RELAY		0
#define ACTUATOR_INDUCTOR   1

// LED for debug purposes. 
#define DEBUG_LED		 	13

#endif /* HARDWARE_ABSTRACTION_LAYER_H_ */
