GSimas/EEL7801/(commit log)

2017-08-04 Aula Inicial e Plano de Ensino
    adicionados pdf de aula inicial e plano de ensino
2017-08-04 Instrucoes de Projeto
    adicionada instrucoes de projeto e detalhamento projeto CONAQ (arquivo
    Jupyter Notebook)
2017-08-07 Apresentacao Problematica
    apresentacao problematica e alteracoes em detalhamento de projeto
2017-08-18 Update README.md
    atualização readme, com integrantes e referência ao site CONAQ, site UFSC, currículo acadêmico de Eng Eletronica
2017-08-24 Primeiros arquivos do software (#1)
    Código para os primeiros componentes (Display e Sensor).
2017-08-26 Estruturação do código, novos arquivos e Componentes (#1)
    Adicionados outros arquivos para melhor estruturação do código e implementados novos componentes (Atuador e Botões).
2017-08-26 Implementação do algoritmo principal (#2 e #3)
    Foi implementado a lógica básica dos menus e do sistema de controle. Além disso, algumas funções dos periféricos foram atualizadas.
2017-08-31 Update README.md
    atualização do Readme com lista de tarefas
2017-09-03 Mudança de interface e controle (#3 e #4)
    Retirado o botão de "start", mudança na sequência do menu e melhor implementação para o sistema de controle.
2017-09-07 Novas funcionalidades
    Adicionado mais um sensor (LM35) e mudança no menu (opção de voltar).
2017-09-10 Update README.md
    atualizada lista de tarefas
2017-09-12 Fotos e Apresentacao Estado Desenvolvimento
    Apresentacao Estado de Desenvolvimento em pdf
    fotos da torradeira e montagem de prototipo
2017-09-14 Documentação do Software (#5)
    Descrevendo em código a utilidade de cada função implementada. Também, foram alterados alguns nomes de variáveis e arquivos.
2017-09-14 Aprimorando a documentação do Software (#5)
    Documentando mais alguns trechos para melhor entendimento do código.
2017-09-17 Site
    desenvolvimento de site do projeto para melhor apresentacao dos
    trabalhos
2017-09-26 Update README.md
    atualizada lista de tarefas, incluido site do rep, referencias prof Aldo Wangenheim
2017-10-14 Update README.md
    atualizacao projeto 14/10/2017
    la paloma
2017-11-04 Relay e Indutor
    Modificações na lógica de botão
    Debug com LED
    (3 dias streak)
2017-11-10 Aprimoramento do código (#10 e #11)
    Arrumados os menus (evitar Display piscar indevidamente), remoção da função recursiva e adição de reset durante o processo de aquecimento.
    [hardware_abstraction.h, peripherals.cpp, peripherals.h]
2017-11-10 Aprimoramento da contagem e exibição de tempo (#6)
2017-11-11 Adicionando menu de mudança dinâmica
2017-11-11 Adicionando menu de log
2017-11-11 Adicionando função para atualizar o log
2017-11-11 Arrumando alguns bugs e atualizando todas as variáveis de log
    [peripherals.cpp, peripherals.h]
2017-11-11 Problema encontrado! (Processamento limitado)
    Terei que fazer uma otimização do código, pois o arduino atigiu o seu limite de processamento. Contudo, a feature log está quase funcional a menos de alguns pequenos bugs.
2017-11-12 Otimização do código e bug corrigido
    [ControlFunctions.h, Includes.cpp, LogFunctions.cpp, LogFunctions.h, MenuFunctions.h, PALOMASystem.ino]
2017-11-12 Arrumando bugs na aquisição de dados do log
    [ControlFunctions.cpp, Includes.h, LogFunctions.cpp, PALOMASystem.ino]
2017-11-12 Vesão sem log de dados por instabilidade no sistema
2017-11-12 Refinando medição de dados
2017-11-13 Melhorando sistema de aquecimento
2017-11-14 Manual Desenvolvedor pt1
    Manual Desenvolvedor P.A.L.O.M.A. v1.0
    Imagens no website
    (alteração nome para Pasteurizador Automático Local Operado por Microcontrolador ATMEGA)
2017-11-16 Formulario Formspree
    adicionado formulário com redirecionado para Formspree.io
    teste
2017-11-16 Botão enviar formulário
    consertado botão enviar com type submit para Formspree
2017-11-17 Update README.md
    atualizacao lista de tarefas pós protótipo 2
2017-11-20 v3.5
    versao "escadinha invertida"
    ControlProcessFlag
    Alteracao Range de temperatura em aquecimento primário
2017-11-21 Graficos de Teste
    curvas de teste de pasteruizacao e calibracao I ao XIX
2017-11-23 Manual Usuário e Canvas de produto no site
2017-11-26 Update README.md
    atualizacao lsita de tarefas pós-3º prototipo
